RavuAlHemio/eprom5vread/board/eprom5vread.kicad_pcb

## KiCad design board/eprom5vread.kicad_pcb (2024-02-01)

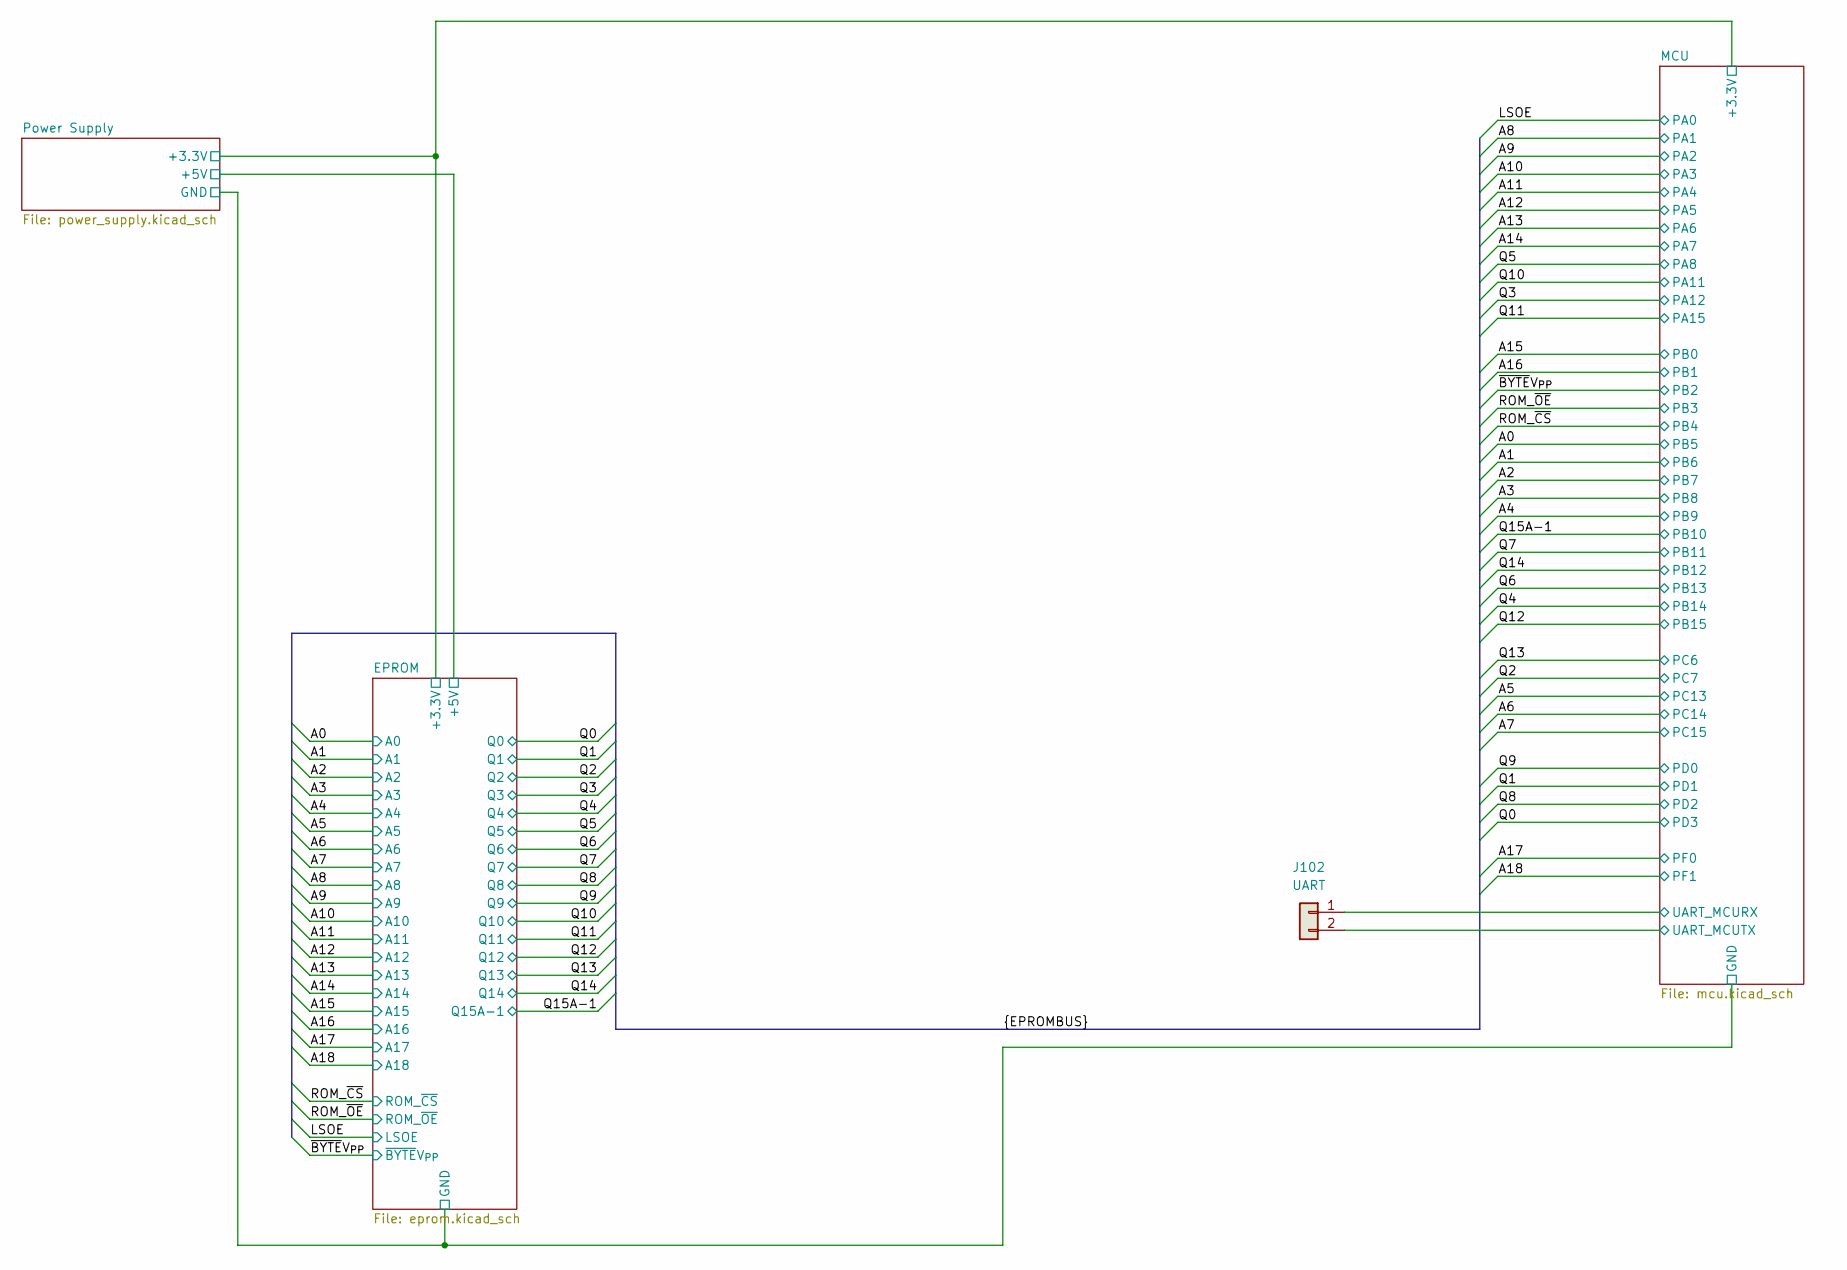
[picture p1: schematic eprom5vread.kicad_sch]

Parts:
J102: UART; PinHeader_2x01_P2.54mm_Vertical_SMD; LCSC C2884014

Connections:
/MCU/UART_MCURX: J102.1; also elsewhere on the board
/MCU/UART_MCUTX: J102.2; also elsewhere on the board

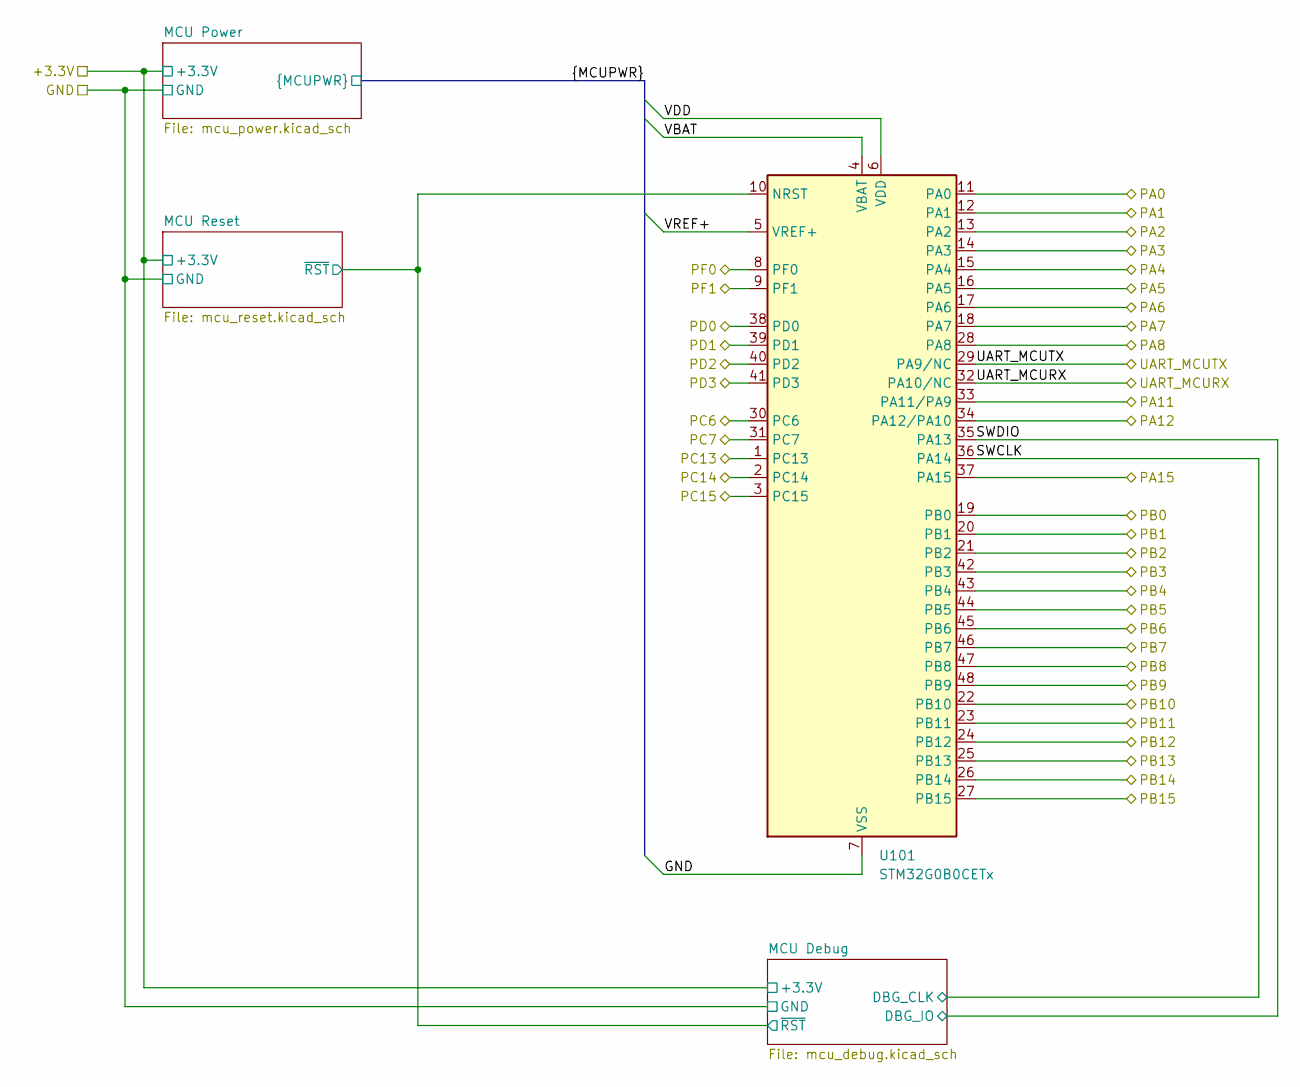
[picture p2: schematic mcu.kicad_sch]

Parts:
U101: STM32G0B0CETx; LQFP-48_7x7mm_P0.5mm; LCSC C2826978

Connections:
/A0: U101.44 (PB5); also elsewhere on the board
/A1: U101.45 (PB6); also elsewhere on the board
/A2: U101.46 (PB7); also elsewhere on the board
/A3: U101.47 (PB8); also elsewhere on the board
/A4: U101.48 (PB9); also elsewhere on the board
/A5: U101.1 (PC13); also elsewhere on the board
/A6: U101.2 (PC14); also elsewhere on the board
/A7: U101.3 (PC15); also elsewhere on the board
/A8: U101.12 (PA1); also elsewhere on the board
/A9: U101.13 (PA2); also elsewhere on the board
/A10: U101.14 (PA3); also elsewhere on the board
/A11: U101.15 (PA4); also elsewhere on the board
/A12: U101.16 (PA5); also elsewhere on the board
/A13: U101.17 (PA6); also elsewhere on the board
/A14: U101.18 (PA7); also elsewhere on the board
/A15: U101.19 (PB0); also elsewhere on the board
/A16: U101.20 (PB1); also elsewhere on the board
/A17: U101.8 (PF0); also elsewhere on the board
/A18: U101.9 (PF1); also elsewhere on the board
/EPROM/GND: U101.7 (VSS); also elsewhere on the board
/LSOE: U101.11 (PA0); also elsewhere on the board
/MCU/MCU Debug/~RST: U101.10 (NRST); also elsewhere on the board
/MCU/SWCLK: U101.36 (PA14); also elsewhere on the board
/MCU/SWDIO: U101.35 (PA13); also elsewhere on the board
/MCU/UART_MCURX: U101.32 (PA10/NC); also elsewhere on the board
/MCU/UART_MCUTX: U101.29 (PA9/NC); also elsewhere on the board
/MCU/VBAT: U101.4 (VBAT); also elsewhere on the board
/MCU/VDD: U101.6 (VDD); also elsewhere on the board
/MCU/VREF+: U101.5 (VREF+); also elsewhere on the board
/Q0: U101.41 (PD3); also elsewhere on the board
/Q1: U101.39 (PD1); also elsewhere on the board
/Q2: U101.31 (PC7); also elsewhere on the board
/Q3: U101.34 (PA12/PA10); also elsewhere on the board
/Q4: U101.26 (PB14); also elsewhere on the board
/Q5: U101.28 (PA8); also elsewhere on the board
/Q6: U101.25 (PB13); also elsewhere on the board
/Q7: U101.23 (PB11); also elsewhere on the board
/Q8: U101.40 (PD2); also elsewhere on the board
/Q9: U101.38 (PD0); also elsewhere on the board
/Q10: U101.33 (PA11/PA9); also elsewhere on the board
/Q11: U101.37 (PA15); also elsewhere on the board
/Q12: U101.27 (PB15); also elsewhere on the board
/Q13: U101.30 (PC6); also elsewhere on the board
/Q14: U101.24 (PB12); also elsewhere on the board
/Q15A-1: U101.22 (PB10); also elsewhere on the board
/ROM_~CS: U101.43 (PB4); also elsewhere on the board
/ROM_~OE: U101.42 (PB3); also elsewhere on the board
/~BYTEV_{PP}: U101.21 (PB2); also elsewhere on the board

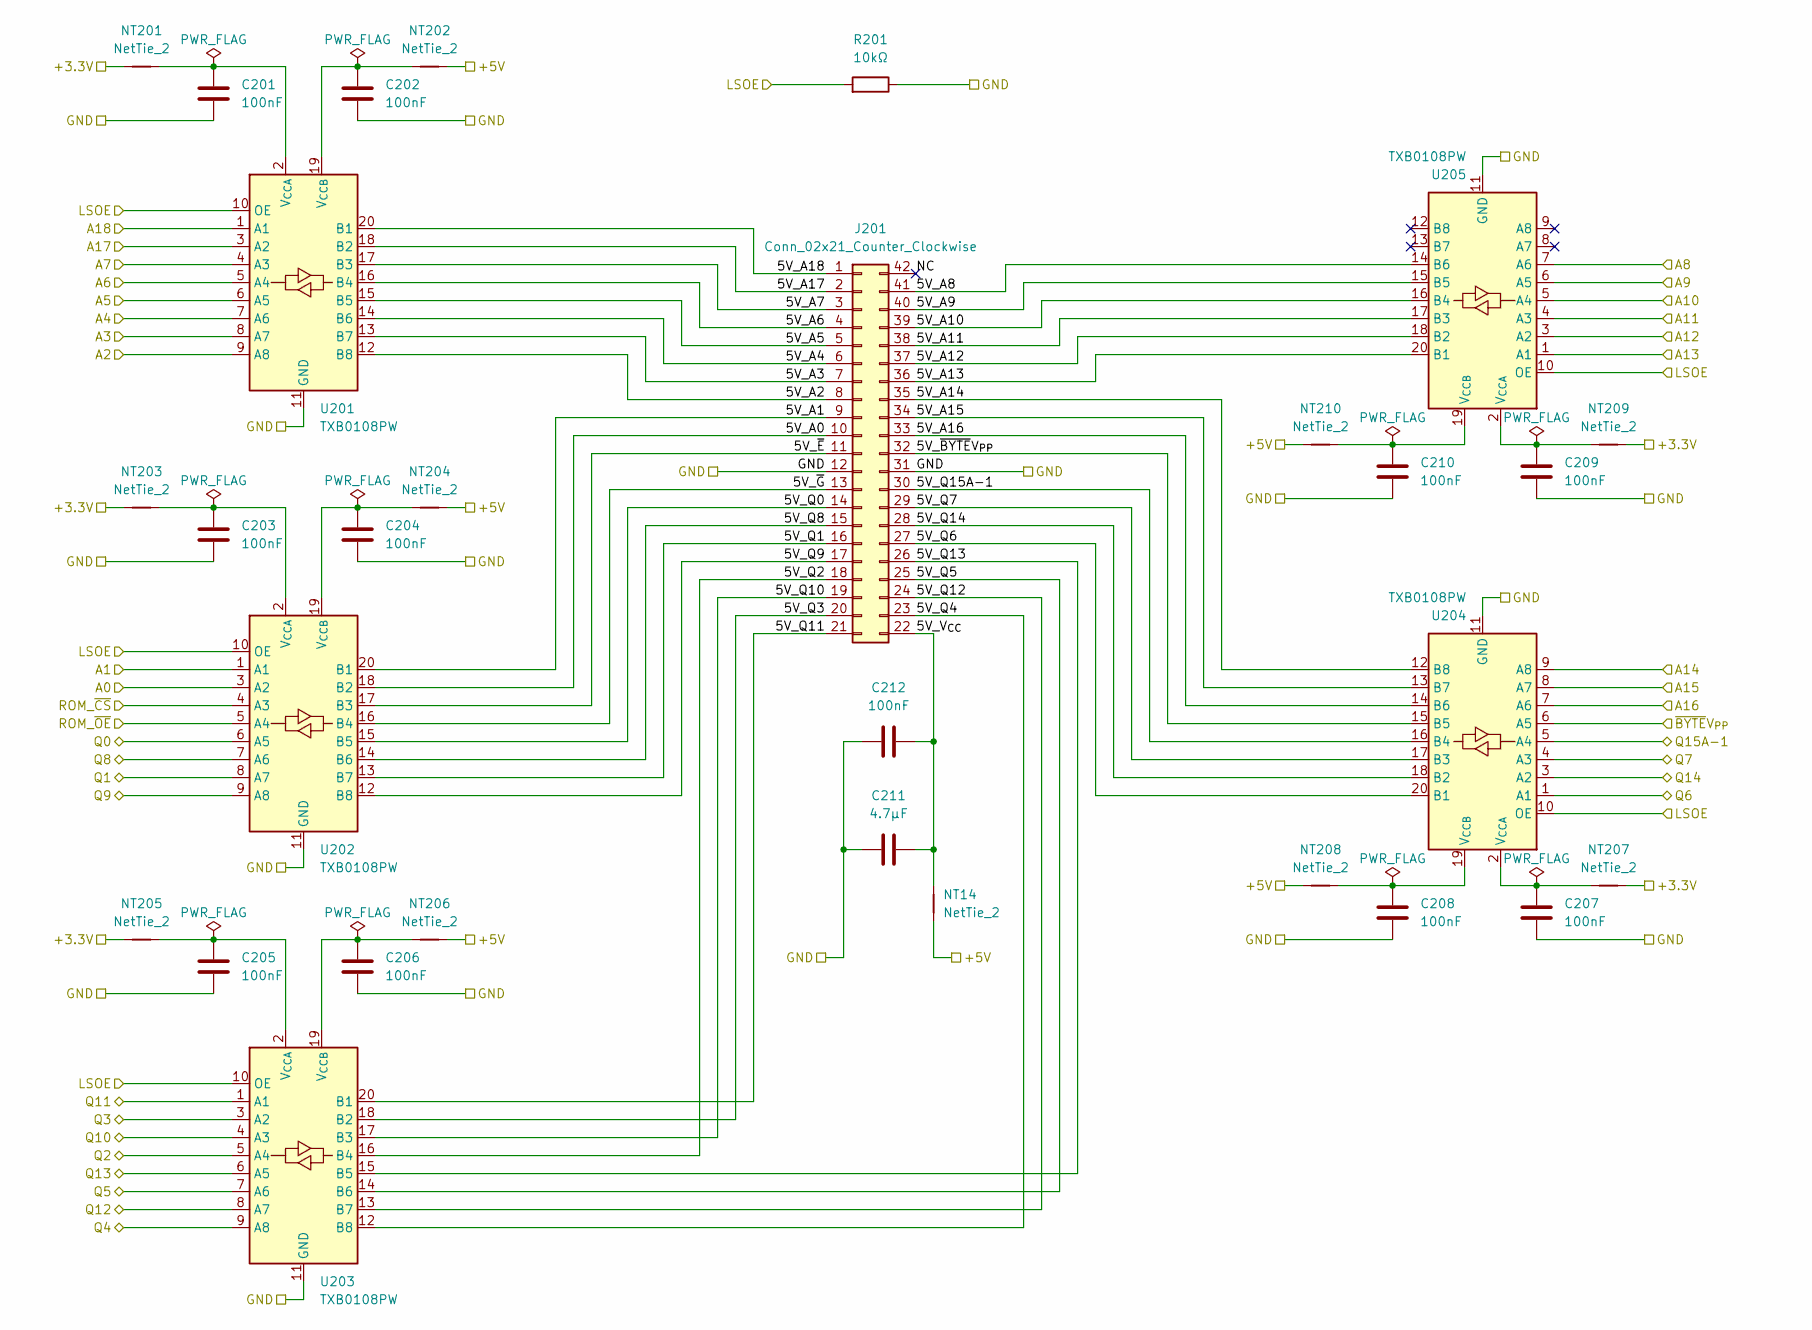
[picture p3: schematic eprom.kicad_sch]

Parts:
C201, C202, C203, C204, C205, C206, C207, C208, C209, C210, C212: 100nF; C_0402_1005Metric; LCSC C307331
C211: 4.7µF; C_0402_1005Metric; LCSC C23733
J201: Conn_02x21_Counter_Clockwise; DIP-42_W15.24mm_Socket
NT14, NT201, NT202, NT203, NT204, NT205, NT206, NT207, NT208, NT209, NT210: NetTie_2; NetTie-2_SMD_Pad0.5mm
R201: 10kΩ; R_0402_1005Metric; LCSC C100572
U201, U202, U203, U204, U205: TXB0108PW; TSSOP-20_4.4x6.5mm_P0.65mm; LCSC C53406

Connections:
/A0: U202.3 (A2); also elsewhere on the board
/A1: U202.1 (A1); also elsewhere on the board
/A2: U201.9 (A8); also elsewhere on the board
/A3: U201.8 (A7); also elsewhere on the board
/A4: U201.7 (A6); also elsewhere on the board
/A5: U201.6 (A5); also elsewhere on the board
/A6: U201.5 (A4); also elsewhere on the board
/A7: U201.4 (A3); also elsewhere on the board
/A8: U205.7 (A6); also elsewhere on the board
/A9: U205.6 (A5); also elsewhere on the board
/A10: U205.5 (A4); also elsewhere on the board
/A11: U205.4 (A3); also elsewhere on the board
/A12: U205.3 (A2); also elsewhere on the board
/A13: U205.1 (A1); also elsewhere on the board
/A14: U204.9 (A8); also elsewhere on the board
/A15: U204.8 (A7); also elsewhere on the board
/A16: U204.7 (A6); also elsewhere on the board
/A17: U201.3 (A2); also elsewhere on the board
/A18: U201.1 (A1); also elsewhere on the board
/EPROM/5V_A0: J201.10, U202.18 (B2)
/EPROM/5V_A1: J201.9, U202.20 (B1)
/EPROM/5V_A2: J201.8, U201.12 (B8)
/EPROM/5V_A3: J201.7, U201.13 (B7)
/EPROM/5V_A4: J201.6, U201.14 (B6)
/EPROM/5V_A5: J201.5, U201.15 (B5)
/EPROM/5V_A6: J201.4, U201.16 (B4)
/EPROM/5V_A7: J201.3, U201.17 (B3)
/EPROM/5V_A8: J201.41, U205.14 (B6)
/EPROM/5V_A9: J201.40, U205.15 (B5)
/EPROM/5V_A10: J201.39, U205.16 (B4)
/EPROM/5V_A11: J201.38, U205.17 (B3)
/EPROM/5V_A12: J201.37, U205.18 (B2)
/EPROM/5V_A13: J201.36, U205.20 (B1)
/EPROM/5V_A14: J201.35, U204.12 (B8)
/EPROM/5V_A15: J201.34, U204.13 (B7)
/EPROM/5V_A16: J201.33, U204.14 (B6)
/EPROM/5V_A17: J201.2, U201.18 (B2)
/EPROM/5V_A18: J201.1, U201.20 (B1)
/EPROM/5V_Q0: J201.14, U202.15 (B5)
/EPROM/5V_Q1: J201.16, U202.13 (B7)
/EPROM/5V_Q2: J201.18, U203.16 (B4)
/EPROM/5V_Q3: J201.20, U203.18 (B2)
/EPROM/5V_Q4: J201.23, U203.12 (B8)
/EPROM/5V_Q5: J201.25, U203.14 (B6)
/EPROM/5V_Q6: J201.27, U204.20 (B1)
/EPROM/5V_Q7: J201.29, U204.17 (B3)
/EPROM/5V_Q8: J201.15, U202.14 (B6)
/EPROM/5V_Q9: J201.17, U202.12 (B8)
/EPROM/5V_Q10: J201.19, U203.17 (B3)
/EPROM/5V_Q11: J201.21, U203.20 (B1)
/EPROM/5V_Q12: J201.24, U203.13 (B7)
/EPROM/5V_Q13: J201.26, U203.15 (B5)
/EPROM/5V_Q14: J201.28, U204.18 (B2)
/EPROM/5V_Q15A-1: J201.30, U204.16 (B4)
/EPROM/5V_V_{CC}: C211.2, C212.2, J201.22, NT14.2
/EPROM/5V_~BYTEV_{PP}: J201.32, U204.15 (B5)
/EPROM/5V_~E: J201.11, U202.17 (B3)
/EPROM/5V_~G: J201.13, U202.16 (B4)
/EPROM/+3.3V: NT201.1, NT203.1, NT205.1, NT207.2, NT209.2; also elsewhere on the board
/EPROM/+5V: NT14.1, NT202.2, NT204.2, NT206.2, NT208.1, NT210.1; also elsewhere on the board
/EPROM/GND: C201.2, C202.2, C203.2, C204.2, C205.2, C206.2, C207.2, C208.2, C209.2, C210.2, C211.1, C212.1, J201.12, J201.31, R201.1, U201.11 (GND), U202.11 (GND), U203.11 (GND), U204.11 (GND), U205.11 (GND); also elsewhere on the board
/EPROM/NC: J201.42
/LSOE: R201.2, U201.10 (OE), U202.10 (OE), U203.10 (OE), U204.10 (OE), U205.10 (OE); also elsewhere on the board
/Q0: U202.6 (A5); also elsewhere on the board
/Q1: U202.8 (A7); also elsewhere on the board
/Q2: U203.5 (A4); also elsewhere on the board
/Q3: U203.3 (A2); also elsewhere on the board
/Q4: U203.9 (A8); also elsewhere on the board
/Q5: U203.7 (A6); also elsewhere on the board
/Q6: U204.1 (A1); also elsewhere on the board
/Q7: U204.4 (A3); also elsewhere on the board
/Q8: U202.7 (A6); also elsewhere on the board
/Q9: U202.9 (A8); also elsewhere on the board
/Q10: U203.4 (A3); also elsewhere on the board
/Q11: U203.1 (A1); also elsewhere on the board
/Q12: U203.8 (A7); also elsewhere on the board
/Q13: U203.6 (A5); also elsewhere on the board
/Q14: U204.3 (A2); also elsewhere on the board
/Q15A-1: U204.5 (A4); also elsewhere on the board
/ROM_~CS: U202.4 (A3); also elsewhere on the board
/ROM_~OE: U202.5 (A4); also elsewhere on the board
/~BYTEV_{PP}: U204.6 (A5); also elsewhere on the board
unnamed: C201.1, NT201.2, U201.2 (V_{CCA})
unnamed: C202.1, NT202.1, U201.19 (V_{CCB})
unnamed: C203.1, NT203.2, U202.2 (V_{CCA})
unnamed: C204.1, NT204.1, U202.19 (V_{CCB})
unnamed: C205.1, NT205.2, U203.2 (V_{CCA})
unnamed: C206.1, NT206.1, U203.19 (V_{CCB})
unnamed: C207.1, NT207.1, U204.2 (V_{CCA})
unnamed: C208.1, NT208.2, U204.19 (V_{CCB})
unnamed: C209.1, NT209.1, U205.2 (V_{CCA})
unnamed: C210.1, NT210.2, U205.19 (V_{CCB})

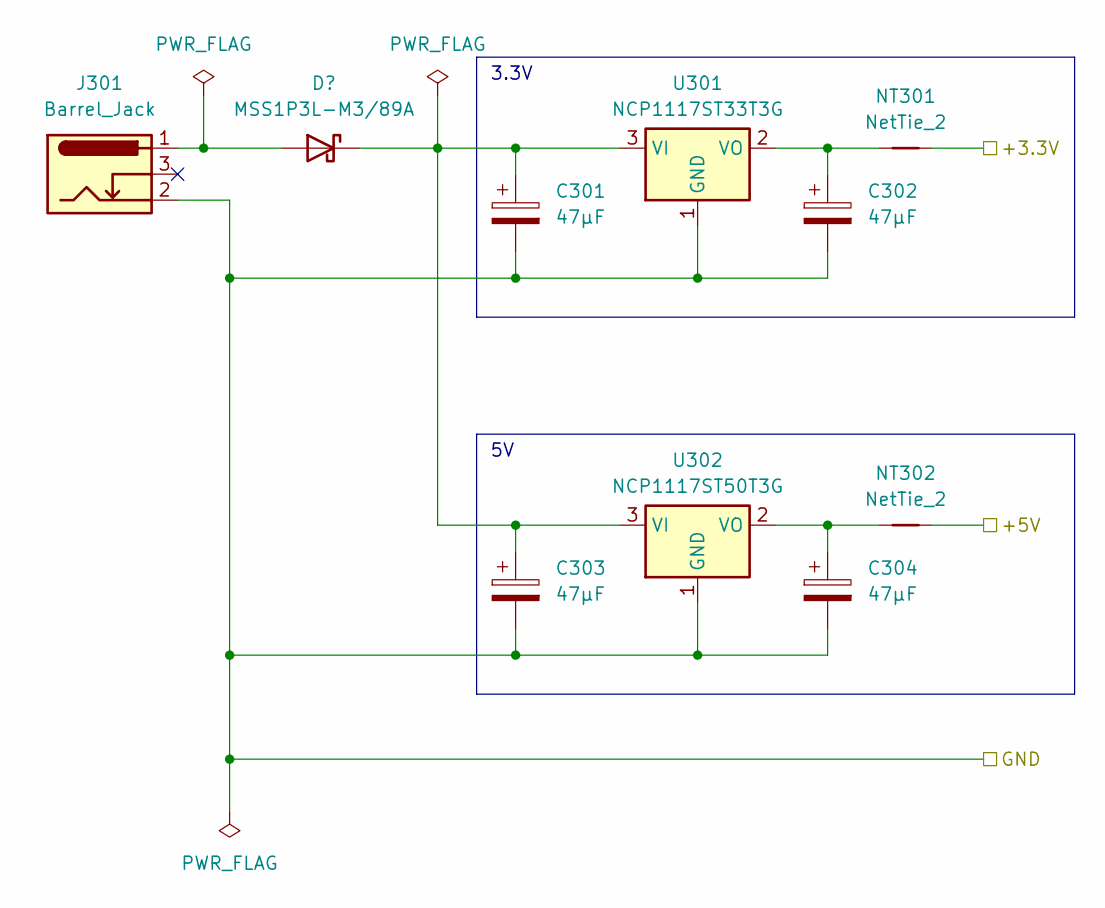
[picture p4: schematic power_supply.kicad_sch]

Parts:
C301, C302, C303, C304: 47µF; CP_EIA-7343-31_Kemet-D; LCSC C122333
D301: MSS1P3L-M3/89A; D_MicroSMP_AK; LCSC C144285
J301: Barrel_Jack; BarrelJack_CUI_PJ-036AH-SMT_Horizontal; LCSC C9900024875
NT301, NT302: NetTie_2; NetTie-2_SMD_Pad0.5mm
U301: NCP1117ST33T3G; SOT-223-3_TabPin2; LCSC C26537
U302: NCP1117ST50T3G; SOT-223-3_TabPin2; LCSC C17314

Connections:
/EPROM/+3.3V: NT301.2; also elsewhere on the board
/EPROM/+5V: NT302.2; also elsewhere on the board
/EPROM/GND: C301.2, C302.2, C303.2, C304.2, J301.2, U301.1 (GND), U302.1 (GND); also elsewhere on the board
unnamed: D301.2 (A), J301.1
unnamed: C301.1, C303.1, D301.1 (K), U301.3 (VI), U302.3 (VI)
unnamed: C302.1, NT301.1, U301.2 (VO)
unnamed: C304.1, NT302.1, U302.2 (VO)

Notes on the sheet:
3.3V

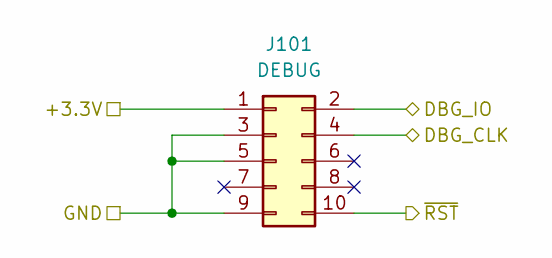
[picture p5: schematic mcu_debug.kicad_sch]

Parts:
J101: DEBUG; PinHeader_2x05_P1.27mm_Vertical_SMD

Connections:
/EPROM/+3.3V: J101.1; also elsewhere on the board
/EPROM/GND: J101.3, J101.5, J101.9; also elsewhere on the board
/MCU/MCU Debug/~RST: J101.10; also elsewhere on the board
/MCU/SWCLK: J101.4; also elsewhere on the board
/MCU/SWDIO: J101.2; also elsewhere on the board

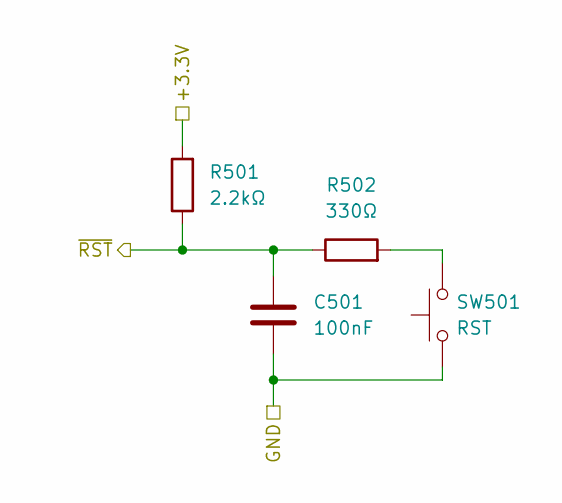
[picture p6: schematic mcu_reset.kicad_sch]

Parts:
C501: 100nF; C_0402_1005Metric; LCSC C307331
R501: 2.2kΩ; R_0402_1005Metric; LCSC C25879
R502: 330Ω; R_0402_1005Metric; LCSC C25104
SW501: RST; SW_Push_1P1T_XKB_TS-1187A; LCSC C318884

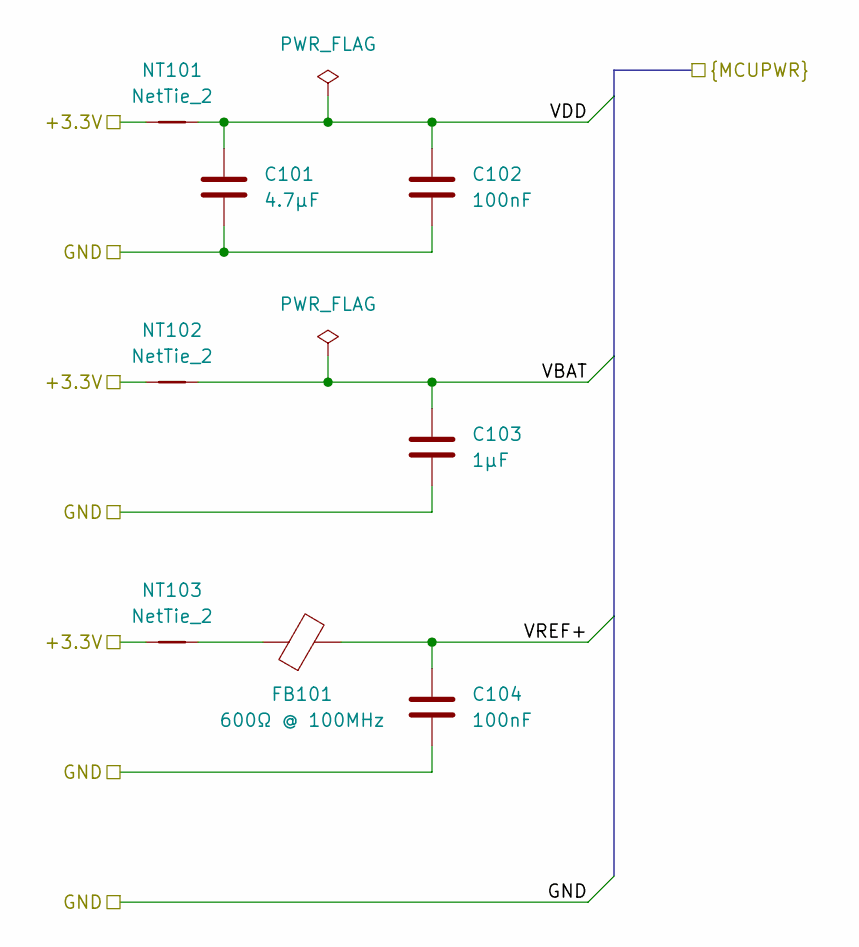
[picture p7: schematic mcu_power.kicad_sch]

Parts:
C101: 4.7µF; C_0402_1005Metric; LCSC C23733
C102, C104: 100nF; C_0402_1005Metric; LCSC C307331
C103: 1µF; C_0402_1005Metric; LCSC C52923
FB101: 600Ω @ 100MHz; L_0402_1005Metric; LCSC C98261
NT101, NT102, NT103: NetTie_2; NetTie-2_SMD_Pad0.5mm

Connections:
/EPROM/+3.3V: NT101.1, NT102.1, NT103.1; also elsewhere on the board
/EPROM/GND: C101.2, C102.2, C103.2, C104.2; also elsewhere on the board
/MCU/VBAT: C103.1, NT102.2; also elsewhere on the board
/MCU/VDD: C101.1, C102.1, NT101.2; also elsewhere on the board
/MCU/VREF+: C104.1, FB101.2; also elsewhere on the board
unnamed: FB101.1, NT103.2

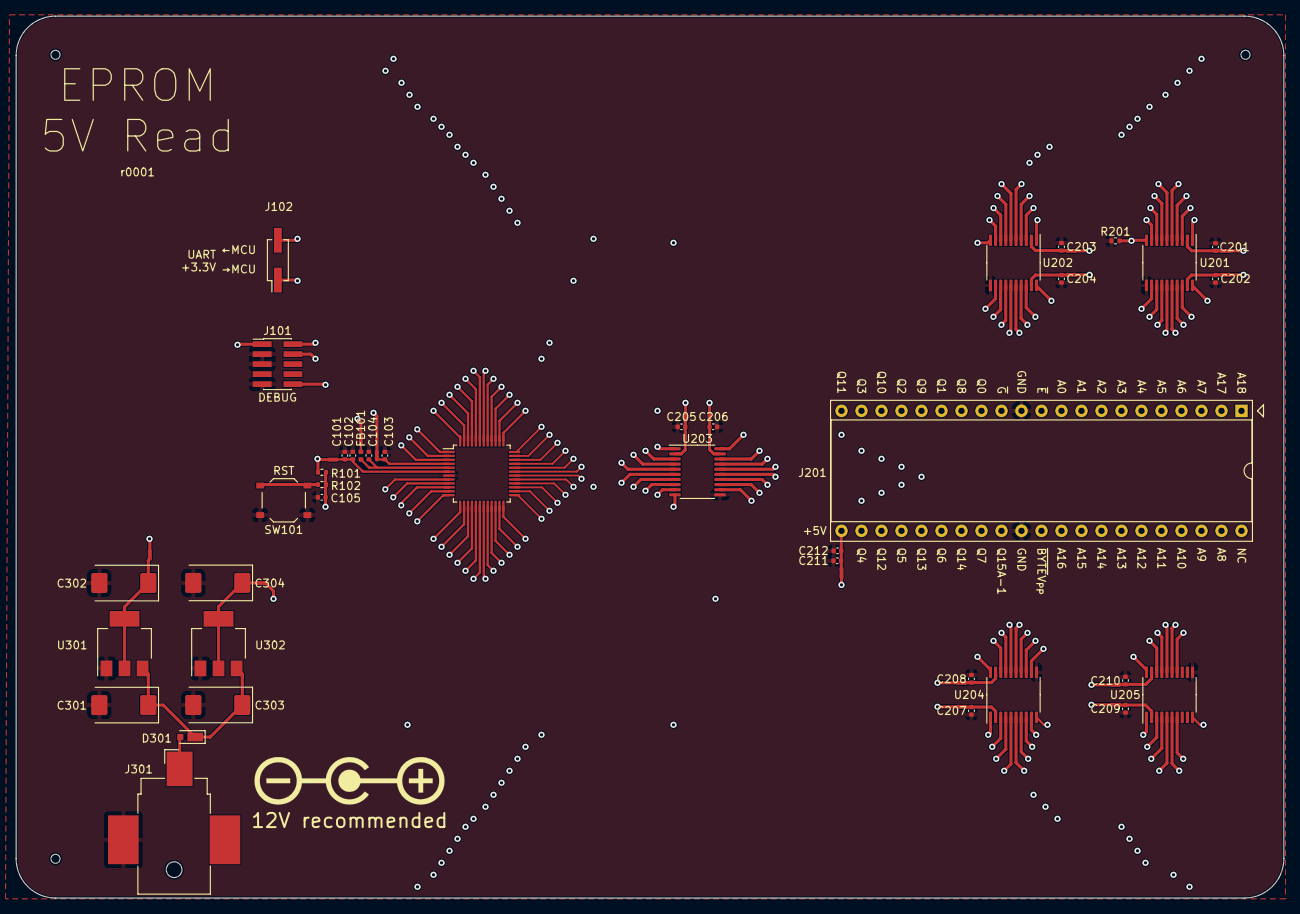
[picture p8: board eprom5vread.kicad_pcb from above]

Board: 4 copper layers, 161.0 x 112.0 mm, 59 parts (0 on the bottom side), 105 nets.

Other parts of the board:
C105: 100nF; C_0402_1005Metric
R101: 2.2kΩ; R_0402_1005Metric
R102: 330Ω; R_0402_1005Metric
REF1, REF2, REF3: JLCPCB_Mounting_Hole
REF4: Polarity_Center_Positive_6mm_SilkScreen
SW101: RST; SW_Push_1P1T_XKB_TS-1187A

Their connections:
/EPROM/+3.3V: R101.2; also elsewhere on the board
/EPROM/GND: C105.1, SW101.1; also elsewhere on the board
/MCU/MCU Debug/~RST: C105.2, R101.1, R102.1; also elsewhere on the board
unnamed: R102.2, SW101.2
