RavuAlHemio/eprom5vread/code/on_board/stm32g0b0/src/adc/adc_awd2cr.rs

#[doc = "Register `ADC_AWD2CR` reader"]
pub type R = crate::R<ADC_AWD2CR_SPEC>;
#[doc = "Register `ADC_AWD2CR` writer"]
pub type W = crate::W<ADC_AWD2CR_SPEC>;
#[doc = "Field `AWD2CH0` reader - Analog watchdog channel selection These bits are set and cleared by software. They enable and select the input channels to be guarded by analog watchdog 2 (AWD2). Note: The channels selected through ADC_AWD2CR must be also configured into the ADC_CHSELR registers. Refer to SQ8\\[3:0\\]
for a definition of channel selection. The software is allowed to write this bit only when ADSTART=0 (which ensures that no conversion is ongoing)."]
pub type AWD2CH0_R = crate::BitReader<AWD2CH0_A>;
#[doc = "Analog watchdog channel selection These bits are set and cleared by software. They enable and select the input channels to be guarded by analog watchdog 2 (AWD2). Note: The channels selected through ADC_AWD2CR must be also configured into the ADC_CHSELR registers. Refer to SQ8\\[3:0\\]
for a definition of channel selection. The software is allowed to write this bit only when ADSTART=0 (which ensures that no conversion is ongoing).\n\nValue on reset: 0"]
#[derive(Clone, Copy, Debug, PartialEq, Eq)]
pub enum AWD2CH0_A {
    #[doc = "0: ADC analog channel-x is not monitored by AWD2"]
    B_0X0 = 0,
    #[doc = "1: ADC analog channel-x is monitored by AWD2"]
    B_0X1 = 1,
}
impl From<AWD2CH0_A> for bool {
    #[inline(always)]
    fn from(variant: AWD2CH0_A) -> Self {
        variant as u8 != 0
    }
}
impl AWD2CH0_R {
    #[doc = "Get enumerated values variant"]
    #[inline(always)]
    pub const fn variant(&self) -> AWD2CH0_A {
        match self.bits {
            false => AWD2CH0_A::B_0X0,
            true => AWD2CH0_A::B_0X1,
        }
    }
    #[doc = "ADC analog channel-x is not monitored by AWD2"]
    #[inline(always)]
    pub fn is_b_0x0(&self) -> bool {
        *self == AWD2CH0_A::B_0X0
    }
    #[doc = "ADC analog channel-x is monitored by AWD2"]
    #[inline(always)]
    pub fn is_b_0x1(&self) -> bool {
        *self == AWD2CH0_A::B_0X1
    }
}
#[doc = "Field `AWD2CH0` writer - Analog watchdog channel selection These bits are set and cleared by software. They enable and select the input channels to be guarded by analog watchdog 2 (AWD2). Note: The channels selected through ADC_AWD2CR must be also configured into the ADC_CHSELR registers. Refer to SQ8\\[3:0\\]
for a definition of channel selection. The software is allowed to write this bit only when ADSTART=0 (which ensures that no conversion is ongoing)."]
pub type AWD2CH0_W<'a, REG> = crate::BitWriter<'a, REG, AWD2CH0_A>;
impl<'a, REG> AWD2CH0_W<'a, REG>
where
    REG: crate::Writable + crate::RegisterSpec,
{
    #[doc = "ADC analog channel-x is not monitored by AWD2"]
    #[inline(always)]
    pub fn b_0x0(self) -> &'a mut crate::W<REG> {
        self.variant(AWD2CH0_A::B_0X0)
    }
    #[doc = "ADC analog channel-x is monitored by AWD2"]
    #[inline(always)]
    pub fn b_0x1(self) -> &'a mut crate::W<REG> {
        self.variant(AWD2CH0_A::B_0X1)
    }
}
#[doc = "Field `AWD2CH1` reader - Analog watchdog channel selection These bits are set and cleared by software. They enable and select the input channels to be guarded by analog watchdog 2 (AWD2). Note: The channels selected through ADC_AWD2CR must be also configured into the ADC_CHSELR registers. Refer to SQ8\\[3:0\\]
for a definition of channel selection. The software is allowed to write this bit only when ADSTART=0 (which ensures that no conversion is ongoing)."]
pub type AWD2CH1_R = crate::BitReader<AWD2CH1_A>;
#[doc = "Analog watchdog channel selection These bits are set and cleared by software. They enable and select the input channels to be guarded by analog watchdog 2 (AWD2). Note: The channels selected through ADC_AWD2CR must be also configured into the ADC_CHSELR registers. Refer to SQ8\\[3:0\\]
for a definition of channel selection. The software is allowed to write this bit only when ADSTART=0 (which ensures that no conversion is ongoing).\n\nValue on reset: 0"]
#[derive(Clone, Copy, Debug, PartialEq, Eq)]
pub enum AWD2CH1_A {
    #[doc = "0: ADC analog channel-x is not monitored by AWD2"]
    B_0X0 = 0,
    #[doc = "1: ADC analog channel-x is monitored by AWD2"]
    B_0X1 = 1,
}
impl From<AWD2CH1_A> for bool {
    #[inline(always)]
    fn from(variant: AWD2CH1_A) -> Self {
        variant as u8 != 0
    }
}
impl AWD2CH1_R {
    #[doc = "Get enumerated values variant"]
    #[inline(always)]
    pub const fn variant(&self) -> AWD2CH1_A {
        match self.bits {
            false => AWD2CH1_A::B_0X0,
            true => AWD2CH1_A::B_0X1,
        }
    }
    #[doc = "ADC analog channel-x is not monitored by AWD2"]
    #[inline(always)]
    pub fn is_b_0x0(&self) -> bool {
        *self == AWD2CH1_A::B_0X0
    }
    #[doc = "ADC analog channel-x is monitored by AWD2"]
    #[inline(always)]
    pub fn is_b_0x1(&self) -> bool {
        *self == AWD2CH1_A::B_0X1
    }
}
#[doc = "Field `AWD2CH1` writer - Analog watchdog channel selection These bits are set and cleared by software. They enable and select the input channels to be guarded by analog watchdog 2 (AWD2). Note: The channels selected through ADC_AWD2CR must be also configured into the ADC_CHSELR registers. Refer to SQ8\\[3:0\\]
for a definition of channel selection. The software is allowed to write this bit only when ADSTART=0 (which ensures that no conversion is ongoing)."]
pub type AWD2CH1_W<'a, REG> = crate::BitWriter<'a, REG, AWD2CH1_A>;
impl<'a, REG> AWD2CH1_W<'a, REG>
where
    REG: crate::Writable + crate::RegisterSpec,
{
    #[doc = "ADC analog channel-x is not monitored by AWD2"]
    #[inline(always)]
    pub fn b_0x0(self) -> &'a mut crate::W<REG> {
        self.variant(AWD2CH1_A::B_0X0)
    }
    #[doc = "ADC analog channel-x is monitored by AWD2"]
    #[inline(always)]
    pub fn b_0x1(self) -> &'a mut crate::W<REG> {
        self.variant(AWD2CH1_A::B_0X1)
    }
}
#[doc = "Field `AWD2CH2` reader - Analog watchdog channel selection These bits are set and cleared by software. They enable and select the input channels to be guarded by analog watchdog 2 (AWD2). Note: The channels selected through ADC_AWD2CR must be also configured into the ADC_CHSELR registers. Refer to SQ8\\[3:0\\]
for a definition of channel selection. The software is allowed to write this bit only when ADSTART=0 (which ensures that no conversion is ongoing)."]
pub type AWD2CH2_R = crate::BitReader<AWD2CH2_A>;
#[doc = "Analog watchdog channel selection These bits are set and cleared by software. They enable and select the input channels to be guarded by analog watchdog 2 (AWD2). Note: The channels selected through ADC_AWD2CR must be also configured into the ADC_CHSELR registers. Refer to SQ8\\[3:0\\]
for a definition of channel selection. The software is allowed to write this bit only when ADSTART=0 (which ensures that no conversion is ongoing).\n\nValue on reset: 0"]
#[derive(Clone, Copy, Debug, PartialEq, Eq)]
pub enum AWD2CH2_A {
    #[doc = "0: ADC analog channel-x is not monitored by AWD2"]
    B_0X0 = 0,
    #[doc = "1: ADC analog channel-x is monitored by AWD2"]
    B_0X1 = 1,
}
impl From<AWD2CH2_A> for bool {
    #[inline(always)]
    fn from(variant: AWD2CH2_A) -> Self {
        variant as u8 != 0
    }
}
impl AWD2CH2_R {
    #[doc = "Get enumerated values variant"]
    #[inline(always)]
    pub const fn variant(&self) -> AWD2CH2_A {
        match self.bits {
            false => AWD2CH2_A::B_0X0,
            true => AWD2CH2_A::B_0X1,
        }
    }
    #[doc = "ADC analog channel-x is not monitored by AWD2"]
    #[inline(always)]
    pub fn is_b_0x0(&self) -> bool {
        *self == AWD2CH2_A::B_0X0
    }
    #[doc = "ADC analog channel-x is monitored by AWD2"]
    #[inline(always)]
    pub fn is_b_0x1(&self) -> bool {
        *self == AWD2CH2_A::B_0X1
    }
}
#[doc = "Field `AWD2CH2` writer - Analog watchdog channel selection These bits are set and cleared by software. They enable and select the input channels to be guarded by analog watchdog 2 (AWD2). Note: The channels selected through ADC_AWD2CR must be also configured into the ADC_CHSELR registers. Refer to SQ8\\[3:0\\]
for a definition of channel selection. The software is allowed to write this bit only when ADSTART=0 (which ensures that no conversion is ongoing)."]
pub type AWD2CH2_W<'a, REG> = crate::BitWriter<'a, REG, AWD2CH2_A>;
impl<'a, REG> AWD2CH2_W<'a, REG>
where
    REG: crate::Writable + crate::RegisterSpec,
{
    #[doc = "ADC analog channel-x is not monitored by AWD2"]
    #[inline(always)]
    pub fn b_0x0(self) -> &'a mut crate::W<REG> {
        self.variant(AWD2CH2_A::B_0X0)
    }
    #[doc = "ADC analog channel-x is monitored by AWD2"]
    #[inline(always)]
    pub fn b_0x1(self) -> &'a mut crate::W<REG> {
        self.variant(AWD2CH2_A::B_0X1)
    }
}
#[doc = "Field `AWD2CH3` reader - Analog watchdog channel selection These bits are set and cleared by software. They enable and select the input channels to be guarded by analog watchdog 2 (AWD2). Note: The channels selected through ADC_AWD2CR must be also configured into the ADC_CHSELR registers. Refer to SQ8\\[3:0\\]
for a definition of channel selection. The software is allowed to write this bit only when ADSTART=0 (which ensures that no conversion is ongoing)."]
pub type AWD2CH3_R = crate::BitReader<AWD2CH3_A>;
#[doc = "Analog watchdog channel selection These bits are set and cleared by software. They enable and select the input channels to be guarded by analog watchdog 2 (AWD2). Note: The channels selected through ADC_AWD2CR must be also configured into the ADC_CHSELR registers. Refer to SQ8\\[3:0\\]
for a definition of channel selection. The software is allowed to write this bit only when ADSTART=0 (which ensures that no conversion is ongoing).\n\nValue on reset: 0"]
#[derive(Clone, Copy, Debug, PartialEq, Eq)]
pub enum AWD2CH3_A {
    #[doc = "0: ADC analog channel-x is not monitored by AWD2"]
    B_0X0 = 0,
    #[doc = "1: ADC analog channel-x is monitored by AWD2"]
    B_0X1 = 1,
}
impl From<AWD2CH3_A> for bool {
    #[inline(always)]
    fn from(variant: AWD2CH3_A) -> Self {
        variant as u8 != 0
    }
}
impl AWD2CH3_R {
    #[doc = "Get enumerated values variant"]
    #[inline(always)]
    pub const fn variant(&self) -> AWD2CH3_A {
        match self.bits {
            false => AWD2CH3_A::B_0X0,
            true => AWD2CH3_A::B_0X1,
        }
    }
    #[doc = "ADC analog channel-x is not monitored by AWD2"]
    #[inline(always)]
    pub fn is_b_0x0(&self) -> bool {
        *self == AWD2CH3_A::B_0X0
    }
    #[doc = "ADC analog channel-x is monitored by AWD2"]
    #[inline(always)]
    pub fn is_b_0x1(&self) -> bool {
        *self == AWD2CH3_A::B_0X1
    }
}
#[doc = "Field `AWD2CH3` writer - Analog watchdog channel selection These bits are set and cleared by software. They enable and select the input channels to be guarded by analog watchdog 2 (AWD2). Note: The channels selected through ADC_AWD2CR must be also configured into the ADC_CHSELR registers. Refer to SQ8\\[3:0\\]
for a definition of channel selection. The software is allowed to write this bit only when ADSTART=0 (which ensures that no conversion is ongoing)."]
pub type AWD2CH3_W<'a, REG> = crate::BitWriter<'a, REG, AWD2CH3_A>;
impl<'a, REG> AWD2CH3_W<'a, REG>
where
    REG: crate::Writable + crate::RegisterSpec,
{
    #[doc = "ADC analog channel-x is not monitored by AWD2"]
    #[inline(always)]
    pub fn b_0x0(self) -> &'a mut crate::W<REG> {
        self.variant(AWD2CH3_A::B_0X0)
    }
    #[doc = "ADC analog channel-x is monitored by AWD2"]
    #[inline(always)]
    pub fn b_0x1(self) -> &'a mut crate::W<REG> {
        self.variant(AWD2CH3_A::B_0X1)
    }
}
#[doc = "Field `AWD2CH4` reader - Analog watchdog channel selection These bits are set and cleared by software. They enable and select the input channels to be guarded by analog watchdog 2 (AWD2). Note: The channels selected through ADC_AWD2CR must be also configured into the ADC_CHSELR registers. Refer to SQ8\\[3:0\\]
for a definition of channel selection. The software is allowed to write this bit only when ADSTART=0 (which ensures that no conversion is ongoing)."]
pub type AWD2CH4_R = crate::BitReader<AWD2CH4_A>;
#[doc = "Analog watchdog channel selection These bits are set and cleared by software. They enable and select the input channels to be guarded by analog watchdog 2 (AWD2). Note: The channels selected through ADC_AWD2CR must be also configured into the ADC_CHSELR registers. Refer to SQ8\\[3:0\\]
for a definition of channel selection. The software is allowed to write this bit only when ADSTART=0 (which ensures that no conversion is ongoing).\n\nValue on reset: 0"]
#[derive(Clone, Copy, Debug, PartialEq, Eq)]
pub enum AWD2CH4_A {
    #[doc = "0: ADC analog channel-x is not monitored by AWD2"]
    B_0X0 = 0,
    #[doc = "1: ADC analog channel-x is monitored by AWD2"]
    B_0X1 = 1,
}
impl From<AWD2CH4_A> for bool {
    #[inline(always)]
    fn from(variant: AWD2CH4_A) -> Self {
        variant as u8 != 0
    }
}
impl AWD2CH4_R {
    #[doc = "Get enumerated values variant"]
    #[inline(always)]
    pub const fn variant(&self) -> AWD2CH4_A {
        match self.bits {
            false => AWD2CH4_A::B_0X0,
            true => AWD2CH4_A::B_0X1,
        }
    }
    #[doc = "ADC analog channel-x is not monitored by AWD2"]
    #[inline(always)]
    pub fn is_b_0x0(&self) -> bool {
        *self == AWD2CH4_A::B_0X0
    }
    #[doc = "ADC analog channel-x is monitored by AWD2"]
    #[inline(always)]
    pub fn is_b_0x1(&self) -> bool {
        *self == AWD2CH4_A::B_0X1
    }
}
#[doc = "Field `AWD2CH4` writer - Analog watchdog channel selection These bits are set and cleared by software. They enable and select the input channels to be guarded by analog watchdog 2 (AWD2). Note: The channels selected through ADC_AWD2CR must be also configured into the ADC_CHSELR registers. Refer to SQ8\\[3:0\\]
for a definition of channel selection. The software is allowed to write this bit only when ADSTART=0 (which ensures that no conversion is ongoing)."]
pub type AWD2CH4_W<'a, REG> = crate::BitWriter<'a, REG, AWD2CH4_A>;
impl<'a, REG> AWD2CH4_W<'a, REG>
where
    REG: crate::Writable + crate::RegisterSpec,
{
    #[doc = "ADC analog channel-x is not monitored by AWD2"]
    #[inline(always)]
    pub fn b_0x0(self) -> &'a mut crate::W<REG> {
        self.variant(AWD2CH4_A::B_0X0)
    }
    #[doc = "ADC analog channel-x is monitored by AWD2"]
    #[inline(always)]
    pub fn b_0x1(self) -> &'a mut crate::W<REG> {
        self.variant(AWD2CH4_A::B_0X1)
    }
}
#[doc = "Field `AWD2CH5` reader - Analog watchdog channel selection These bits are set and cleared by software. They enable and select the input channels to be guarded by analog watchdog 2 (AWD2). Note: The channels selected through ADC_AWD2CR must be also configured into the ADC_CHSELR registers. Refer to SQ8\\[3:0\\]
for a definition of channel selection. The software is allowed to write this bit only when ADSTART=0 (which ensures that no conversion is ongoing)."]
pub type AWD2CH5_R = crate::BitReader<AWD2CH5_A>;
#[doc = "Analog watchdog channel selection These bits are set and cleared by software. They enable and select the input channels to be guarded by analog watchdog 2 (AWD2). Note: The channels selected through ADC_AWD2CR must be also configured into the ADC_CHSELR registers. Refer to SQ8\\[3:0\\]
for a definition of channel selection. The software is allowed to write this bit only when ADSTART=0 (which ensures that no conversion is ongoing).\n\nValue on reset: 0"]
#[derive(Clone, Copy, Debug, PartialEq, Eq)]
pub enum AWD2CH5_A {
    #[doc = "0: ADC analog channel-x is not monitored by AWD2"]
    B_0X0 = 0,
    #[doc = "1: ADC analog channel-x is monitored by AWD2"]
    B_0X1 = 1,
}
impl From<AWD2CH5_A> for bool {
    #[inline(always)]
    fn from(variant: AWD2CH5_A) -> Self {
        variant as u8 != 0
    }
}
impl AWD2CH5_R {
    #[doc = "Get enumerated values variant"]
    #[inline(always)]
    pub const fn variant(&self) -> AWD2CH5_A {
        match self.bits {
            false => AWD2CH5_A::B_0X0,
            true => AWD2CH5_A::B_0X1,
        }
    }
    #[doc = "ADC analog channel-x is not monitored by AWD2"]
    #[inline(always)]
    pub fn is_b_0x0(&self) -> bool {
        *self == AWD2CH5_A::B_0X0
    }
    #[doc = "ADC analog channel-x is monitored by AWD2"]
    #[inline(always)]
    pub fn is_b_0x1(&self) -> bool {
        *self == AWD2CH5_A::B_0X1
    }
}
#[doc = "Field `AWD2CH5` writer - Analog watchdog channel selection These bits are set and cleared by software. They enable and select the input channels to be guarded by analog watchdog 2 (AWD2). Note: The channels selected through ADC_AWD2CR must be also configured into the ADC_CHSELR registers. Refer to SQ8\\[3:0\\]
for a definition of channel selection. The software is allowed to write this bit only when ADSTART=0 (which ensures that no conversion is ongoing)."]
pub type AWD2CH5_W<'a, REG> = crate::BitWriter<'a, REG, AWD2CH5_A>;
impl<'a, REG> AWD2CH5_W<'a, REG>
where
    REG: crate::Writable + crate::RegisterSpec,
{
    #[doc = "ADC analog channel-x is not monitored by AWD2"]
    #[inline(always)]
    pub fn b_0x0(self) -> &'a mut crate::W<REG> {
        self.variant(AWD2CH5_A::B_0X0)
    }
    #[doc = "ADC analog channel-x is monitored by AWD2"]
    #[inline(always)]
    pub fn b_0x1(self) -> &'a mut crate::W<REG> {
        self.variant(AWD2CH5_A::B_0X1)
    }
}
#[doc = "Field `AWD2CH6` reader - Analog watchdog channel selection These bits are set and cleared by software. They enable and select the input channels to be guarded by analog watchdog 2 (AWD2). Note: The channels selected through ADC_AWD2CR must be also configured into the ADC_CHSELR registers. Refer to SQ8\\[3:0\\]
for a definition of channel selection. The software is allowed to write this bit only when ADSTART=0 (which ensures that no conversion is ongoing)."]
pub type AWD2CH6_R = crate::BitReader<AWD2CH6_A>;
#[doc = "Analog watchdog channel selection These bits are set and cleared by software. They enable and select the input channels to be guarded by analog watchdog 2 (AWD2). Note: The channels selected through ADC_AWD2CR must be also configured into the ADC_CHSELR registers. Refer to SQ8\\[3:0\\]
for a definition of channel selection. The software is allowed to write this bit only when ADSTART=0 (which ensures that no conversion is ongoing).\n\nValue on reset: 0"]
#[derive(Clone, Copy, Debug, PartialEq, Eq)]
pub enum AWD2CH6_A {
    #[doc = "0: ADC analog channel-x is not monitored by AWD2"]
    B_0X0 = 0,
    #[doc = "1: ADC analog channel-x is monitored by AWD2"]
    B_0X1 = 1,
}
impl From<AWD2CH6_A> for bool {
    #[inline(always)]
    fn from(variant: AWD2CH6_A) -> Self {
        variant as u8 != 0
    }
}
impl AWD2CH6_R {
    #[doc = "Get enumerated values variant"]
    #[inline(always)]
    pub const fn variant(&self) -> AWD2CH6_A {
        match self.bits {
            false => AWD2CH6_A::B_0X0,
            true => AWD2CH6_A::B_0X1,
        }
    }
    #[doc = "ADC analog channel-x is not monitored by AWD2"]
    #[inline(always)]
    pub fn is_b_0x0(&self) -> bool {
        *self == AWD2CH6_A::B_0X0
    }
    #[doc = "ADC analog channel-x is monitored by AWD2"]
    #[inline(always)]
    pub fn is_b_0x1(&self) -> bool {
        *self == AWD2CH6_A::B_0X1
    }
}
#[doc = "Field `AWD2CH6` writer - Analog watchdog channel selection These bits are set and cleared by software. They enable and select the input channels to be guarded by analog watchdog 2 (AWD2). Note: The channels selected through ADC_AWD2CR must be also configured into the ADC_CHSELR registers. Refer to SQ8\\[3:0\\]
for a definition of channel selection. The software is allowed to write this bit only when ADSTART=0 (which ensures that no conversion is ongoing)."]
pub type AWD2CH6_W<'a, REG> = crate::BitWriter<'a, REG, AWD2CH6_A>;
impl<'a, REG> AWD2CH6_W<'a, REG>
where
    REG: crate::Writable + crate::RegisterSpec,
{
    #[doc = "ADC analog channel-x is not monitored by AWD2"]
    #[inline(always)]
    pub fn b_0x0(self) -> &'a mut crate::W<REG> {
        self.variant(AWD2CH6_A::B_0X0)
    }
    #[doc = "ADC analog channel-x is monitored by AWD2"]
    #[inline(always)]
    pub fn b_0x1(self) -> &'a mut crate::W<REG> {
        self.variant(AWD2CH6_A::B_0X1)
    }
}
#[doc = "Field `AWD2CH7` reader - Analog watchdog channel selection These bits are set and cleared by software. They enable and select the input channels to be guarded by analog watchdog 2 (AWD2). Note: The channels selected through ADC_AWD2CR must be also configured into the ADC_CHSELR registers. Refer to SQ8\\[3:0\\]
for a definition of channel selection. The software is allowed to write this bit only when ADSTART=0 (which ensures that no conversion is ongoing)."]
pub type AWD2CH7_R = crate::BitReader<AWD2CH7_A>;
#[doc = "Analog watchdog channel selection These bits are set and cleared by software. They enable and select the input channels to be guarded by analog watchdog 2 (AWD2). Note: The channels selected through ADC_AWD2CR must be also configured into the ADC_CHSELR registers. Refer to SQ8\\[3:0\\]
for a definition of channel selection. The software is allowed to write this bit only when ADSTART=0 (which ensures that no conversion is ongoing).\n\nValue on reset: 0"]
#[derive(Clone, Copy, Debug, PartialEq, Eq)]
pub enum AWD2CH7_A {
    #[doc = "0: ADC analog channel-x is not monitored by AWD2"]
    B_0X0 = 0,
    #[doc = "1: ADC analog channel-x is monitored by AWD2"]
    B_0X1 = 1,
}
impl From<AWD2CH7_A> for bool {
    #[inline(always)]
    fn from(variant: AWD2CH7_A) -> Self {
        variant as u8 != 0
    }
}
impl AWD2CH7_R {
    #[doc = "Get enumerated values variant"]
    #[inline(always)]
    pub const fn variant(&self) -> AWD2CH7_A {
        match self.bits {
            false => AWD2CH7_A::B_0X0,
            true => AWD2CH7_A::B_0X1,
        }
    }
    #[doc = "ADC analog channel-x is not monitored by AWD2"]
    #[inline(always)]
    pub fn is_b_0x0(&self) -> bool {
        *self == AWD2CH7_A::B_0X0
    }
    #[doc = "ADC analog channel-x is monitored by AWD2"]
    #[inline(always)]
    pub fn is_b_0x1(&self) -> bool {
        *self == AWD2CH7_A::B_0X1
    }
}
#[doc = "Field `AWD2CH7` writer - Analog watchdog channel selection These bits are set and cleared by software. They enable and select the input channels to be guarded by analog watchdog 2 (AWD2). Note: The channels selected through ADC_AWD2CR must be also configured into the ADC_CHSELR registers. Refer to SQ8\\[3:0\\]
for a definition of channel selection. The software is allowed to write this bit only when ADSTART=0 (which ensures that no conversion is ongoing)."]
pub type AWD2CH7_W<'a, REG> = crate::BitWriter<'a, REG, AWD2CH7_A>;
impl<'a, REG> AWD2CH7_W<'a, REG>
where
    REG: crate::Writable + crate::RegisterSpec,
{
    #[doc = "ADC analog channel-x is not monitored by AWD2"]
    #[inline(always)]
    pub fn b_0x0(self) -> &'a mut crate::W<REG> {
        self.variant(AWD2CH7_A::B_0X0)
    }
    #[doc = "ADC analog channel-x is monitored by AWD2"]
    #[inline(always)]
    pub fn b_0x1(self) -> &'a mut crate::W<REG> {
        self.variant(AWD2CH7_A::B_0X1)
    }
}
#[doc = "Field `AWD2CH8` reader - Analog watchdog channel selection These bits are set and cleared by software. They enable and select the input channels to be guarded by analog watchdog 2 (AWD2). Note: The channels selected through ADC_AWD2CR must be also configured into the ADC_CHSELR registers. Refer to SQ8\\[3:0\\]
for a definition of channel selection. The software is allowed to write this bit only when ADSTART=0 (which ensures that no conversion is ongoing)."]
pub type AWD2CH8_R = crate::BitReader<AWD2CH8_A>;
#[doc = "Analog watchdog channel selection These bits are set and cleared by software. They enable and select the input channels to be guarded by analog watchdog 2 (AWD2). Note: The channels selected through ADC_AWD2CR must be also configured into the ADC_CHSELR registers. Refer to SQ8\\[3:0\\]
for a definition of channel selection. The software is allowed to write this bit only when ADSTART=0 (which ensures that no conversion is ongoing).\n\nValue on reset: 0"]
#[derive(Clone, Copy, Debug, PartialEq, Eq)]
pub enum AWD2CH8_A {
    #[doc = "0: ADC analog channel-x is not monitored by AWD2"]
    B_0X0 = 0,
    #[doc = "1: ADC analog channel-x is monitored by AWD2"]
    B_0X1 = 1,
}
impl From<AWD2CH8_A> for bool {
    #[inline(always)]
    fn from(variant: AWD2CH8_A) -> Self {
        variant as u8 != 0
    }
}
impl AWD2CH8_R {
    #[doc = "Get enumerated values variant"]
    #[inline(always)]
    pub const fn variant(&self) -> AWD2CH8_A {
        match self.bits {
            false => AWD2CH8_A::B_0X0,
            true => AWD2CH8_A::B_0X1,
        }
    }
    #[doc = "ADC analog channel-x is not monitored by AWD2"]
    #[inline(always)]
    pub fn is_b_0x0(&self) -> bool {
        *self == AWD2CH8_A::B_0X0
    }
    #[doc = "ADC analog channel-x is monitored by AWD2"]
    #[inline(always)]
    pub fn is_b_0x1(&self) -> bool {
        *self == AWD2CH8_A::B_0X1
    }
}
#[doc = "Field `AWD2CH8` writer - Analog watchdog channel selection These bits are set and cleared by software. They enable and select the input channels to be guarded by analog watchdog 2 (AWD2). Note: The channels selected through ADC_AWD2CR must be also configured into the ADC_CHSELR registers. Refer to SQ8\\[3:0\\]
for a definition of channel selection. The software is allowed to write this bit only when ADSTART=0 (which ensures that no conversion is ongoing)."]
pub type AWD2CH8_W<'a, REG> = crate::BitWriter<'a, REG, AWD2CH8_A>;
impl<'a, REG> AWD2CH8_W<'a, REG>
where
    REG: crate::Writable + crate::RegisterSpec,
{
    #[doc = "ADC analog channel-x is not monitored by AWD2"]
    #[inline(always)]
    pub fn b_0x0(self) -> &'a mut crate::W<REG> {
        self.variant(AWD2CH8_A::B_0X0)
    }
    #[doc = "ADC analog channel-x is monitored by AWD2"]
    #[inline(always)]
    pub fn b_0x1(self) -> &'a mut crate::W<REG> {
        self.variant(AWD2CH8_A::B_0X1)
    }
}
#[doc = "Field `AWD2CH9` reader - Analog watchdog channel selection These bits are set and cleared by software. They enable and select the input channels to be guarded by analog watchdog 2 (AWD2). Note: The channels selected through ADC_AWD2CR must be also configured into the ADC_CHSELR registers. Refer to SQ8\\[3:0\\]
for a definition of channel selection. The software is allowed to write this bit only when ADSTART=0 (which ensures that no conversion is ongoing)."]
pub type AWD2CH9_R = crate::BitReader<AWD2CH9_A>;
#[doc = "Analog watchdog channel selection These bits are set and cleared by software. They enable and select the input channels to be guarded by analog watchdog 2 (AWD2). Note: The channels selected through ADC_AWD2CR must be also configured into the ADC_CHSELR registers. Refer to SQ8\\[3:0\\]
for a definition of channel selection. The software is allowed to write this bit only when ADSTART=0 (which ensures that no conversion is ongoing).\n\nValue on reset: 0"]
#[derive(Clone, Copy, Debug, PartialEq, Eq)]
pub enum AWD2CH9_A {
    #[doc = "0: ADC analog channel-x is not monitored by AWD2"]
    B_0X0 = 0,
    #[doc = "1: ADC analog channel-x is monitored by AWD2"]
    B_0X1 = 1,
}
impl From<AWD2CH9_A> for bool {
    #[inline(always)]
    fn from(variant: AWD2CH9_A) -> Self {
        variant as u8 != 0
    }
}
impl AWD2CH9_R {
    #[doc = "Get enumerated values variant"]
    #[inline(always)]
    pub const fn variant(&self) -> AWD2CH9_A {
        match self.bits {
            false => AWD2CH9_A::B_0X0,
            true => AWD2CH9_A::B_0X1,
        }
    }
    #[doc = "ADC analog channel-x is not monitored by AWD2"]
    #[inline(always)]
    pub fn is_b_0x0(&self) -> bool {
        *self == AWD2CH9_A::B_0X0
    }
    #[doc = "ADC analog channel-x is monitored by AWD2"]
    #[inline(always)]
    pub fn is_b_0x1(&self) -> bool {
        *self == AWD2CH9_A::B_0X1
    }
}
#[doc = "Field `AWD2CH9` writer - Analog watchdog channel selection These bits are set and cleared by software. They enable and select the input channels to be guarded by analog watchdog 2 (AWD2). Note: The channels selected through ADC_AWD2CR must be also configured into the ADC_CHSELR registers. Refer to SQ8\\[3:0\\]
for a definition of channel selection. The software is allowed to write this bit only when ADSTART=0 (which ensures that no conversion is ongoing)."]
pub type AWD2CH9_W<'a, REG> = crate::BitWriter<'a, REG, AWD2CH9_A>;
impl<'a, REG> AWD2CH9_W<'a, REG>
where
    REG: crate::Writable + crate::RegisterSpec,
{
    #[doc = "ADC analog channel-x is not monitored by AWD2"]
    #[inline(always)]
    pub fn b_0x0(self) -> &'a mut crate::W<REG> {
        self.variant(AWD2CH9_A::B_0X0)
    }
    #[doc = "ADC analog channel-x is monitored by AWD2"]
    #[inline(always)]
    pub fn b_0x1(self) -> &'a mut crate::W<REG> {
        self.variant(AWD2CH9_A::B_0X1)
    }
}
#[doc = "Field `AWD2CH10` reader - Analog watchdog channel selection These bits are set and cleared by software. They enable and select the input channels to be guarded by analog watchdog 2 (AWD2). Note: The channels selected through ADC_AWD2CR must be also configured into the ADC_CHSELR registers. Refer to SQ8\\[3:0\\]
for a definition of channel selection. The software is allowed to write this bit only when ADSTART=0 (which ensures that no conversion is ongoing)."]
pub type AWD2CH10_R = crate::BitReader<AWD2CH10_A>;
#[doc = "Analog watchdog channel selection These bits are set and cleared by software. They enable and select the input channels to be guarded by analog watchdog 2 (AWD2). Note: The channels selected through ADC_AWD2CR must be also configured into the ADC_CHSELR registers. Refer to SQ8\\[3:0\\]
for a definition of channel selection. The software is allowed to write this bit only when ADSTART=0 (which ensures that no conversion is ongoing).\n\nValue on reset: 0"]
#[derive(Clone, Copy, Debug, PartialEq, Eq)]
pub enum AWD2CH10_A {
    #[doc = "0: ADC analog channel-x is not monitored by AWD2"]
    B_0X0 = 0,
    #[doc = "1: ADC analog channel-x is monitored by AWD2"]
    B_0X1 = 1,
}
impl From<AWD2CH10_A> for bool {
    #[inline(always)]
    fn from(variant: AWD2CH10_A) -> Self {
        variant as u8 != 0
    }
}
impl AWD2CH10_R {
    #[doc = "Get enumerated values variant"]
    #[inline(always)]
    pub const fn variant(&self) -> AWD2CH10_A {
        match self.bits {
            false => AWD2CH10_A::B_0X0,
            true => AWD2CH10_A::B_0X1,
        }
    }
    #[doc = "ADC analog channel-x is not monitored by AWD2"]
    #[inline(always)]
    pub fn is_b_0x0(&self) -> bool {
        *self == AWD2CH10_A::B_0X0
    }
    #[doc = "ADC analog channel-x is monitored by AWD2"]
    #[inline(always)]
    pub fn is_b_0x1(&self) -> bool {
        *self == AWD2CH10_A::B_0X1
    }
}
#[doc = "Field `AWD2CH10` writer - Analog watchdog channel selection These bits are set and cleared by software. They enable and select the input channels to be guarded by analog watchdog 2 (AWD2). Note: The channels selected through ADC_AWD2CR must be also configured into the ADC_CHSELR registers. Refer to SQ8\\[3:0\\]
for a definition of channel selection. The software is allowed to write this bit only when ADSTART=0 (which ensures that no conversion is ongoing)."]
pub type AWD2CH10_W<'a, REG> = crate::BitWriter<'a, REG, AWD2CH10_A>;
impl<'a, REG> AWD2CH10_W<'a, REG>
where
    REG: crate::Writable + crate::RegisterSpec,
{
    #[doc = "ADC analog channel-x is not monitored by AWD2"]
    #[inline(always)]
    pub fn b_0x0(self) -> &'a mut crate::W<REG> {
        self.variant(AWD2CH10_A::B_0X0)
    }
    #[doc = "ADC analog channel-x is monitored by AWD2"]
    #[inline(always)]
    pub fn b_0x1(self) -> &'a mut crate::W<REG> {
        self.variant(AWD2CH10_A::B_0X1)
    }
}
#[doc = "Field `AWD2CH11` reader - Analog watchdog channel selection These bits are set and cleared by software. They enable and select the input channels to be guarded by analog watchdog 2 (AWD2). Note: The channels selected through ADC_AWD2CR must be also configured into the ADC_CHSELR registers. Refer to SQ8\\[3:0\\]
for a definition of channel selection. The software is allowed to write this bit only when ADSTART=0 (which ensures that no conversion is ongoing)."]
pub type AWD2CH11_R = crate::BitReader<AWD2CH11_A>;
#[doc = "Analog watchdog channel selection These bits are set and cleared by software. They enable and select the input channels to be guarded by analog watchdog 2 (AWD2). Note: The channels selected through ADC_AWD2CR must be also configured into the ADC_CHSELR registers. Refer to SQ8\\[3:0\\]
for a definition of channel selection. The software is allowed to write this bit only when ADSTART=0 (which ensures that no conversion is ongoing).\n\nValue on reset: 0"]
#[derive(Clone, Copy, Debug, PartialEq, Eq)]
pub enum AWD2CH11_A {
    #[doc = "0: ADC analog channel-x is not monitored by AWD2"]
    B_0X0 = 0,
    #[doc = "1: ADC analog channel-x is monitored by AWD2"]
    B_0X1 = 1,
}
impl From<AWD2CH11_A> for bool {
    #[inline(always)]
    fn from(variant: AWD2CH11_A) -> Self {
        variant as u8 != 0
    }
}
impl AWD2CH11_R {
    #[doc = "Get enumerated values variant"]
    #[inline(always)]
    pub const fn variant(&self) -> AWD2CH11_A {
        match self.bits {
            false => AWD2CH11_A::B_0X0,
            true => AWD2CH11_A::B_0X1,
        }
    }
    #[doc = "ADC analog channel-x is not monitored by AWD2"]
    #[inline(always)]
    pub fn is_b_0x0(&self) -> bool {
        *self == AWD2CH11_A::B_0X0
    }
    #[doc = "ADC analog channel-x is monitored by AWD2"]
    #[inline(always)]
    pub fn is_b_0x1(&self) -> bool {
        *self == AWD2CH11_A::B_0X1
    }
}
#[doc = "Field `AWD2CH11` writer - Analog watchdog channel selection These bits are set and cleared by software. They enable and select the input channels to be guarded by analog watchdog 2 (AWD2). Note: The channels selected through ADC_AWD2CR must be also configured into the ADC_CHSELR registers. Refer to SQ8\\[3:0\\]
for a definition of channel selection. The software is allowed to write this bit only when ADSTART=0 (which ensures that no conversion is ongoing)."]
pub type AWD2CH11_W<'a, REG> = crate::BitWriter<'a, REG, AWD2CH11_A>;
impl<'a, REG> AWD2CH11_W<'a, REG>
where
    REG: crate::Writable + crate::RegisterSpec,
{
    #[doc = "ADC analog channel-x is not monitored by AWD2"]
    #[inline(always)]
    pub fn b_0x0(self) -> &'a mut crate::W<REG> {
        self.variant(AWD2CH11_A::B_0X0)
    }
    #[doc = "ADC analog channel-x is monitored by AWD2"]
    #[inline(always)]
    pub fn b_0x1(self) -> &'a mut crate::W<REG> {
        self.variant(AWD2CH11_A::B_0X1)
    }
}
#[doc = "Field `AWD2CH12` reader - Analog watchdog channel selection These bits are set and cleared by software. They enable and select the input channels to be guarded by analog watchdog 2 (AWD2). Note: The channels selected through ADC_AWD2CR must be also configured into the ADC_CHSELR registers. Refer to SQ8\\[3:0\\]
for a definition of channel selection. The software is allowed to write this bit only when ADSTART=0 (which ensures that no conversion is ongoing)."]
pub type AWD2CH12_R = crate::BitReader<AWD2CH12_A>;
#[doc = "Analog watchdog channel selection These bits are set and cleared by software. They enable and select the input channels to be guarded by analog watchdog 2 (AWD2). Note: The channels selected through ADC_AWD2CR must be also configured into the ADC_CHSELR registers. Refer to SQ8\\[3:0\\]
for a definition of channel selection. The software is allowed to write this bit only when ADSTART=0 (which ensures that no conversion is ongoing).\n\nValue on reset: 0"]
#[derive(Clone, Copy, Debug, PartialEq, Eq)]
pub enum AWD2CH12_A {
    #[doc = "0: ADC analog channel-x is not monitored by AWD2"]
    B_0X0 = 0,
    #[doc = "1: ADC analog channel-x is monitored by AWD2"]
    B_0X1 = 1,
}
impl From<AWD2CH12_A> for bool {
    #[inline(always)]
    fn from(variant: AWD2CH12_A) -> Self {
        variant as u8 != 0
    }
}
impl AWD2CH12_R {
    #[doc = "Get enumerated values variant"]
    #[inline(always)]
    pub const fn variant(&self) -> AWD2CH12_A {
        match self.bits {
            false => AWD2CH12_A::B_0X0,
            true => AWD2CH12_A::B_0X1,
        }
    }
    #[doc = "ADC analog channel-x is not monitored by AWD2"]
    #[inline(always)]
    pub fn is_b_0x0(&self) -> bool {
        *self == AWD2CH12_A::B_0X0
    }
    #[doc = "ADC analog channel-x is monitored by AWD2"]
    #[inline(always)]
    pub fn is_b_0x1(&self) -> bool {
        *self == AWD2CH12_A::B_0X1
    }
}
#[doc = "Field `AWD2CH12` writer - Analog watchdog channel selection These bits are set and cleared by software. They enable and select the input channels to be guarded by analog watchdog 2 (AWD2). Note: The channels selected through ADC_AWD2CR must be also configured into the ADC_CHSELR registers. Refer to SQ8\\[3:0\\]
for a definition of channel selection. The software is allowed to write this bit only when ADSTART=0 (which ensures that no conversion is ongoing)."]
pub type AWD2CH12_W<'a, REG> = crate::BitWriter<'a, REG, AWD2CH12_A>;
impl<'a, REG> AWD2CH12_W<'a, REG>
where
    REG: crate::Writable + crate::RegisterSpec,
{
    #[doc = "ADC analog channel-x is not monitored by AWD2"]
    #[inline(always)]
    pub fn b_0x0(self) -> &'a mut crate::W<REG> {
        self.variant(AWD2CH12_A::B_0X0)
    }
    #[doc = "ADC analog channel-x is monitored by AWD2"]
    #[inline(always)]
    pub fn b_0x1(self) -> &'a mut crate::W<REG> {
        self.variant(AWD2CH12_A::B_0X1)
    }
}
#[doc = "Field `AWD2CH13` reader - Analog watchdog channel selection These bits are set and cleared by software. They enable and select the input channels to be guarded by analog watchdog 2 (AWD2). Note: The channels selected through ADC_AWD2CR must be also configured into the ADC_CHSELR registers. Refer to SQ8\\[3:0\\]
for a definition of channel selection. The software is allowed to write this bit only when ADSTART=0 (which ensures that no conversion is ongoing)."]
pub type AWD2CH13_R = crate::BitReader<AWD2CH13_A>;
#[doc = "Analog watchdog channel selection These bits are set and cleared by software. They enable and select the input channels to be guarded by analog watchdog 2 (AWD2). Note: The channels selected through ADC_AWD2CR must be also configured into the ADC_CHSELR registers. Refer to SQ8\\[3:0\\]
for a definition of channel selection. The software is allowed to write this bit only when ADSTART=0 (which ensures that no conversion is ongoing).\n\nValue on reset: 0"]
#[derive(Clone, Copy, Debug, PartialEq, Eq)]
pub enum AWD2CH13_A {
    #[doc = "0: ADC analog channel-x is not monitored by AWD2"]
    B_0X0 = 0,
    #[doc = "1: ADC analog channel-x is monitored by AWD2"]
    B_0X1 = 1,
}
impl From<AWD2CH13_A> for bool {
    #[inline(always)]
    fn from(variant: AWD2CH13_A) -> Self {
        variant as u8 != 0
    }
}
impl AWD2CH13_R {
    #[doc = "Get enumerated values variant"]
    #[inline(always)]
    pub const fn variant(&self) -> AWD2CH13_A {
        match self.bits {
            false => AWD2CH13_A::B_0X0,
            true => AWD2CH13_A::B_0X1,
        }
    }
    #[doc = "ADC analog channel-x is not monitored by AWD2"]
    #[inline(always)]
    pub fn is_b_0x0(&self) -> bool {
        *self == AWD2CH13_A::B_0X0
    }
    #[doc = "ADC analog channel-x is monitored by AWD2"]
    #[inline(always)]
    pub fn is_b_0x1(&self) -> bool {
        *self == AWD2CH13_A::B_0X1
    }
}
#[doc = "Field `AWD2CH13` writer - Analog watchdog channel selection These bits are set and cleared by software. They enable and select the input channels to be guarded by analog watchdog 2 (AWD2). Note: The channels selected through ADC_AWD2CR must be also configured into the ADC_CHSELR registers. Refer to SQ8\\[3:0\\]
for a definition of channel selection. The software is allowed to write this bit only when ADSTART=0 (which ensures that no conversion is ongoing)."]
pub type AWD2CH13_W<'a, REG> = crate::BitWriter<'a, REG, AWD2CH13_A>;
impl<'a, REG> AWD2CH13_W<'a, REG>
where
    REG: crate::Writable + crate::RegisterSpec,
{
    #[doc = "ADC analog channel-x is not monitored by AWD2"]
    #[inline(always)]
    pub fn b_0x0(self) -> &'a mut crate::W<REG> {
        self.variant(AWD2CH13_A::B_0X0)
    }
    #[doc = "ADC analog channel-x is monitored by AWD2"]
    #[inline(always)]
    pub fn b_0x1(self) -> &'a mut crate::W<REG> {
        self.variant(AWD2CH13_A::B_0X1)
    }
}
#[doc = "Field `AWD2CH14` reader - Analog watchdog channel selection These bits are set and cleared by software. They enable and select the input channels to be guarded by analog watchdog 2 (AWD2). Note: The channels selected through ADC_AWD2CR must be also configured into the ADC_CHSELR registers. Refer to SQ8\\[3:0\\]
for a definition of channel selection. The software is allowed to write this bit only when ADSTART=0 (which ensures that no conversion is ongoing)."]
pub type AWD2CH14_R = crate::BitReader<AWD2CH14_A>;
#[doc = "Analog watchdog channel selection These bits are set and cleared by software. They enable and select the input channels to be guarded by analog watchdog 2 (AWD2). Note: The channels selected through ADC_AWD2CR must be also configured into the ADC_CHSELR registers. Refer to SQ8\\[3:0\\]
for a definition of channel selection. The software is allowed to write this bit only when ADSTART=0 (which ensures that no conversion is ongoing).\n\nValue on reset: 0"]
#[derive(Clone, Copy, Debug, PartialEq, Eq)]
pub enum AWD2CH14_A {
    #[doc = "0: ADC analog channel-x is not monitored by AWD2"]
    B_0X0 = 0,
    #[doc = "1: ADC analog channel-x is monitored by AWD2"]
    B_0X1 = 1,
}
impl From<AWD2CH14_A> for bool {
    #[inline(always)]
    fn from(variant: AWD2CH14_A) -> Self {
        variant as u8 != 0
    }
}
impl AWD2CH14_R {
    #[doc = "Get enumerated values variant"]
    #[inline(always)]
    pub const fn variant(&self) -> AWD2CH14_A {
        match self.bits {
            false => AWD2CH14_A::B_0X0,
            true => AWD2CH14_A::B_0X1,
        }
    }
    #[doc = "ADC analog channel-x is not monitored by AWD2"]
    #[inline(always)]
    pub fn is_b_0x0(&self) -> bool {
        *self == AWD2CH14_A::B_0X0
    }
    #[doc = "ADC analog channel-x is monitored by AWD2"]
    #[inline(always)]
    pub fn is_b_0x1(&self) -> bool {
        *self == AWD2CH14_A::B_0X1
    }
}
#[doc = "Field `AWD2CH14` writer - Analog watchdog channel selection These bits are set and cleared by software. They enable and select the input channels to be guarded by analog watchdog 2 (AWD2). Note: The channels selected through ADC_AWD2CR must be also configured into the ADC_CHSELR registers. Refer to SQ8\\[3:0\\]
for a definition of channel selection. The software is allowed to write this bit only when ADSTART=0 (which ensures that no conversion is ongoing)."]
pub type AWD2CH14_W<'a, REG> = crate::BitWriter<'a, REG, AWD2CH14_A>;
impl<'a, REG> AWD2CH14_W<'a, REG>
where
    REG: crate::Writable + crate::RegisterSpec,
{
    #[doc = "ADC analog channel-x is not monitored by AWD2"]
    #[inline(always)]
    pub fn b_0x0(self) -> &'a mut crate::W<REG> {
        self.variant(AWD2CH14_A::B_0X0)
    }
    #[doc = "ADC analog channel-x is monitored by AWD2"]
    #[inline(always)]
    pub fn b_0x1(self) -> &'a mut crate::W<REG> {
        self.variant(AWD2CH14_A::B_0X1)
    }
}
#[doc = "Field `AWD2CH15` reader - Analog watchdog channel selection These bits are set and cleared by software. They enable and select the input channels to be guarded by analog watchdog 2 (AWD2). Note: The channels selected through ADC_AWD2CR must be also configured into the ADC_CHSELR registers. Refer to SQ8\\[3:0\\]
for a definition of channel selection. The software is allowed to write this bit only when ADSTART=0 (which ensures that no conversion is ongoing)."]
pub type AWD2CH15_R = crate::BitReader<AWD2CH15_A>;
#[doc = "Analog watchdog channel selection These bits are set and cleared by software. They enable and select the input channels to be guarded by analog watchdog 2 (AWD2). Note: The channels selected through ADC_AWD2CR must be also configured into the ADC_CHSELR registers. Refer to SQ8\\[3:0\\]
for a definition of channel selection. The software is allowed to write this bit only when ADSTART=0 (which ensures that no conversion is ongoing).\n\nValue on reset: 0"]
#[derive(Clone, Copy, Debug, PartialEq, Eq)]
pub enum AWD2CH15_A {
    #[doc = "0: ADC analog channel-x is not monitored by AWD2"]
    B_0X0 = 0,
    #[doc = "1: ADC analog channel-x is monitored by AWD2"]
    B_0X1 = 1,
}
impl From<AWD2CH15_A> for bool {
    #[inline(always)]
    fn from(variant: AWD2CH15_A) -> Self {
        variant as u8 != 0
    }
}
impl AWD2CH15_R {
    #[doc = "Get enumerated values variant"]
    #[inline(always)]
    pub const fn variant(&self) -> AWD2CH15_A {
        match self.bits {
            false => AWD2CH15_A::B_0X0,
            true => AWD2CH15_A::B_0X1,
        }
    }
    #[doc = "ADC analog channel-x is not monitored by AWD2"]
    #[inline(always)]
    pub fn is_b_0x0(&self) -> bool {
        *self == AWD2CH15_A::B_0X0
    }
    #[doc = "ADC analog channel-x is monitored by AWD2"]
    #[inline(always)]
    pub fn is_b_0x1(&self) -> bool {
        *self == AWD2CH15_A::B_0X1
    }
}
#[doc = "Field `AWD2CH15` writer - Analog watchdog channel selection These bits are set and cleared by software. They enable and select the input channels to be guarded by analog watchdog 2 (AWD2). Note: The channels selected through ADC_AWD2CR must be also configured into the ADC_CHSELR registers. Refer to SQ8\\[3:0\\]
for a definition of channel selection. The software is allowed to write this bit only when ADSTART=0 (which ensures that no conversion is ongoing)."]
pub type AWD2CH15_W<'a, REG> = crate::BitWriter<'a, REG, AWD2CH15_A>;
impl<'a, REG> AWD2CH15_W<'a, REG>
where
    REG: crate::Writable + crate::RegisterSpec,
{
    #[doc = "ADC analog channel-x is not monitored by AWD2"]
    #[inline(always)]
    pub fn b_0x0(self) -> &'a mut crate::W<REG> {
        self.variant(AWD2CH15_A::B_0X0)
    }
    #[doc = "ADC analog channel-x is monitored by AWD2"]
    #[inline(always)]
    pub fn b_0x1(self) -> &'a mut crate::W<REG> {
        self.variant(AWD2CH15_A::B_0X1)
    }
}
#[doc = "Field `AWD2CH16` reader - Analog watchdog channel selection These bits are set and cleared by software. They enable and select the input channels to be guarded by analog watchdog 2 (AWD2). Note: The channels selected through ADC_AWD2CR must be also configured into the ADC_CHSELR registers. Refer to SQ8\\[3:0\\]
for a definition of channel selection. The software is allowed to write this bit only when ADSTART=0 (which ensures that no conversion is ongoing)."]
pub type AWD2CH16_R = crate::BitReader<AWD2CH16_A>;
#[doc = "Analog watchdog channel selection These bits are set and cleared by software. They enable and select the input channels to be guarded by analog watchdog 2 (AWD2). Note: The channels selected through ADC_AWD2CR must be also configured into the ADC_CHSELR registers. Refer to SQ8\\[3:0\\]
for a definition of channel selection. The software is allowed to write this bit only when ADSTART=0 (which ensures that no conversion is ongoing).\n\nValue on reset: 0"]
#[derive(Clone, Copy, Debug, PartialEq, Eq)]
pub enum AWD2CH16_A {
    #[doc = "0: ADC analog channel-x is not monitored by AWD2"]
    B_0X0 = 0,
    #[doc = "1: ADC analog channel-x is monitored by AWD2"]
    B_0X1 = 1,
}
impl From<AWD2CH16_A> for bool {
    #[inline(always)]
    fn from(variant: AWD2CH16_A) -> Self {
        variant as u8 != 0
    }
}
impl AWD2CH16_R {
    #[doc = "Get enumerated values variant"]
    #[inline(always)]
    pub const fn variant(&self) -> AWD2CH16_A {
        match self.bits {
            false => AWD2CH16_A::B_0X0,
            true => AWD2CH16_A::B_0X1,
        }
    }
    #[doc = "ADC analog channel-x is not monitored by AWD2"]
    #[inline(always)]
    pub fn is_b_0x0(&self) -> bool {
        *self == AWD2CH16_A::B_0X0
    }
    #[doc = "ADC analog channel-x is monitored by AWD2"]
    #[inline(always)]
    pub fn is_b_0x1(&self) -> bool {
        *self == AWD2CH16_A::B_0X1
    }
}
#[doc = "Field `AWD2CH16` writer - Analog watchdog channel selection These bits are set and cleared by software. They enable and select the input channels to be guarded by analog watchdog 2 (AWD2). Note: The channels selected through ADC_AWD2CR must be also configured into the ADC_CHSELR registers. Refer to SQ8\\[3:0\\]
for a definition of channel selection. The software is allowed to write this bit only when ADSTART=0 (which ensures that no conversion is ongoing)."]
pub type AWD2CH16_W<'a, REG> = crate::BitWriter<'a, REG, AWD2CH16_A>;
impl<'a, REG> AWD2CH16_W<'a, REG>
where
    REG: crate::Writable + crate::RegisterSpec,
{
    #[doc = "ADC analog channel-x is not monitored by AWD2"]
    #[inline(always)]
    pub fn b_0x0(self) -> &'a mut crate::W<REG> {
        self.variant(AWD2CH16_A::B_0X0)
    }
    #[doc = "ADC analog channel-x is monitored by AWD2"]
    #[inline(always)]
    pub fn b_0x1(self) -> &'a mut crate::W<REG> {
        self.variant(AWD2CH16_A::B_0X1)
    }
}
#[doc = "Field `AWD2CH17` reader - Analog watchdog channel selection These bits are set and cleared by software. They enable and select the input channels to be guarded by analog watchdog 2 (AWD2). Note: The channels selected through ADC_AWD2CR must be also configured into the ADC_CHSELR registers. Refer to SQ8\\[3:0\\]
for a definition of channel selection. The software is allowed to write this bit only when ADSTART=0 (which ensures that no conversion is ongoing)."]
pub type AWD2CH17_R = crate::BitReader<AWD2CH17_A>;
#[doc = "Analog watchdog channel selection These bits are set and cleared by software. They enable and select the input channels to be guarded by analog watchdog 2 (AWD2). Note: The channels selected through ADC_AWD2CR must be also configured into the ADC_CHSELR registers. Refer to SQ8\\[3:0\\]
for a definition of channel selection. The software is allowed to write this bit only when ADSTART=0 (which ensures that no conversion is ongoing).\n\nValue on reset: 0"]
#[derive(Clone, Copy, Debug, PartialEq, Eq)]
pub enum AWD2CH17_A {
    #[doc = "0: ADC analog channel-x is not monitored by AWD2"]
    B_0X0 = 0,
    #[doc = "1: ADC analog channel-x is monitored by AWD2"]
    B_0X1 = 1,
}
impl From<AWD2CH17_A> for bool {
    #[inline(always)]
    fn from(variant: AWD2CH17_A) -> Self {
        variant as u8 != 0
    }
}
impl AWD2CH17_R {
    #[doc = "Get enumerated values variant"]
    #[inline(always)]
    pub const fn variant(&self) -> AWD2CH17_A {
        match self.bits {
            false => AWD2CH17_A::B_0X0,
            true => AWD2CH17_A::B_0X1,
        }
    }
    #[doc = "ADC analog channel-x is not monitored by AWD2"]
    #[inline(always)]
    pub fn is_b_0x0(&self) -> bool {
        *self == AWD2CH17_A::B_0X0
    }
    #[doc = "ADC analog channel-x is monitored by AWD2"]
    #[inline(always)]
    pub fn is_b_0x1(&self) -> bool {
        *self == AWD2CH17_A::B_0X1
    }
}
#[doc = "Field `AWD2CH17` writer - Analog watchdog channel selection These bits are set and cleared by software. They enable and select the input channels to be guarded by analog watchdog 2 (AWD2). Note: The channels selected through ADC_AWD2CR must be also configured into the ADC_CHSELR registers. Refer to SQ8\\[3:0\\]
for a definition of channel selection. The software is allowed to write this bit only when ADSTART=0 (which ensures that no conversion is ongoing)."]
pub type AWD2CH17_W<'a, REG> = crate::BitWriter<'a, REG, AWD2CH17_A>;
impl<'a, REG> AWD2CH17_W<'a, REG>
where
    REG: crate::Writable + crate::RegisterSpec,
{
    #[doc = "ADC analog channel-x is not monitored by AWD2"]
    #[inline(always)]
    pub fn b_0x0(self) -> &'a mut crate::W<REG> {
        self.variant(AWD2CH17_A::B_0X0)
    }
    #[doc = "ADC analog channel-x is monitored by AWD2"]
    #[inline(always)]
    pub fn b_0x1(self) -> &'a mut crate::W<REG> {
        self.variant(AWD2CH17_A::B_0X1)
    }
}
#[doc = "Field `AWD2CH18` reader - Analog watchdog channel selection These bits are set and cleared by software. They enable and select the input channels to be guarded by analog watchdog 2 (AWD2). Note: The channels selected through ADC_AWD2CR must be also configured into the ADC_CHSELR registers. Refer to SQ8\\[3:0\\]
for a definition of channel selection. The software is allowed to write this bit only when ADSTART=0 (which ensures that no conversion is ongoing)."]
pub type AWD2CH18_R = crate::BitReader<AWD2CH18_A>;
#[doc = "Analog watchdog channel selection These bits are set and cleared by software. They enable and select the input channels to be guarded by analog watchdog 2 (AWD2). Note: The channels selected through ADC_AWD2CR must be also configured into the ADC_CHSELR registers. Refer to SQ8\\[3:0\\]
for a definition of channel selection. The software is allowed to write this bit only when ADSTART=0 (which ensures that no conversion is ongoing).\n\nValue on reset: 0"]
#[derive(Clone, Copy, Debug, PartialEq, Eq)]
pub enum AWD2CH18_A {
    #[doc = "0: ADC analog channel-x is not monitored by AWD2"]
    B_0X0 = 0,
    #[doc = "1: ADC analog channel-x is monitored by AWD2"]
    B_0X1 = 1,
}
impl From<AWD2CH18_A> for bool {
    #[inline(always)]
    fn from(variant: AWD2CH18_A) -> Self {
        variant as u8 != 0
    }
}
impl AWD2CH18_R {
    #[doc = "Get enumerated values variant"]
    #[inline(always)]
    pub const fn variant(&self) -> AWD2CH18_A {
        match self.bits {
            false => AWD2CH18_A::B_0X0,
            true => AWD2CH18_A::B_0X1,
        }
    }
    #[doc = "ADC analog channel-x is not monitored by AWD2"]
    #[inline(always)]
    pub fn is_b_0x0(&self) -> bool {
        *self == AWD2CH18_A::B_0X0
    }
    #[doc = "ADC analog channel-x is monitored by AWD2"]
    #[inline(always)]
    pub fn is_b_0x1(&self) -> bool {
        *self == AWD2CH18_A::B_0X1
    }
}
#[doc = "Field `AWD2CH18` writer - Analog watchdog channel selection These bits are set and cleared by software. They enable and select the input channels to be guarded by analog watchdog 2 (AWD2). Note: The channels selected through ADC_AWD2CR must be also configured into the ADC_CHSELR registers. Refer to SQ8\\[3:0\\]
for a definition of channel selection. The software is allowed to write this bit only when ADSTART=0 (which ensures that no conversion is ongoing)."]
pub type AWD2CH18_W<'a, REG> = crate::BitWriter<'a, REG, AWD2CH18_A>;
impl<'a, REG> AWD2CH18_W<'a, REG>
where
    REG: crate::Writable + crate::RegisterSpec,
{
    #[doc = "ADC analog channel-x is not monitored by AWD2"]
    #[inline(always)]
    pub fn b_0x0(self) -> &'a mut crate::W<REG> {
        self.variant(AWD2CH18_A::B_0X0)
    }
    #[doc = "ADC analog channel-x is monitored by AWD2"]
    #[inline(always)]
    pub fn b_0x1(self) -> &'a mut crate::W<REG> {
        self.variant(AWD2CH18_A::B_0X1)
    }
}
impl R {
    #[doc = "Bit 0 - Analog watchdog channel selection These bits are set and cleared by software. They enable and select the input channels to be guarded by analog watchdog 2 (AWD2). Note: The channels selected through ADC_AWD2CR must be also configured into the ADC_CHSELR registers. Refer to SQ8\\[3:0\\]
for a definition of channel selection. The software is allowed to write this bit only when ADSTART=0 (which ensures that no conversion is ongoing)."]
    #[inline(always)]
    pub fn awd2ch0(&self) -> AWD2CH0_R {
        AWD2CH0_R::new((self.bits & 1) != 0)
    }
    #[doc = "Bit 1 - Analog watchdog channel selection These bits are set and cleared by software. They enable and select the input channels to be guarded by analog watchdog 2 (AWD2). Note: The channels selected through ADC_AWD2CR must be also configured into the ADC_CHSELR registers. Refer to SQ8\\[3:0\\]
for a definition of channel selection. The software is allowed to write this bit only when ADSTART=0 (which ensures that no conversion is ongoing)."]
    #[inline(always)]
    pub fn awd2ch1(&self) -> AWD2CH1_R {
        AWD2CH1_R::new(((self.bits >> 1) & 1) != 0)
    }
    #[doc = "Bit 2 - Analog watchdog channel selection These bits are set and cleared by software. They enable and select the input channels to be guarded by analog watchdog 2 (AWD2). Note: The channels selected through ADC_AWD2CR must be also configured into the ADC_CHSELR registers. Refer to SQ8\\[3:0\\]
for a definition of channel selection. The software is allowed to write this bit only when ADSTART=0 (which ensures that no conversion is ongoing)."]
    #[inline(always)]
    pub fn awd2ch2(&self) -> AWD2CH2_R {
        AWD2CH2_R::new(((self.bits >> 2) & 1) != 0)
    }
    #[doc = "Bit 3 - Analog watchdog channel selection These bits are set and cleared by software. They enable and select the input channels to be guarded by analog watchdog 2 (AWD2). Note: The channels selected through ADC_AWD2CR must be also configured into the ADC_CHSELR registers. Refer to SQ8\\[3:0\\]
for a definition of channel selection. The software is allowed to write this bit only when ADSTART=0 (which ensures that no conversion is ongoing)."]
    #[inline(always)]
    pub fn awd2ch3(&self) -> AWD2CH3_R {
        AWD2CH3_R::new(((self.bits >> 3) & 1) != 0)
    }
    #[doc = "Bit 4 - Analog watchdog channel selection These bits are set and cleared by software. They enable and select the input channels to be guarded by analog watchdog 2 (AWD2). Note: The channels selected through ADC_AWD2CR must be also configured into the ADC_CHSELR registers. Refer to SQ8\\[3:0\\]
for a definition of channel selection. The software is allowed to write this bit only when ADSTART=0 (which ensures that no conversion is ongoing)."]
    #[inline(always)]
    pub fn awd2ch4(&self) -> AWD2CH4_R {
        AWD2CH4_R::new(((self.bits >> 4) & 1) != 0)
    }
    #[doc = "Bit 5 - Analog watchdog channel selection These bits are set and cleared by software. They enable and select the input channels to be guarded by analog watchdog 2 (AWD2). Note: The channels selected through ADC_AWD2CR must be also configured into the ADC_CHSELR registers. Refer to SQ8\\[3:0\\]
for a definition of channel selection. The software is allowed to write this bit only when ADSTART=0 (which ensures that no conversion is ongoing)."]
    #[inline(always)]
    pub fn awd2ch5(&self) -> AWD2CH5_R {
        AWD2CH5_R::new(((self.bits >> 5) & 1) != 0)
    }
    #[doc = "Bit 6 - Analog watchdog channel selection These bits are set and cleared by software. They enable and select the input channels to be guarded by analog watchdog 2 (AWD2). Note: The channels selected through ADC_AWD2CR must be also configured into the ADC_CHSELR registers. Refer to SQ8\\[3:0\\]
for a definition of channel selection. The software is allowed to write this bit only when ADSTART=0 (which ensures that no conversion is ongoing)."]
    #[inline(always)]
    pub fn awd2ch6(&self) -> AWD2CH6_R {
        AWD2CH6_R::new(((self.bits >> 6) & 1) != 0)
    }
    #[doc = "Bit 7 - Analog watchdog channel selection These bits are set and cleared by software. They enable and select the input channels to be guarded by analog watchdog 2 (AWD2). Note: The channels selected through ADC_AWD2CR must be also configured into the ADC_CHSELR registers. Refer to SQ8\\[3:0\\]
for a definition of channel selection. The software is allowed to write this bit only when ADSTART=0 (which ensures that no conversion is ongoing)."]
    #[inline(always)]
    pub fn awd2ch7(&self) -> AWD2CH7_R {
        AWD2CH7_R::new(((self.bits >> 7) & 1) != 0)
    }
    #[doc = "Bit 8 - Analog watchdog channel selection These bits are set and cleared by software. They enable and select the input channels to be guarded by analog watchdog 2 (AWD2). Note: The channels selected through ADC_AWD2CR must be also configured into the ADC_CHSELR registers. Refer to SQ8\\[3:0\\]
for a definition of channel selection. The software is allowed to write this bit only when ADSTART=0 (which ensures that no conversion is ongoing)."]
    #[inline(always)]
    pub fn awd2ch8(&self) -> AWD2CH8_R {
        AWD2CH8_R::new(((self.bits >> 8) & 1) != 0)
    }
    #[doc = "Bit 9 - Analog watchdog channel selection These bits are set and cleared by software. They enable and select the input channels to be guarded by analog watchdog 2 (AWD2). Note: The channels selected through ADC_AWD2CR must be also configured into the ADC_CHSELR registers. Refer to SQ8\\[3:0\\]
for a definition of channel selection. The software is allowed to write this bit only when ADSTART=0 (which ensures that no conversion is ongoing)."]
    #[inline(always)]
    pub fn awd2ch9(&self) -> AWD2CH9_R {
        AWD2CH9_R::new(((self.bits >> 9) & 1) != 0)
    }
    #[doc = "Bit 10 - Analog watchdog channel selection These bits are set and cleared by software. They enable and select the input channels to be guarded by analog watchdog 2 (AWD2). Note: The channels selected through ADC_AWD2CR must be also configured into the ADC_CHSELR registers. Refer to SQ8\\[3:0\\]
for a definition of channel selection. The software is allowed to write this bit only when ADSTART=0 (which ensures that no conversion is ongoing)."]
    #[inline(always)]
    pub fn awd2ch10(&self) -> AWD2CH10_R {
        AWD2CH10_R::new(((self.bits >> 10) & 1) != 0)
    }
    #[doc = "Bit 11 - Analog watchdog channel selection These bits are set and cleared by software. They enable and select the input channels to be guarded by analog watchdog 2 (AWD2). Note: The channels selected through ADC_AWD2CR must be also configured into the ADC_CHSELR registers. Refer to SQ8\\[3:0\\]
for a definition of channel selection. The software is allowed to write this bit only when ADSTART=0 (which ensures that no conversion is ongoing)."]
    #[inline(always)]
    pub fn awd2ch11(&self) -> AWD2CH11_R {
        AWD2CH11_R::new(((self.bits >> 11) & 1) != 0)
    }
    #[doc = "Bit 12 - Analog watchdog channel selection These bits are set and cleared by software. They enable and select the input channels to be guarded by analog watchdog 2 (AWD2). Note: The channels selected through ADC_AWD2CR must be also configured into the ADC_CHSELR registers. Refer to SQ8\\[3:0\\]
for a definition of channel selection. The software is allowed to write this bit only when ADSTART=0 (which ensures that no conversion is ongoing)."]
    #[inline(always)]
    pub fn awd2ch12(&self) -> AWD2CH12_R {
        AWD2CH12_R::new(((self.bits >> 12) & 1) != 0)
    }
    #[doc = "Bit 13 - Analog watchdog channel selection These bits are set and cleared by software. They enable and select the input channels to be guarded by analog watchdog 2 (AWD2). Note: The channels selected through ADC_AWD2CR must be also configured into the ADC_CHSELR registers. Refer to SQ8\\[3:0\\]
for a definition of channel selection. The software is allowed to write this bit only when ADSTART=0 (which ensures that no conversion is ongoing)."]
    #[inline(always)]
    pub fn awd2ch13(&self) -> AWD2CH13_R {
        AWD2CH13_R::new(((self.bits >> 13) & 1) != 0)
    }
    #[doc = "Bit 14 - Analog watchdog channel selection These bits are set and cleared by software. They enable and select the input channels to be guarded by analog watchdog 2 (AWD2). Note: The channels selected through ADC_AWD2CR must be also configured into the ADC_CHSELR registers. Refer to SQ8\\[3:0\\]
for a definition of channel selection. The software is allowed to write this bit only when ADSTART=0 (which ensures that no conversion is ongoing)."]
    #[inline(always)]
    pub fn awd2ch14(&self) -> AWD2CH14_R {
        AWD2CH14_R::new(((self.bits >> 14) & 1) != 0)
    }
    #[doc = "Bit 15 - Analog watchdog channel selection These bits are set and cleared by software. They enable and select the input channels to be guarded by analog watchdog 2 (AWD2). Note: The channels selected through ADC_AWD2CR must be also configured into the ADC_CHSELR registers. Refer to SQ8\\[3:0\\]
for a definition of channel selection. The software is allowed to write this bit only when ADSTART=0 (which ensures that no conversion is ongoing)."]
    #[inline(always)]
    pub fn awd2ch15(&self) -> AWD2CH15_R {
        AWD2CH15_R::new(((self.bits >> 15) & 1) != 0)
    }
    #[doc = "Bit 16 - Analog watchdog channel selection These bits are set and cleared by software. They enable and select the input channels to be guarded by analog watchdog 2 (AWD2). Note: The channels selected through ADC_AWD2CR must be also configured into the ADC_CHSELR registers. Refer to SQ8\\[3:0\\]
for a definition of channel selection. The software is allowed to write this bit only when ADSTART=0 (which ensures that no conversion is ongoing)."]
    #[inline(always)]
    pub fn awd2ch16(&self) -> AWD2CH16_R {
        AWD2CH16_R::new(((self.bits >> 16) & 1) != 0)
    }
    #[doc = "Bit 17 - Analog watchdog channel selection These bits are set and cleared by software. They enable and select the input channels to be guarded by analog watchdog 2 (AWD2). Note: The channels selected through ADC_AWD2CR must be also configured into the ADC_CHSELR registers. Refer to SQ8\\[3:0\\]
for a definition of channel selection. The software is allowed to write this bit only when ADSTART=0 (which ensures that no conversion is ongoing)."]
    #[inline(always)]
    pub fn awd2ch17(&self) -> AWD2CH17_R {
        AWD2CH17_R::new(((self.bits >> 17) & 1) != 0)
    }
    #[doc = "Bit 18 - Analog watchdog channel selection These bits are set and cleared by software. They enable and select the input channels to be guarded by analog watchdog 2 (AWD2). Note: The channels selected through ADC_AWD2CR must be also configured into the ADC_CHSELR registers. Refer to SQ8\\[3:0\\]
for a definition of channel selection. The software is allowed to write this bit only when ADSTART=0 (which ensures that no conversion is ongoing)."]
    #[inline(always)]
    pub fn awd2ch18(&self) -> AWD2CH18_R {
        AWD2CH18_R::new(((self.bits >> 18) & 1) != 0)
    }
}
impl W {
    #[doc = "Bit 0 - Analog watchdog channel selection These bits are set and cleared by software. They enable and select the input channels to be guarded by analog watchdog 2 (AWD2). Note: The channels selected through ADC_AWD2CR must be also configured into the ADC_CHSELR registers. Refer to SQ8\\[3:0\\]
for a definition of channel selection. The software is allowed to write this bit only when ADSTART=0 (which ensures that no conversion is ongoing)."]
    #[inline(always)]
    #[must_use]
    pub fn awd2ch0(&mut self) -> AWD2CH0_W<ADC_AWD2CR_SPEC> {
        AWD2CH0_W::new(self, 0)
    }
    #[doc = "Bit 1 - Analog watchdog channel selection These bits are set and cleared by software. They enable and select the input channels to be guarded by analog watchdog 2 (AWD2). Note: The channels selected through ADC_AWD2CR must be also configured into the ADC_CHSELR registers. Refer to SQ8\\[3:0\\]
for a definition of channel selection. The software is allowed to write this bit only when ADSTART=0 (which ensures that no conversion is ongoing)."]
    #[inline(always)]
    #[must_use]
    pub fn awd2ch1(&mut self) -> AWD2CH1_W<ADC_AWD2CR_SPEC> {
        AWD2CH1_W::new(self, 1)
    }
    #[doc = "Bit 2 - Analog watchdog channel selection These bits are set and cleared by software. They enable and select the input channels to be guarded by analog watchdog 2 (AWD2). Note: The channels selected through ADC_AWD2CR must be also configured into the ADC_CHSELR registers. Refer to SQ8\\[3:0\\]
for a definition of channel selection. The software is allowed to write this bit only when ADSTART=0 (which ensures that no conversion is ongoing)."]
    #[inline(always)]
    #[must_use]
    pub fn awd2ch2(&mut self) -> AWD2CH2_W<ADC_AWD2CR_SPEC> {
        AWD2CH2_W::new(self, 2)
    }
    #[doc = "Bit 3 - Analog watchdog channel selection These bits are set and cleared by software. They enable and select the input channels to be guarded by analog watchdog 2 (AWD2). Note: The channels selected through ADC_AWD2CR must be also configured into the ADC_CHSELR registers. Refer to SQ8\\[3:0\\]
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
for a definition of channel selection. The software is allowed to write this bit only when ADSTART=0 (which ensures that no conversion is ongoing)."]
    #[inline(always)]
    #[must_use]
    pub fn awd2ch15(&mut self) -> AWD2CH15_W<ADC_AWD2CR_SPEC> {
        AWD2CH15_W::new(self, 15)
    }
    #[doc = "Bit 16 - Analog watchdog channel selection These bits are set and cleared by software. They enable and select the input channels to be guarded by analog watchdog 2 (AWD2). Note: The channels selected through ADC_AWD2CR must be also configured into the ADC_CHSELR registers. Refer to SQ8\\[3:0\\]
for a definition of channel selection. The software is allowed to write this bit only when ADSTART=0 (which ensures that no conversion is ongoing)."]
    #[inline(always)]
    #[must_use]
    pub fn awd2ch16(&mut self) -> AWD2CH16_W<ADC_AWD2CR_SPEC> {
        AWD2CH16_W::new(self, 16)
    }
    #[doc = "Bit 17 - Analog watchdog channel selection These bits are set and cleared by software. They enable and select the input channels to be guarded by analog watchdog 2 (AWD2). Note: The channels selected through ADC_AWD2CR must be also configured into the ADC_CHSELR registers. Refer to SQ8\\[3:0\\]
for a definition of channel selection. The software is allowed to write this bit only when ADSTART=0 (which ensures that no conversion is ongoing)."]
    #[inline(always)]
    #[must_use]
    pub fn awd2ch17(&mut self) -> AWD2CH17_W<ADC_AWD2CR_SPEC> {
        AWD2CH17_W::new(self, 17)
    }
    #[doc = "Bit 18 - Analog watchdog channel selection These bits are set and cleared by software. They enable and select the input channels to be guarded by analog watchdog 2 (AWD2). Note: The channels selected through ADC_AWD2CR must be also configured into the ADC_CHSELR registers. Refer to SQ8\\[3:0\\]
for a definition of channel selection. The software is allowed to write this bit only when ADSTART=0 (which ensures that no conversion is ongoing)."]
    #[inline(always)]
    #[must_use]
    pub fn awd2ch18(&mut self) -> AWD2CH18_W<ADC_AWD2CR_SPEC> {
        AWD2CH18_W::new(self, 18)
    }
    #[doc = r" Writes raw bits to the register."]
    #[doc = r""]
    #[doc = r" # Safety"]
    #[doc = r""]
    #[doc = r" Passing incorrect value can cause undefined behaviour. See reference manual"]
    #[inline(always)]
    pub unsafe fn bits(&mut self, bits: u32) -> &mut Self {
        self.bits = bits;
        self
    }
}
#[doc = "ADC Analog Watchdog 2 Configuration register\n\nYou can [`read`](crate::generic::Reg::read) this register and get [`adc_awd2cr::R`](R).  You can [`reset`](crate::generic::Reg::reset), [`write`](crate::generic::Reg::write), [`write_with_zero`](crate::generic::Reg::write_with_zero) this register using [`adc_awd2cr::W`](W). You can also [`modify`](crate::generic::Reg::modify) this register. See [API](https://docs.rs/svd2rust/#read--modify--write-api)."]
pub struct ADC_AWD2CR_SPEC;
impl crate::RegisterSpec for ADC_AWD2CR_SPEC {
    type Ux = u32;
}
#[doc = "`read()` method returns [`adc_awd2cr::R`](R) reader structure"]
impl crate::Readable for ADC_AWD2CR_SPEC {}
#[doc = "`write(|w| ..)` method takes [`adc_awd2cr::W`](W) writer structure"]
impl crate::Writable for ADC_AWD2CR_SPEC {
    const ZERO_TO_MODIFY_FIELDS_BITMAP: u32 = 0;
    const ONE_TO_MODIFY_FIELDS_BITMAP: u32 = 0;
}
#[doc = "`reset()` method sets ADC_AWD2CR to value 0"]
impl crate::Resettable for ADC_AWD2CR_SPEC {
    const RESET_VALUE: u32 = 0;
}
