RavuAlHemio/eprom5vread/code/on_board/stm32g0b0/src/adc/adc_awd3cr.rs

#[doc = "Register `ADC_AWD3CR` reader"]
pub type R = crate::R<ADC_AWD3CR_SPEC>;
#[doc = "Register `ADC_AWD3CR` writer"]
pub type W = crate::W<ADC_AWD3CR_SPEC>;
#[doc = "Field `AWD3CH0` reader - Analog watchdog channel selection These bits are set and cleared by software. They enable and select the input channels to be guarded by analog watchdog 3 (AWD3). Note: The channels selected through ADC_AWD3CR must be also configured into the ADC_CHSELR registers. Refer to SQ8\\[3:0\\]
for a definition of channel selection. The software is allowed to write this bit only when ADSTART=0 (which ensures that no conversion is ongoing)."]
pub type AWD3CH0_R = crate::BitReader<AWD3CH0_A>;
#[doc = "Analog watchdog channel selection These bits are set and cleared by software. They enable and select the input channels to be guarded by analog watchdog 3 (AWD3). Note: The channels selected through ADC_AWD3CR must be also configured into the ADC_CHSELR registers. Refer to SQ8\\[3:0\\]
for a definition of channel selection. The software is allowed to write this bit only when ADSTART=0 (which ensures that no conversion is ongoing).\n\nValue on reset: 0"]
#[derive(Clone, Copy, Debug, PartialEq, Eq)]
pub enum AWD3CH0_A {
    #[doc = "0: ADC analog channel-x is not monitored by AWD3"]
    B_0X0 = 0,
    #[doc = "1: ADC analog channel-x is monitored by AWD3"]
    B_0X1 = 1,
}
impl From<AWD3CH0_A> for bool {
    #[inline(always)]
    fn from(variant: AWD3CH0_A) -> Self {
        variant as u8 != 0
    }
}
impl AWD3CH0_R {
    #[doc = "Get enumerated values variant"]
    #[inline(always)]
    pub const fn variant(&self) -> AWD3CH0_A {
        match self.bits {
            false => AWD3CH0_A::B_0X0,
            true => AWD3CH0_A::B_0X1,
        }
    }
    #[doc = "ADC analog channel-x is not monitored by AWD3"]
    #[inline(always)]
    pub fn is_b_0x0(&self) -> bool {
        *self == AWD3CH0_A::B_0X0
    }
    #[doc = "ADC analog channel-x is monitored by AWD3"]
    #[inline(always)]
    pub fn is_b_0x1(&self) -> bool {
        *self == AWD3CH0_A::B_0X1
    }
}
#[doc = "Field `AWD3CH0` writer - Analog watchdog channel selection These bits are set and cleared by software. They enable and select the input channels to be guarded by analog watchdog 3 (AWD3). Note: The channels selected through ADC_AWD3CR must be also configured into the ADC_CHSELR registers. Refer to SQ8\\[3:0\\]
for a definition of channel selection. The software is allowed to write this bit only when ADSTART=0 (which ensures that no conversion is ongoing)."]
pub type AWD3CH0_W<'a, REG> = crate::BitWriter<'a, REG, AWD3CH0_A>;
impl<'a, REG> AWD3CH0_W<'a, REG>
where
    REG: crate::Writable + crate::RegisterSpec,
{
    #[doc = "ADC analog channel-x is not monitored by AWD3"]
    #[inline(always)]
    pub fn b_0x0(self) -> &'a mut crate::W<REG> {
        self.variant(AWD3CH0_A::B_0X0)
    }
    #[doc = "ADC analog channel-x is monitored by AWD3"]
    #[inline(always)]
    pub fn b_0x1(self) -> &'a mut crate::W<REG> {
        self.variant(AWD3CH0_A::B_0X1)
    }
}
#[doc = "Field `AWD3CH1` reader - Analog watchdog channel selection These bits are set and cleared by software. They enable and select the input channels to be guarded by analog watchdog 3 (AWD3). Note: The channels selected through ADC_AWD3CR must be also configured into the ADC_CHSELR registers. Refer to SQ8\\[3:0\\]
for a definition of channel selection. The software is allowed to write this bit only when ADSTART=0 (which ensures that no conversion is ongoing)."]
pub type AWD3CH1_R = crate::BitReader<AWD3CH1_A>;
#[doc = "Analog watchdog channel selection These bits are set and cleared by software. They enable and select the input channels to be guarded by analog watchdog 3 (AWD3). Note: The channels selected through ADC_AWD3CR must be also configured into the ADC_CHSELR registers. Refer to SQ8\\[3:0\\]
for a definition of channel selection. The software is allowed to write this bit only when ADSTART=0 (which ensures that no conversion is ongoing).\n\nValue on reset: 0"]
#[derive(Clone, Copy, Debug, PartialEq, Eq)]
pub enum AWD3CH1_A {
    #[doc = "0: ADC analog channel-x is not monitored by AWD3"]
    B_0X0 = 0,
    #[doc = "1: ADC analog channel-x is monitored by AWD3"]
    B_0X1 = 1,
}
impl From<AWD3CH1_A> for bool {
    #[inline(always)]
    fn from(variant: AWD3CH1_A) -> Self {
        variant as u8 != 0
    }
}
impl AWD3CH1_R {
    #[doc = "Get enumerated values variant"]
    #[inline(always)]
    pub const fn variant(&self) -> AWD3CH1_A {
        match self.bits {
            false => AWD3CH1_A::B_0X0,
            true => AWD3CH1_A::B_0X1,
        }
    }
    #[doc = "ADC analog channel-x is not monitored by AWD3"]
    #[inline(always)]
    pub fn is_b_0x0(&self) -> bool {
        *self == AWD3CH1_A::B_0X0
    }
    #[doc = "ADC analog channel-x is monitored by AWD3"]
    #[inline(always)]
    pub fn is_b_0x1(&self) -> bool {
        *self == AWD3CH1_A::B_0X1
    }
}
#[doc = "Field `AWD3CH1` writer - Analog watchdog channel selection These bits are set and cleared by software. They enable and select the input channels to be guarded by analog watchdog 3 (AWD3). Note: The channels selected through ADC_AWD3CR must be also configured into the ADC_CHSELR registers. Refer to SQ8\\[3:0\\]
for a definition of channel selection. The software is allowed to write this bit only when ADSTART=0 (which ensures that no conversion is ongoing)."]
pub type AWD3CH1_W<'a, REG> = crate::BitWriter<'a, REG, AWD3CH1_A>;
impl<'a, REG> AWD3CH1_W<'a, REG>
where
    REG: crate::Writable + crate::RegisterSpec,
{
    #[doc = "ADC analog channel-x is not monitored by AWD3"]
    #[inline(always)]
    pub fn b_0x0(self) -> &'a mut crate::W<REG> {
        self.variant(AWD3CH1_A::B_0X0)
    }
    #[doc = "ADC analog channel-x is monitored by AWD3"]
    #[inline(always)]
    pub fn b_0x1(self) -> &'a mut crate::W<REG> {
        self.variant(AWD3CH1_A::B_0X1)
    }
}
#[doc = "Field `AWD3CH2` reader - Analog watchdog channel selection These bits are set and cleared by software. They enable and select the input channels to be guarded by analog watchdog 3 (AWD3). Note: The channels selected through ADC_AWD3CR must be also configured into the ADC_CHSELR registers. Refer to SQ8\\[3:0\\]
for a definition of channel selection. The software is allowed to write this bit only when ADSTART=0 (which ensures that no conversion is ongoing)."]
pub type AWD3CH2_R = crate::BitReader<AWD3CH2_A>;
#[doc = "Analog watchdog channel selection These bits are set and cleared by software. They enable and select the input channels to be guarded by analog watchdog 3 (AWD3). Note: The channels selected through ADC_AWD3CR must be also configured into the ADC_CHSELR registers. Refer to SQ8\\[3:0\\]
for a definition of channel selection. The software is allowed to write this bit only when ADSTART=0 (which ensures that no conversion is ongoing).\n\nValue on reset: 0"]
#[derive(Clone, Copy, Debug, PartialEq, Eq)]
pub enum AWD3CH2_A {
    #[doc = "0: ADC analog channel-x is not monitored by AWD3"]
    B_0X0 = 0,
    #[doc = "1: ADC analog channel-x is monitored by AWD3"]
    B_0X1 = 1,
}
impl From<AWD3CH2_A> for bool {
    #[inline(always)]
    fn from(variant: AWD3CH2_A) -> Self {
        variant as u8 != 0
    }
}
impl AWD3CH2_R {
    #[doc = "Get enumerated values variant"]
    #[inline(always)]
    pub const fn variant(&self) -> AWD3CH2_A {
        match self.bits {
            false => AWD3CH2_A::B_0X0,
            true => AWD3CH2_A::B_0X1,
        }
    }
    #[doc = "ADC analog channel-x is not monitored by AWD3"]
    #[inline(always)]
    pub fn is_b_0x0(&self) -> bool {
        *self == AWD3CH2_A::B_0X0
    }
    #[doc = "ADC analog channel-x is monitored by AWD3"]
    #[inline(always)]
    pub fn is_b_0x1(&self) -> bool {
        *self == AWD3CH2_A::B_0X1
    }
}
#[doc = "Field `AWD3CH2` writer - Analog watchdog channel selection These bits are set and cleared by software. They enable and select the input channels to be guarded by analog watchdog 3 (AWD3). Note: The channels selected through ADC_AWD3CR must be also configured into the ADC_CHSELR registers. Refer to SQ8\\[3:0\\]
for a definition of channel selection. The software is allowed to write this bit only when ADSTART=0 (which ensures that no conversion is ongoing)."]
pub type AWD3CH2_W<'a, REG> = crate::BitWriter<'a, REG, AWD3CH2_A>;
impl<'a, REG> AWD3CH2_W<'a, REG>
where
    REG: crate::Writable + crate::RegisterSpec,
{
    #[doc = "ADC analog channel-x is not monitored by AWD3"]
    #[inline(always)]
    pub fn b_0x0(self) -> &'a mut crate::W<REG> {
        self.variant(AWD3CH2_A::B_0X0)
    }
    #[doc = "ADC analog channel-x is monitored by AWD3"]
    #[inline(always)]
    pub fn b_0x1(self) -> &'a mut crate::W<REG> {
        self.variant(AWD3CH2_A::B_0X1)
    }
}
#[doc = "Field `AWD3CH3` reader - Analog watchdog channel selection These bits are set and cleared by software. They enable and select the input channels to be guarded by analog watchdog 3 (AWD3). Note: The channels selected through ADC_AWD3CR must be also configured into the ADC_CHSELR registers. Refer to SQ8\\[3:0\\]
for a definition of channel selection. The software is allowed to write this bit only when ADSTART=0 (which ensures that no conversion is ongoing)."]
pub type AWD3CH3_R = crate::BitReader<AWD3CH3_A>;
#[doc = "Analog watchdog channel selection These bits are set and cleared by software. They enable and select the input channels to be guarded by analog watchdog 3 (AWD3). Note: The channels selected through ADC_AWD3CR must be also configured into the ADC_CHSELR registers. Refer to SQ8\\[3:0\\]
for a definition of channel selection. The software is allowed to write this bit only when ADSTART=0 (which ensures that no conversion is ongoing).\n\nValue on reset: 0"]
#[derive(Clone, Copy, Debug, PartialEq, Eq)]
pub enum AWD3CH3_A {
    #[doc = "0: ADC analog channel-x is not monitored by AWD3"]
    B_0X0 = 0,
    #[doc = "1: ADC analog channel-x is monitored by AWD3"]
    B_0X1 = 1,
}
impl From<AWD3CH3_A> for bool {
    #[inline(always)]
    fn from(variant: AWD3CH3_A) -> Self {
        variant as u8 != 0
    }
}
impl AWD3CH3_R {
    #[doc = "Get enumerated values variant"]
    #[inline(always)]
    pub const fn variant(&self) -> AWD3CH3_A {
        match self.bits {
            false => AWD3CH3_A::B_0X0,
            true => AWD3CH3_A::B_0X1,
        }
    }
    #[doc = "ADC analog channel-x is not monitored by AWD3"]
    #[inline(always)]
    pub fn is_b_0x0(&self) -> bool {
        *self == AWD3CH3_A::B_0X0
    }
    #[doc = "ADC analog channel-x is monitored by AWD3"]
    #[inline(always)]
    pub fn is_b_0x1(&self) -> bool {
        *self == AWD3CH3_A::B_0X1
    }
}
#[doc = "Field `AWD3CH3` writer - Analog watchdog channel selection These bits are set and cleared by software. They enable and select the input channels to be guarded by analog watchdog 3 (AWD3). Note: The channels selected through ADC_AWD3CR must be also configured into the ADC_CHSELR registers. Refer to SQ8\\[3:0\\]
for a definition of channel selection. The software is allowed to write this bit only when ADSTART=0 (which ensures that no conversion is ongoing)."]
pub type AWD3CH3_W<'a, REG> = crate::BitWriter<'a, REG, AWD3CH3_A>;
impl<'a, REG> AWD3CH3_W<'a, REG>
where
    REG: crate::Writable + crate::RegisterSpec,
{
    #[doc = "ADC analog channel-x is not monitored by AWD3"]
    #[inline(always)]
    pub fn b_0x0(self) -> &'a mut crate::W<REG> {
        self.variant(AWD3CH3_A::B_0X0)
    }
    #[doc = "ADC analog channel-x is monitored by AWD3"]
    #[inline(always)]
    pub fn b_0x1(self) -> &'a mut crate::W<REG> {
        self.variant(AWD3CH3_A::B_0X1)
    }
}
#[doc = "Field `AWD3CH4` reader - Analog watchdog channel selection These bits are set and cleared by software. They enable and select the input channels to be guarded by analog watchdog 3 (AWD3). Note: The channels selected through ADC_AWD3CR must be also configured into the ADC_CHSELR registers. Refer to SQ8\\[3:0\\]
for a definition of channel selection. The software is allowed to write this bit only when ADSTART=0 (which ensures that no conversion is ongoing)."]
pub type AWD3CH4_R = crate::BitReader<AWD3CH4_A>;
#[doc = "Analog watchdog channel selection These bits are set and cleared by software. They enable and select the input channels to be guarded by analog watchdog 3 (AWD3). Note: The channels selected through ADC_AWD3CR must be also configured into the ADC_CHSELR registers. Refer to SQ8\\[3:0\\]
for a definition of channel selection. The software is allowed to write this bit only when ADSTART=0 (which ensures that no conversion is ongoing).\n\nValue on reset: 0"]
#[derive(Clone, Copy, Debug, PartialEq, Eq)]
pub enum AWD3CH4_A {
    #[doc = "0: ADC analog channel-x is not monitored by AWD3"]
    B_0X0 = 0,
    #[doc = "1: ADC analog channel-x is monitored by AWD3"]
    B_0X1 = 1,
}
impl From<AWD3CH4_A> for bool {
    #[inline(always)]
    fn from(variant: AWD3CH4_A) -> Self {
        variant as u8 != 0
    }
}
impl AWD3CH4_R {
    #[doc = "Get enumerated values variant"]
    #[inline(always)]
    pub const fn variant(&self) -> AWD3CH4_A {
        match self.bits {
            false => AWD3CH4_A::B_0X0,
            true => AWD3CH4_A::B_0X1,
        }
    }
    #[doc = "ADC analog channel-x is not monitored by AWD3"]
    #[inline(always)]
    pub fn is_b_0x0(&self) -> bool {
        *self == AWD3CH4_A::B_0X0
    }
    #[doc = "ADC analog channel-x is monitored by AWD3"]
    #[inline(always)]
    pub fn is_b_0x1(&self) -> bool {
        *self == AWD3CH4_A::B_0X1
    }
}
#[doc = "Field `AWD3CH4` writer - Analog watchdog channel selection These bits are set and cleared by software. They enable and select the input channels to be guarded by analog watchdog 3 (AWD3). Note: The channels selected through ADC_AWD3CR must be also configured into the ADC_CHSELR registers. Refer to SQ8\\[3:0\\]
for a definition of channel selection. The software is allowed to write this bit only when ADSTART=0 (which ensures that no conversion is ongoing)."]
pub type AWD3CH4_W<'a, REG> = crate::BitWriter<'a, REG, AWD3CH4_A>;
impl<'a, REG> AWD3CH4_W<'a, REG>
where
    REG: crate::Writable + crate::RegisterSpec,
{
    #[doc = "ADC analog channel-x is not monitored by AWD3"]
    #[inline(always)]
    pub fn b_0x0(self) -> &'a mut crate::W<REG> {
        self.variant(AWD3CH4_A::B_0X0)
    }
    #[doc = "ADC analog channel-x is monitored by AWD3"]
    #[inline(always)]
    pub fn b_0x1(self) -> &'a mut crate::W<REG> {
        self.variant(AWD3CH4_A::B_0X1)
    }
}
#[doc = "Field `AWD3CH5` reader - Analog watchdog channel selection These bits are set and cleared by software. They enable and select the input channels to be guarded by analog watchdog 3 (AWD3). Note: The channels selected through ADC_AWD3CR must be also configured into the ADC_CHSELR registers. Refer to SQ8\\[3:0\\]
for a definition of channel selection. The software is allowed to write this bit only when ADSTART=0 (which ensures that no conversion is ongoing)."]
pub type AWD3CH5_R = crate::BitReader<AWD3CH5_A>;
#[doc = "Analog watchdog channel selection These bits are set and cleared by software. They enable and select the input channels to be guarded by analog watchdog 3 (AWD3). Note: The channels selected through ADC_AWD3CR must be also configured into the ADC_CHSELR registers. Refer to SQ8\\[3:0\\]
for a definition of channel selection. The software is allowed to write this bit only when ADSTART=0 (which ensures that no conversion is ongoing).\n\nValue on reset: 0"]
#[derive(Clone, Copy, Debug, PartialEq, Eq)]
pub enum AWD3CH5_A {
    #[doc = "0: ADC analog channel-x is not monitored by AWD3"]
    B_0X0 = 0,
    #[doc = "1: ADC analog channel-x is monitored by AWD3"]
    B_0X1 = 1,
}
impl From<AWD3CH5_A> for bool {
    #[inline(always)]
    fn from(variant: AWD3CH5_A) -> Self {
        variant as u8 != 0
    }
}
impl AWD3CH5_R {
    #[doc = "Get enumerated values variant"]
    #[inline(always)]
    pub const fn variant(&self) -> AWD3CH5_A {
        match self.bits {
            false => AWD3CH5_A::B_0X0,
            true => AWD3CH5_A::B_0X1,
        }
    }
    #[doc = "ADC analog channel-x is not monitored by AWD3"]
    #[inline(always)]
    pub fn is_b_0x0(&self) -> bool {
        *self == AWD3CH5_A::B_0X0
    }
    #[doc = "ADC analog channel-x is monitored by AWD3"]
    #[inline(always)]
    pub fn is_b_0x1(&self) -> bool {
        *self == AWD3CH5_A::B_0X1
    }
}
#[doc = "Field `AWD3CH5` writer - Analog watchdog channel selection These bits are set and cleared by software. They enable and select the input channels to be guarded by analog watchdog 3 (AWD3). Note: The channels selected through ADC_AWD3CR must be also configured into the ADC_CHSELR registers. Refer to SQ8\\[3:0\\]
for a definition of channel selection. The software is allowed to write this bit only when ADSTART=0 (which ensures that no conversion is ongoing)."]
pub type AWD3CH5_W<'a, REG> = crate::BitWriter<'a, REG, AWD3CH5_A>;
impl<'a, REG> AWD3CH5_W<'a, REG>
where
    REG: crate::Writable + crate::RegisterSpec,
{
    #[doc = "ADC analog channel-x is not monitored by AWD3"]
    #[inline(always)]
    pub fn b_0x0(self) -> &'a mut crate::W<REG> {
        self.variant(AWD3CH5_A::B_0X0)
    }
    #[doc = "ADC analog channel-x is monitored by AWD3"]
    #[inline(always)]
    pub fn b_0x1(self) -> &'a mut crate::W<REG> {
        self.variant(AWD3CH5_A::B_0X1)
    }
}
#[doc = "Field `AWD3CH6` reader - Analog watchdog channel selection These bits are set and cleared by software. They enable and select the input channels to be guarded by analog watchdog 3 (AWD3). Note: The channels selected through ADC_AWD3CR must be also configured into the ADC_CHSELR registers. Refer to SQ8\\[3:0\\]
for a definition of channel selection. The software is allowed to write this bit only when ADSTART=0 (which ensures that no conversion is ongoing)."]
pub type AWD3CH6_R = crate::BitReader<AWD3CH6_A>;
#[doc = "Analog watchdog channel selection These bits are set and cleared by software. They enable and select the input channels to be guarded by analog watchdog 3 (AWD3). Note: The channels selected through ADC_AWD3CR must be also configured into the ADC_CHSELR registers. Refer to SQ8\\[3:0\\]
for a definition of channel selection. The software is allowed to write this bit only when ADSTART=0 (which ensures that no conversion is ongoing).\n\nValue on reset: 0"]
#[derive(Clone, Copy, Debug, PartialEq, Eq)]
pub enum AWD3CH6_A {
    #[doc = "0: ADC analog channel-x is not monitored by AWD3"]
    B_0X0 = 0,
    #[doc = "1: ADC analog channel-x is monitored by AWD3"]
    B_0X1 = 1,
}
impl From<AWD3CH6_A> for bool {
    #[inline(always)]
    fn from(variant: AWD3CH6_A) -> Self {
        variant as u8 != 0
    }
}
impl AWD3CH6_R {
    #[doc = "Get enumerated values variant"]
    #[inline(always)]
    pub const fn variant(&self) -> AWD3CH6_A {
        match self.bits {
            false => AWD3CH6_A::B_0X0,
            true => AWD3CH6_A::B_0X1,
        }
    }
    #[doc = "ADC analog channel-x is not monitored by AWD3"]
    #[inline(always)]
    pub fn is_b_0x0(&self) -> bool {
        *self == AWD3CH6_A::B_0X0
    }
    #[doc = "ADC analog channel-x is monitored by AWD3"]
    #[inline(always)]
    pub fn is_b_0x1(&self) -> bool {
        *self == AWD3CH6_A::B_0X1
    }
}
#[doc = "Field `AWD3CH6` writer - Analog watchdog channel selection These bits are set and cleared by software. They enable and select the input channels to be guarded by analog watchdog 3 (AWD3). Note: The channels selected through ADC_AWD3CR must be also configured into the ADC_CHSELR registers. Refer to SQ8\\[3:0\\]
for a definition of channel selection. The software is allowed to write this bit only when ADSTART=0 (which ensures that no conversion is ongoing)."]
pub type AWD3CH6_W<'a, REG> = crate::BitWriter<'a, REG, AWD3CH6_A>;
impl<'a, REG> AWD3CH6_W<'a, REG>
where
    REG: crate::Writable + crate::RegisterSpec,
{
    #[doc = "ADC analog channel-x is not monitored by AWD3"]
    #[inline(always)]
    pub fn b_0x0(self) -> &'a mut crate::W<REG> {
        self.variant(AWD3CH6_A::B_0X0)
    }
    #[doc = "ADC analog channel-x is monitored by AWD3"]
    #[inline(always)]
    pub fn b_0x1(self) -> &'a mut crate::W<REG> {
        self.variant(AWD3CH6_A::B_0X1)
    }
}
#[doc = "Field `AWD3CH7` reader - Analog watchdog channel selection These bits are set and cleared by software. They enable and select the input channels to be guarded by analog watchdog 3 (AWD3). Note: The channels selected through ADC_AWD3CR must be also configured into the ADC_CHSELR registers. Refer to SQ8\\[3:0\\]
for a definition of channel selection. The software is allowed to write this bit only when ADSTART=0 (which ensures that no conversion is ongoing)."]
pub type AWD3CH7_R = crate::BitReader<AWD3CH7_A>;
#[doc = "Analog watchdog channel selection These bits are set and cleared by software. They enable and select the input channels to be guarded by analog watchdog 3 (AWD3). Note: The channels selected through ADC_AWD3CR must be also configured into the ADC_CHSELR registers. Refer to SQ8\\[3:0\\]
for a definition of channel selection. The software is allowed to write this bit only when ADSTART=0 (which ensures that no conversion is ongoing).\n\nValue on reset: 0"]
#[derive(Clone, Copy, Debug, PartialEq, Eq)]
pub enum AWD3CH7_A {
    #[doc = "0: ADC analog channel-x is not monitored by AWD3"]
    B_0X0 = 0,
    #[doc = "1: ADC analog channel-x is monitored by AWD3"]
    B_0X1 = 1,
}
impl From<AWD3CH7_A> for bool {
    #[inline(always)]
    fn from(variant: AWD3CH7_A) -> Self {
        variant as u8 != 0
    }
}
impl AWD3CH7_R {
    #[doc = "Get enumerated values variant"]
    #[inline(always)]
    pub const fn variant(&self) -> AWD3CH7_A {
        match self.bits {
            false => AWD3CH7_A::B_0X0,
            true => AWD3CH7_A::B_0X1,
        }
    }
    #[doc = "ADC analog channel-x is not monitored by AWD3"]
    #[inline(always)]
    pub fn is_b_0x0(&self) -> bool {
        *self == AWD3CH7_A::B_0X0
    }
    #[doc = "ADC analog channel-x is monitored by AWD3"]
    #[inline(always)]
    pub fn is_b_0x1(&self) -> bool {
        *self == AWD3CH7_A::B_0X1
    }
}
#[doc = "Field `AWD3CH7` writer - Analog watchdog channel selection These bits are set and cleared by software. They enable and select the input channels to be guarded by analog watchdog 3 (AWD3). Note: The channels selected through ADC_AWD3CR must be also configured into the ADC_CHSELR registers. Refer to SQ8\\[3:0\\]
for a definition of channel selection. The software is allowed to write this bit only when ADSTART=0 (which ensures that no conversion is ongoing)."]
pub type AWD3CH7_W<'a, REG> = crate::BitWriter<'a, REG, AWD3CH7_A>;
impl<'a, REG> AWD3CH7_W<'a, REG>
where
    REG: crate::Writable + crate::RegisterSpec,
{
    #[doc = "ADC analog channel-x is not monitored by AWD3"]
    #[inline(always)]
    pub fn b_0x0(self) -> &'a mut crate::W<REG> {
        self.variant(AWD3CH7_A::B_0X0)
    }
    #[doc = "ADC analog channel-x is monitored by AWD3"]
    #[inline(always)]
    pub fn b_0x1(self) -> &'a mut crate::W<REG> {
        self.variant(AWD3CH7_A::B_0X1)
    }
}
#[doc = "Field `AWD3CH8` reader - Analog watchdog channel selection These bits are set and cleared by software. They enable and select the input channels to be guarded by analog watchdog 3 (AWD3). Note: The channels selected through ADC_AWD3CR must be also configured into the ADC_CHSELR registers. Refer to SQ8\\[3:0\\]
for a definition of channel selection. The software is allowed to write this bit only when ADSTART=0 (which ensures that no conversion is ongoing)."]
pub type AWD3CH8_R = crate::BitReader<AWD3CH8_A>;
#[doc = "Analog watchdog channel selection These bits are set and cleared by software. They enable and select the input channels to be guarded by analog watchdog 3 (AWD3). Note: The channels selected through ADC_AWD3CR must be also configured into the ADC_CHSELR registers. Refer to SQ8\\[3:0\\]
for a definition of channel selection. The software is allowed to write this bit only when ADSTART=0 (which ensures that no conversion is ongoing).\n\nValue on reset: 0"]
#[derive(Clone, Copy, Debug, PartialEq, Eq)]
pub enum AWD3CH8_A {
    #[doc = "0: ADC analog channel-x is not monitored by AWD3"]
    B_0X0 = 0,
    #[doc = "1: ADC analog channel-x is monitored by AWD3"]
    B_0X1 = 1,
}
impl From<AWD3CH8_A> for bool {
    #[inline(always)]
    fn from(variant: AWD3CH8_A) -> Self {
        variant as u8 != 0
    }
}
impl AWD3CH8_R {
    #[doc = "Get enumerated values variant"]
    #[inline(always)]
    pub const fn variant(&self) -> AWD3CH8_A {
        match self.bits {
            false => AWD3CH8_A::B_0X0,
            true => AWD3CH8_A::B_0X1,
        }
    }
    #[doc = "ADC analog channel-x is not monitored by AWD3"]
    #[inline(always)]
    pub fn is_b_0x0(&self) -> bool {
        *self == AWD3CH8_A::B_0X0
    }
    #[doc = "ADC analog channel-x is monitored by AWD3"]
    #[inline(always)]
    pub fn is_b_0x1(&self) -> bool {
        *self == AWD3CH8_A::B_0X1
    }
}
#[doc = "Field `AWD3CH8` writer - Analog watchdog channel selection These bits are set and cleared by software. They enable and select the input channels to be guarded by analog watchdog 3 (AWD3). Note: The channels selected through ADC_AWD3CR must be also configured into the ADC_CHSELR registers. Refer to SQ8\\[3:0\\]
for a definition of channel selection. The software is allowed to write this bit only when ADSTART=0 (which ensures that no conversion is ongoing)."]
pub type AWD3CH8_W<'a, REG> = crate::BitWriter<'a, REG, AWD3CH8_A>;
impl<'a, REG> AWD3CH8_W<'a, REG>
where
    REG: crate::Writable + crate::RegisterSpec,
{
    #[doc = "ADC analog channel-x is not monitored by AWD3"]
    #[inline(always)]
    pub fn b_0x0(self) -> &'a mut crate::W<REG> {
        self.variant(AWD3CH8_A::B_0X0)
    }
    #[doc = "ADC analog channel-x is monitored by AWD3"]
    #[inline(always)]
    pub fn b_0x1(self) -> &'a mut crate::W<REG> {
        self.variant(AWD3CH8_A::B_0X1)
    }
}
#[doc = "Field `AWD3CH9` reader - Analog watchdog channel selection These bits are set and cleared by software. They enable and select the input channels to be guarded by analog watchdog 3 (AWD3). Note: The channels selected through ADC_AWD3CR must be also configured into the ADC_CHSELR registers. Refer to SQ8\\[3:0\\]
for a definition of channel selection. The software is allowed to write this bit only when ADSTART=0 (which ensures that no conversion is ongoing)."]
pub type AWD3CH9_R = crate::BitReader<AWD3CH9_A>;
#[doc = "Analog watchdog channel selection These bits are set and cleared by software. They enable and select the input channels to be guarded by analog watchdog 3 (AWD3). Note: The channels selected through ADC_AWD3CR must be also configured into the ADC_CHSELR registers. Refer to SQ8\\[3:0\\]
for a definition of channel selection. The software is allowed to write this bit only when ADSTART=0 (which ensures that no conversion is ongoing).\n\nValue on reset: 0"]
#[derive(Clone, Copy, Debug, PartialEq, Eq)]
pub enum AWD3CH9_A {
    #[doc = "0: ADC analog channel-x is not monitored by AWD3"]
    B_0X0 = 0,
    #[doc = "1: ADC analog channel-x is monitored by AWD3"]
    B_0X1 = 1,
}
impl From<AWD3CH9_A> for bool {
    #[inline(always)]
    fn from(variant: AWD3CH9_A) -> Self {
        variant as u8 != 0
    }
}
impl AWD3CH9_R {
    #[doc = "Get enumerated values variant"]
    #[inline(always)]
    pub const fn variant(&self) -> AWD3CH9_A {
        match self.bits {
            false => AWD3CH9_A::B_0X0,
            true => AWD3CH9_A::B_0X1,
        }
    }
    #[doc = "ADC analog channel-x is not monitored by AWD3"]
    #[inline(always)]
    pub fn is_b_0x0(&self) -> bool {
        *self == AWD3CH9_A::B_0X0
    }
    #[doc = "ADC analog channel-x is monitored by AWD3"]
    #[inline(always)]
    pub fn is_b_0x1(&self) -> bool {
        *self == AWD3CH9_A::B_0X1
    }
}
#[doc = "Field `AWD3CH9` writer - Analog watchdog channel selection These bits are set and cleared by software. They enable and select the input channels to be guarded by analog watchdog 3 (AWD3). Note: The channels selected through ADC_AWD3CR must be also configured into the ADC_CHSELR registers. Refer to SQ8\\[3:0\\]
for a definition of channel selection. The software is allowed to write this bit only when ADSTART=0 (which ensures that no conversion is ongoing)."]
pub type AWD3CH9_W<'a, REG> = crate::BitWriter<'a, REG, AWD3CH9_A>;
impl<'a, REG> AWD3CH9_W<'a, REG>
where
    REG: crate::Writable + crate::RegisterSpec,
{
    #[doc = "ADC analog channel-x is not monitored by AWD3"]
    #[inline(always)]
    pub fn b_0x0(self) -> &'a mut crate::W<REG> {
        self.variant(AWD3CH9_A::B_0X0)
    }
    #[doc = "ADC analog channel-x is monitored by AWD3"]
    #[inline(always)]
    pub fn b_0x1(self) -> &'a mut crate::W<REG> {
        self.variant(AWD3CH9_A::B_0X1)
    }
}
#[doc = "Field `AWD3CH10` reader - Analog watchdog channel selection These bits are set and cleared by software. They enable and select the input channels to be guarded by analog watchdog 3 (AWD3). Note: The channels selected through ADC_AWD3CR must be also configured into the ADC_CHSELR registers. Refer to SQ8\\[3:0\\]
for a definition of channel selection. The software is allowed to write this bit only when ADSTART=0 (which ensures that no conversion is ongoing)."]
pub type AWD3CH10_R = crate::BitReader<AWD3CH10_A>;
#[doc = "Analog watchdog channel selection These bits are set and cleared by software. They enable and select the input channels to be guarded by analog watchdog 3 (AWD3). Note: The channels selected through ADC_AWD3CR must be also configured into the ADC_CHSELR registers. Refer to SQ8\\[3:0\\]
for a definition of channel selection. The software is allowed to write this bit only when ADSTART=0 (which ensures that no conversion is ongoing).\n\nValue on reset: 0"]
#[derive(Clone, Copy, Debug, PartialEq, Eq)]
pub enum AWD3CH10_A {
    #[doc = "0: ADC analog channel-x is not monitored by AWD3"]
    B_0X0 = 0,
    #[doc = "1: ADC analog channel-x is monitored by AWD3"]
    B_0X1 = 1,
}
impl From<AWD3CH10_A> for bool {
    #[inline(always)]
    fn from(variant: AWD3CH10_A) -> Self {
        variant as u8 != 0
    }
}
impl AWD3CH10_R {
    #[doc = "Get enumerated values variant"]
    #[inline(always)]
    pub const fn variant(&self) -> AWD3CH10_A {
        match self.bits {
            false => AWD3CH10_A::B_0X0,
            true => AWD3CH10_A::B_0X1,
        }
    }
    #[doc = "ADC analog channel-x is not monitored by AWD3"]
    #[inline(always)]
    pub fn is_b_0x0(&self) -> bool {
        *self == AWD3CH10_A::B_0X0
    }
    #[doc = "ADC analog channel-x is monitored by AWD3"]
    #[inline(always)]
    pub fn is_b_0x1(&self) -> bool {
        *self == AWD3CH10_A::B_0X1
    }
}
#[doc = "Field `AWD3CH10` writer - Analog watchdog channel selection These bits are set and cleared by software. They enable and select the input channels to be guarded by analog watchdog 3 (AWD3). Note: The channels selected through ADC_AWD3CR must be also configured into the ADC_CHSELR registers. Refer to SQ8\\[3:0\\]
for a definition of channel selection. The software is allowed to write this bit only when ADSTART=0 (which ensures that no conversion is ongoing)."]
pub type AWD3CH10_W<'a, REG> = crate::BitWriter<'a, REG, AWD3CH10_A>;
impl<'a, REG> AWD3CH10_W<'a, REG>
where
    REG: crate::Writable + crate::RegisterSpec,
{
    #[doc = "ADC analog channel-x is not monitored by AWD3"]
    #[inline(always)]
    pub fn b_0x0(self) -> &'a mut crate::W<REG> {
        self.variant(AWD3CH10_A::B_0X0)
    }
    #[doc = "ADC analog channel-x is monitored by AWD3"]
    #[inline(always)]
    pub fn b_0x1(self) -> &'a mut crate::W<REG> {
        self.variant(AWD3CH10_A::B_0X1)
    }
}
#[doc = "Field `AWD3CH11` reader - Analog watchdog channel selection These bits are set and cleared by software. They enable and select the input channels to be guarded by analog watchdog 3 (AWD3). Note: The channels selected through ADC_AWD3CR must be also configured into the ADC_CHSELR registers. Refer to SQ8\\[3:0\\]
for a definition of channel selection. The software is allowed to write this bit only when ADSTART=0 (which ensures that no conversion is ongoing)."]
pub type AWD3CH11_R = crate::BitReader<AWD3CH11_A>;
#[doc = "Analog watchdog channel selection These bits are set and cleared by software. They enable and select the input channels to be guarded by analog watchdog 3 (AWD3). Note: The channels selected through ADC_AWD3CR must be also configured into the ADC_CHSELR registers. Refer to SQ8\\[3:0\\]
for a definition of channel selection. The software is allowed to write this bit only when ADSTART=0 (which ensures that no conversion is ongoing).\n\nValue on reset: 0"]
#[derive(Clone, Copy, Debug, PartialEq, Eq)]
pub enum AWD3CH11_A {
    #[doc = "0: ADC analog channel-x is not monitored by AWD3"]
    B_0X0 = 0,
    #[doc = "1: ADC analog channel-x is monitored by AWD3"]
    B_0X1 = 1,
}
impl From<AWD3CH11_A> for bool {
    #[inline(always)]
    fn from(variant: AWD3CH11_A) -> Self {
        variant as u8 != 0
    }
}
impl AWD3CH11_R {
    #[doc = "Get enumerated values variant"]
    #[inline(always)]
    pub const fn variant(&self) -> AWD3CH11_A {
        match self.bits {
            false => AWD3CH11_A::B_0X0,
            true => AWD3CH11_A::B_0X1,
        }
    }
    #[doc = "ADC analog channel-x is not monitored by AWD3"]
    #[inline(always)]
    pub fn is_b_0x0(&self) -> bool {
        *self == AWD3CH11_A::B_0X0
    }
    #[doc = "ADC analog channel-x is monitored by AWD3"]
    #[inline(always)]
    pub fn is_b_0x1(&self) -> bool {
        *self == AWD3CH11_A::B_0X1
    }
}
#[doc = "Field `AWD3CH11` writer - Analog watchdog channel selection These bits are set and cleared by software. They enable and select the input channels to be guarded by analog watchdog 3 (AWD3). Note: The channels selected through ADC_AWD3CR must be also configured into the ADC_CHSELR registers. Refer to SQ8\\[3:0\\]
for a definition of channel selection. The software is allowed to write this bit only when ADSTART=0 (which ensures that no conversion is ongoing)."]
pub type AWD3CH11_W<'a, REG> = crate::BitWriter<'a, REG, AWD3CH11_A>;
impl<'a, REG> AWD3CH11_W<'a, REG>
where
    REG: crate::Writable + crate::RegisterSpec,
{
    #[doc = "ADC analog channel-x is not monitored by AWD3"]
    #[inline(always)]
    pub fn b_0x0(self) -> &'a mut crate::W<REG> {
        self.variant(AWD3CH11_A::B_0X0)
    }
    #[doc = "ADC analog channel-x is monitored by AWD3"]
    #[inline(always)]
    pub fn b_0x1(self) -> &'a mut crate::W<REG> {
        self.variant(AWD3CH11_A::B_0X1)
    }
}
#[doc = "Field `AWD3CH12` reader - Analog watchdog channel selection These bits are set and cleared by software. They enable and select the input channels to be guarded by analog watchdog 3 (AWD3). Note: The channels selected through ADC_AWD3CR must be also configured into the ADC_CHSELR registers. Refer to SQ8\\[3:0\\]
for a definition of channel selection. The software is allowed to write this bit only when ADSTART=0 (which ensures that no conversion is ongoing)."]
pub type AWD3CH12_R = crate::BitReader<AWD3CH12_A>;
#[doc = "Analog watchdog channel selection These bits are set and cleared by software. They enable and select the input channels to be guarded by analog watchdog 3 (AWD3). Note: The channels selected through ADC_AWD3CR must be also configured into the ADC_CHSELR registers. Refer to SQ8\\[3:0\\]
for a definition of channel selection. The software is allowed to write this bit only when ADSTART=0 (which ensures that no conversion is ongoing).\n\nValue on reset: 0"]
#[derive(Clone, Copy, Debug, PartialEq, Eq)]
pub enum AWD3CH12_A {
    #[doc = "0: ADC analog channel-x is not monitored by AWD3"]
    B_0X0 = 0,
    #[doc = "1: ADC analog channel-x is monitored by AWD3"]
    B_0X1 = 1,
}
impl From<AWD3CH12_A> for bool {
    #[inline(always)]
    fn from(variant: AWD3CH12_A) -> Self {
        variant as u8 != 0
    }
}
impl AWD3CH12_R {
    #[doc = "Get enumerated values variant"]
    #[inline(always)]
    pub const fn variant(&self) -> AWD3CH12_A {
        match self.bits {
            false => AWD3CH12_A::B_0X0,
            true => AWD3CH12_A::B_0X1,
        }
    }
    #[doc = "ADC analog channel-x is not monitored by AWD3"]
    #[inline(always)]
    pub fn is_b_0x0(&self) -> bool {
        *self == AWD3CH12_A::B_0X0
    }
    #[doc = "ADC analog channel-x is monitored by AWD3"]
    #[inline(always)]
    pub fn is_b_0x1(&self) -> bool {
        *self == AWD3CH12_A::B_0X1
    }
}
#[doc = "Field `AWD3CH12` writer - Analog watchdog channel selection These bits are set and cleared by software. They enable and select the input channels to be guarded by analog watchdog 3 (AWD3). Note: The channels selected through ADC_AWD3CR must be also configured into the ADC_CHSELR registers. Refer to SQ8\\[3:0\\]
for a definition of channel selection. The software is allowed to write this bit only when ADSTART=0 (which ensures that no conversion is ongoing)."]
pub type AWD3CH12_W<'a, REG> = crate::BitWriter<'a, REG, AWD3CH12_A>;
impl<'a, REG> AWD3CH12_W<'a, REG>
where
    REG: crate::Writable + crate::RegisterSpec,
{
    #[doc = "ADC analog channel-x is not monitored by AWD3"]
    #[inline(always)]
    pub fn b_0x0(self) -> &'a mut crate::W<REG> {
        self.variant(AWD3CH12_A::B_0X0)
    }
    #[doc = "ADC analog channel-x is monitored by AWD3"]
    #[inline(always)]
    pub fn b_0x1(self) -> &'a mut crate::W<REG> {
        self.variant(AWD3CH12_A::B_0X1)
    }
}
#[doc = "Field `AWD3CH13` reader - Analog watchdog channel selection These bits are set and cleared by software. They enable and select the input channels to be guarded by analog watchdog 3 (AWD3). Note: The channels selected through ADC_AWD3CR must be also configured into the ADC_CHSELR registers. Refer to SQ8\\[3:0\\]
for a definition of channel selection. The software is allowed to write this bit only when ADSTART=0 (which ensures that no conversion is ongoing)."]
pub type AWD3CH13_R = crate::BitReader<AWD3CH13_A>;
#[doc = "Analog watchdog channel selection These bits are set and cleared by software. They enable and select the input channels to be guarded by analog watchdog 3 (AWD3). Note: The channels selected through ADC_AWD3CR must be also configured into the ADC_CHSELR registers. Refer to SQ8\\[3:0\\]
for a definition of channel selection. The software is allowed to write this bit only when ADSTART=0 (which ensures that no conversion is ongoing).\n\nValue on reset: 0"]
#[derive(Clone, Copy, Debug, PartialEq, Eq)]
pub enum AWD3CH13_A {
    #[doc = "0: ADC analog channel-x is not monitored by AWD3"]
    B_0X0 = 0,
    #[doc = "1: ADC analog channel-x is monitored by AWD3"]
    B_0X1 = 1,
}
impl From<AWD3CH13_A> for bool {
    #[inline(always)]
    fn from(variant: AWD3CH13_A) -> Self {
        variant as u8 != 0
    }
}
impl AWD3CH13_R {
    #[doc = "Get enumerated values variant"]
    #[inline(always)]
    pub const fn variant(&self) -> AWD3CH13_A {
        match self.bits {
            false => AWD3CH13_A::B_0X0,
            true => AWD3CH13_A::B_0X1,
        }
    }
    #[doc = "ADC analog channel-x is not monitored by AWD3"]
    #[inline(always)]
    pub fn is_b_0x0(&self) -> bool {
        *self == AWD3CH13_A::B_0X0
    }
    #[doc = "ADC analog channel-x is monitored by AWD3"]
    #[inline(always)]
    pub fn is_b_0x1(&self) -> bool {
        *self == AWD3CH13_A::B_0X1
    }
}
#[doc = "Field `AWD3CH13` writer - Analog watchdog channel selection These bits are set and cleared by software. They enable and select the input channels to be guarded by analog watchdog 3 (AWD3). Note: The channels selected through ADC_AWD3CR must be also configured into the ADC_CHSELR registers. Refer to SQ8\\[3:0\\]
for a definition of channel selection. The software is allowed to write this bit only when ADSTART=0 (which ensures that no conversion is ongoing)."]
pub type AWD3CH13_W<'a, REG> = crate::BitWriter<'a, REG, AWD3CH13_A>;
impl<'a, REG> AWD3CH13_W<'a, REG>
where
    REG: crate::Writable + crate::RegisterSpec,
{
    #[doc = "ADC analog channel-x is not monitored by AWD3"]
    #[inline(always)]
    pub fn b_0x0(self) -> &'a mut crate::W<REG> {
        self.variant(AWD3CH13_A::B_0X0)
    }
    #[doc = "ADC analog channel-x is monitored by AWD3"]
    #[inline(always)]
    pub fn b_0x1(self) -> &'a mut crate::W<REG> {
        self.variant(AWD3CH13_A::B_0X1)
    }
}
#[doc = "Field `AWD3CH14` reader - Analog watchdog channel selection These bits are set and cleared by software. They enable and select the input channels to be guarded by analog watchdog 3 (AWD3). Note: The channels selected through ADC_AWD3CR must be also configured into the ADC_CHSELR registers. Refer to SQ8\\[3:0\\]
for a definition of channel selection. The software is allowed to write this bit only when ADSTART=0 (which ensures that no conversion is ongoing)."]
pub type AWD3CH14_R = crate::BitReader<AWD3CH14_A>;
#[doc = "Analog watchdog channel selection These bits are set and cleared by software. They enable and select the input channels to be guarded by analog watchdog 3 (AWD3). Note: The channels selected through ADC_AWD3CR must be also configured into the ADC_CHSELR registers. Refer to SQ8\\[3:0\\]
for a definition of channel selection. The software is allowed to write this bit only when ADSTART=0 (which ensures that no conversion is ongoing).\n\nValue on reset: 0"]
#[derive(Clone, Copy, Debug, PartialEq, Eq)]
pub enum AWD3CH14_A {
    #[doc = "0: ADC analog channel-x is not monitored by AWD3"]
    B_0X0 = 0,
    #[doc = "1: ADC analog channel-x is monitored by AWD3"]
    B_0X1 = 1,
}
impl From<AWD3CH14_A> for bool {
    #[inline(always)]
    fn from(variant: AWD3CH14_A) -> Self {
        variant as u8 != 0
    }
}
impl AWD3CH14_R {
    #[doc = "Get enumerated values variant"]
    #[inline(always)]
    pub const fn variant(&self) -> AWD3CH14_A {
        match self.bits {
            false => AWD3CH14_A::B_0X0,
            true => AWD3CH14_A::B_0X1,
        }
    }
    #[doc = "ADC analog channel-x is not monitored by AWD3"]
    #[inline(always)]
    pub fn is_b_0x0(&self) -> bool {
        *self == AWD3CH14_A::B_0X0
    }
    #[doc = "ADC analog channel-x is monitored by AWD3"]
    #[inline(always)]
    pub fn is_b_0x1(&self) -> bool {
        *self == AWD3CH14_A::B_0X1
    }
}
#[doc = "Field `AWD3CH14` writer - Analog watchdog channel selection These bits are set and cleared by software. They enable and select the input channels to be guarded by analog watchdog 3 (AWD3). Note: The channels selected through ADC_AWD3CR must be also configured into the ADC_CHSELR registers. Refer to SQ8\\[3:0\\]
for a definition of channel selection. The software is allowed to write this bit only when ADSTART=0 (which ensures that no conversion is ongoing)."]
pub type AWD3CH14_W<'a, REG> = crate::BitWriter<'a, REG, AWD3CH14_A>;
impl<'a, REG> AWD3CH14_W<'a, REG>
where
    REG: crate::Writable + crate::RegisterSpec,
{
    #[doc = "ADC analog channel-x is not monitored by AWD3"]
    #[inline(always)]
    pub fn b_0x0(self) -> &'a mut crate::W<REG> {
        self.variant(AWD3CH14_A::B_0X0)
    }
    #[doc = "ADC analog channel-x is monitored by AWD3"]
    #[inline(always)]
    pub fn b_0x1(self) -> &'a mut crate::W<REG> {
        self.variant(AWD3CH14_A::B_0X1)
    }
}
#[doc = "Field `AWD3CH15` reader - Analog watchdog channel selection These bits are set and cleared by software. They enable and select the input channels to be guarded by analog watchdog 3 (AWD3). Note: The channels selected through ADC_AWD3CR must be also configured into the ADC_CHSELR registers. Refer to SQ8\\[3:0\\]
for a definition of channel selection. The software is allowed to write this bit only when ADSTART=0 (which ensures that no conversion is ongoing)."]
pub type AWD3CH15_R = crate::BitReader<AWD3CH15_A>;
#[doc = "Analog watchdog channel selection These bits are set and cleared by software. They enable and select the input channels to be guarded by analog watchdog 3 (AWD3). Note: The channels selected through ADC_AWD3CR must be also configured into the ADC_CHSELR registers. Refer to SQ8\\[3:0\\]
for a definition of channel selection. The software is allowed to write this bit only when ADSTART=0 (which ensures that no conversion is ongoing).\n\nValue on reset: 0"]
#[derive(Clone, Copy, Debug, PartialEq, Eq)]
pub enum AWD3CH15_A {
    #[doc = "0: ADC analog channel-x is not monitored by AWD3"]
    B_0X0 = 0,
    #[doc = "1: ADC analog channel-x is monitored by AWD3"]
    B_0X1 = 1,
}
impl From<AWD3CH15_A> for bool {
    #[inline(always)]
    fn from(variant: AWD3CH15_A) -> Self {
        variant as u8 != 0
    }
}
impl AWD3CH15_R {
    #[doc = "Get enumerated values variant"]
    #[inline(always)]
    pub const fn variant(&self) -> AWD3CH15_A {
        match self.bits {
            false => AWD3CH15_A::B_0X0,
            true => AWD3CH15_A::B_0X1,
        }
    }
    #[doc = "ADC analog channel-x is not monitored by AWD3"]
    #[inline(always)]
    pub fn is_b_0x0(&self) -> bool {
        *self == AWD3CH15_A::B_0X0
    }
    #[doc = "ADC analog channel-x is monitored by AWD3"]
    #[inline(always)]
    pub fn is_b_0x1(&self) -> bool {
        *self == AWD3CH15_A::B_0X1
    }
}
#[doc = "Field `AWD3CH15` writer - Analog watchdog channel selection These bits are set and cleared by software. They enable and select the input channels to be guarded by analog watchdog 3 (AWD3). Note: The channels selected through ADC_AWD3CR must be also configured into the ADC_CHSELR registers. Refer to SQ8\\[3:0\\]
for a definition of channel selection. The software is allowed to write this bit only when ADSTART=0 (which ensures that no conversion is ongoing)."]
pub type AWD3CH15_W<'a, REG> = crate::BitWriter<'a, REG, AWD3CH15_A>;
impl<'a, REG> AWD3CH15_W<'a, REG>
where
    REG: crate::Writable + crate::RegisterSpec,
{
    #[doc = "ADC analog channel-x is not monitored by AWD3"]
    #[inline(always)]
    pub fn b_0x0(self) -> &'a mut crate::W<REG> {
        self.variant(AWD3CH15_A::B_0X0)
    }
    #[doc = "ADC analog channel-x is monitored by AWD3"]
    #[inline(always)]
    pub fn b_0x1(self) -> &'a mut crate::W<REG> {
        self.variant(AWD3CH15_A::B_0X1)
    }
}
#[doc = "Field `AWD3CH16` reader - Analog watchdog channel selection These bits are set and cleared by software. They enable and select the input channels to be guarded by analog watchdog 3 (AWD3). Note: The channels selected through ADC_AWD3CR must be also configured into the ADC_CHSELR registers. Refer to SQ8\\[3:0\\]
for a definition of channel selection. The software is allowed to write this bit only when ADSTART=0 (which ensures that no conversion is ongoing)."]
pub type AWD3CH16_R = crate::BitReader<AWD3CH16_A>;
#[doc = "Analog watchdog channel selection These bits are set and cleared by software. They enable and select the input channels to be guarded by analog watchdog 3 (AWD3). Note: The channels selected through ADC_AWD3CR must be also configured into the ADC_CHSELR registers. Refer to SQ8\\[3:0\\]
for a definition of channel selection. The software is allowed to write this bit only when ADSTART=0 (which ensures that no conversion is ongoing).\n\nValue on reset: 0"]
#[derive(Clone, Copy, Debug, PartialEq, Eq)]
pub enum AWD3CH16_A {
    #[doc = "0: ADC analog channel-x is not monitored by AWD3"]
    B_0X0 = 0,
    #[doc = "1: ADC analog channel-x is monitored by AWD3"]
    B_0X1 = 1,
}
impl From<AWD3CH16_A> for bool {
    #[inline(always)]
    fn from(variant: AWD3CH16_A) -> Self {
        variant as u8 != 0
    }
}
impl AWD3CH16_R {
    #[doc = "Get enumerated values variant"]
    #[inline(always)]
    pub const fn variant(&self) -> AWD3CH16_A {
        match self.bits {
            false => AWD3CH16_A::B_0X0,
            true => AWD3CH16_A::B_0X1,
        }
    }
    #[doc = "ADC analog channel-x is not monitored by AWD3"]
    #[inline(always)]
    pub fn is_b_0x0(&self) -> bool {
        *self == AWD3CH16_A::B_0X0
    }
    #[doc = "ADC analog channel-x is monitored by AWD3"]
    #[inline(always)]
    pub fn is_b_0x1(&self) -> bool {
        *self == AWD3CH16_A::B_0X1
    }
}
#[doc = "Field `AWD3CH16` writer - Analog watchdog channel selection These bits are set and cleared by software. They enable and select the input channels to be guarded by analog watchdog 3 (AWD3). Note: The channels selected through ADC_AWD3CR must be also configured into the ADC_CHSELR registers. Refer to SQ8\\[3:0\\]
for a definition of channel selection. The software is allowed to write this bit only when ADSTART=0 (which ensures that no conversion is ongoing)."]
pub type AWD3CH16_W<'a, REG> = crate::BitWriter<'a, REG, AWD3CH16_A>;
impl<'a, REG> AWD3CH16_W<'a, REG>
where
    REG: crate::Writable + crate::RegisterSpec,
{
    #[doc = "ADC analog channel-x is not monitored by AWD3"]
    #[inline(always)]
    pub fn b_0x0(self) -> &'a mut crate::W<REG> {
        self.variant(AWD3CH16_A::B_0X0)
    }
    #[doc = "ADC analog channel-x is monitored by AWD3"]
    #[inline(always)]
    pub fn b_0x1(self) -> &'a mut crate::W<REG> {
        self.variant(AWD3CH16_A::B_0X1)
    }
}
#[doc = "Field `AWD3CH17` reader - Analog watchdog channel selection These bits are set and cleared by software. They enable and select the input channels to be guarded by analog watchdog 3 (AWD3). Note: The channels selected through ADC_AWD3CR must be also configured into the ADC_CHSELR registers. Refer to SQ8\\[3:0\\]
for a definition of channel selection. The software is allowed to write this bit only when ADSTART=0 (which ensures that no conversion is ongoing)."]
pub type AWD3CH17_R = crate::BitReader<AWD3CH17_A>;
#[doc = "Analog watchdog channel selection These bits are set and cleared by software. They enable and select the input channels to be guarded by analog watchdog 3 (AWD3). Note: The channels selected through ADC_AWD3CR must be also configured into the ADC_CHSELR registers. Refer to SQ8\\[3:0\\]
for a definition of channel selection. The software is allowed to write this bit only when ADSTART=0 (which ensures that no conversion is ongoing).\n\nValue on reset: 0"]
#[derive(Clone, Copy, Debug, PartialEq, Eq)]
pub enum AWD3CH17_A {
    #[doc = "0: ADC analog channel-x is not monitored by AWD3"]
    B_0X0 = 0,
    #[doc = "1: ADC analog channel-x is monitored by AWD3"]
    B_0X1 = 1,
}
impl From<AWD3CH17_A> for bool {
    #[inline(always)]
    fn from(variant: AWD3CH17_A) -> Self {
        variant as u8 != 0
    }
}
impl AWD3CH17_R {
    #[doc = "Get enumerated values variant"]
    #[inline(always)]
    pub const fn variant(&self) -> AWD3CH17_A {
        match self.bits {
            false => AWD3CH17_A::B_0X0,
            true => AWD3CH17_A::B_0X1,
        }
    }
    #[doc = "ADC analog channel-x is not monitored by AWD3"]
    #[inline(always)]
    pub fn is_b_0x0(&self) -> bool {
        *self == AWD3CH17_A::B_0X0
    }
    #[doc = "ADC analog channel-x is monitored by AWD3"]
    #[inline(always)]
    pub fn is_b_0x1(&self) -> bool {
        *self == AWD3CH17_A::B_0X1
    }
}
#[doc = "Field `AWD3CH17` writer - Analog watchdog channel selection These bits are set and cleared by software. They enable and select the input channels to be guarded by analog watchdog 3 (AWD3). Note: The channels selected through ADC_AWD3CR must be also configured into the ADC_CHSELR registers. Refer to SQ8\\[3:0\\]
for a definition of channel selection. The software is allowed to write this bit only when ADSTART=0 (which ensures that no conversion is ongoing)."]
pub type AWD3CH17_W<'a, REG> = crate::BitWriter<'a, REG, AWD3CH17_A>;
impl<'a, REG> AWD3CH17_W<'a, REG>
where
    REG: crate::Writable + crate::RegisterSpec,
{
    #[doc = "ADC analog channel-x is not monitored by AWD3"]
    #[inline(always)]
    pub fn b_0x0(self) -> &'a mut crate::W<REG> {
        self.variant(AWD3CH17_A::B_0X0)
    }
    #[doc = "ADC analog channel-x is monitored by AWD3"]
    #[inline(always)]
    pub fn b_0x1(self) -> &'a mut crate::W<REG> {
        self.variant(AWD3CH17_A::B_0X1)
    }
}
#[doc = "Field `AWD3CH18` reader - Analog watchdog channel selection These bits are set and cleared by software. They enable and select the input channels to be guarded by analog watchdog 3 (AWD3). Note: The channels selected through ADC_AWD3CR must be also configured into the ADC_CHSELR registers. Refer to SQ8\\[3:0\\]
for a definition of channel selection. The software is allowed to write this bit only when ADSTART=0 (which ensures that no conversion is ongoing)."]
pub type AWD3CH18_R = crate::BitReader<AWD3CH18_A>;
#[doc = "Analog watchdog channel selection These bits are set and cleared by software. They enable and select the input channels to be guarded by analog watchdog 3 (AWD3). Note: The channels selected through ADC_AWD3CR must be also configured into the ADC_CHSELR registers. Refer to SQ8\\[3:0\\]
for a definition of channel selection. The software is allowed to write this bit only when ADSTART=0 (which ensures that no conversion is ongoing).\n\nValue on reset: 0"]
#[derive(Clone, Copy, Debug, PartialEq, Eq)]
pub enum AWD3CH18_A {
    #[doc = "0: ADC analog channel-x is not monitored by AWD3"]
    B_0X0 = 0,
    #[doc = "1: ADC analog channel-x is monitored by AWD3"]
    B_0X1 = 1,
}
impl From<AWD3CH18_A> for bool {
    #[inline(always)]
    fn from(variant: AWD3CH18_A) -> Self {
        variant as u8 != 0
    }
}
impl AWD3CH18_R {
    #[doc = "Get enumerated values variant"]
    #[inline(always)]
    pub const fn variant(&self) -> AWD3CH18_A {
        match self.bits {
            false => AWD3CH18_A::B_0X0,
            true => AWD3CH18_A::B_0X1,
        }
    }
    #[doc = "ADC analog channel-x is not monitored by AWD3"]
    #[inline(always)]
    pub fn is_b_0x0(&self) -> bool {
        *self == AWD3CH18_A::B_0X0
    }
    #[doc = "ADC analog channel-x is monitored by AWD3"]
    #[inline(always)]
    pub fn is_b_0x1(&self) -> bool {
        *self == AWD3CH18_A::B_0X1
    }
}
#[doc = "Field `AWD3CH18` writer - Analog watchdog channel selection These bits are set and cleared by software. They enable and select the input channels to be guarded by analog watchdog 3 (AWD3). Note: The channels selected through ADC_AWD3CR must be also configured into the ADC_CHSELR registers. Refer to SQ8\\[3:0\\]
for a definition of channel selection. The software is allowed to write this bit only when ADSTART=0 (which ensures that no conversion is ongoing)."]
pub type AWD3CH18_W<'a, REG> = crate::BitWriter<'a, REG, AWD3CH18_A>;
impl<'a, REG> AWD3CH18_W<'a, REG>
where
    REG: crate::Writable + crate::RegisterSpec,
{
    #[doc = "ADC analog channel-x is not monitored by AWD3"]
    #[inline(always)]
    pub fn b_0x0(self) -> &'a mut crate::W<REG> {
        self.variant(AWD3CH18_A::B_0X0)
    }
    #[doc = "ADC analog channel-x is monitored by AWD3"]
    #[inline(always)]
    pub fn b_0x1(self) -> &'a mut crate::W<REG> {
        self.variant(AWD3CH18_A::B_0X1)
    }
}
impl R {
    #[doc = "Bit 0 - Analog watchdog channel selection These bits are set and cleared by software. They enable and select the input channels to be guarded by analog watchdog 3 (AWD3). Note: The channels selected through ADC_AWD3CR must be also configured into the ADC_CHSELR registers. Refer to SQ8\\[3:0\\]
for a definition of channel selection. The software is allowed to write this bit only when ADSTART=0 (which ensures that no conversion is ongoing)."]
    #[inline(always)]
    pub fn awd3ch0(&self) -> AWD3CH0_R {
        AWD3CH0_R::new((self.bits & 1) != 0)
    }
    #[doc = "Bit 1 - Analog watchdog channel selection These bits are set and cleared by software. They enable and select the input channels to be guarded by analog watchdog 3 (AWD3). Note: The channels selected through ADC_AWD3CR must be also configured into the ADC_CHSELR registers. Refer to SQ8\\[3:0\\]
for a definition of channel selection. The software is allowed to write this bit only when ADSTART=0 (which ensures that no conversion is ongoing)."]
    #[inline(always)]
    pub fn awd3ch1(&self) -> AWD3CH1_R {
        AWD3CH1_R::new(((self.bits >> 1) & 1) != 0)
    }
    #[doc = "Bit 2 - Analog watchdog channel selection These bits are set and cleared by software. They enable and select the input channels to be guarded by analog watchdog 3 (AWD3). Note: The channels selected through ADC_AWD3CR must be also configured into the ADC_CHSELR registers. Refer to SQ8\\[3:0\\]
for a definition of channel selection. The software is allowed to write this bit only when ADSTART=0 (which ensures that no conversion is ongoing)."]
    #[inline(always)]
    pub fn awd3ch2(&self) -> AWD3CH2_R {
        AWD3CH2_R::new(((self.bits >> 2) & 1) != 0)
    }
    #[doc = "Bit 3 - Analog watchdog channel selection These bits are set and cleared by software. They enable and select the input channels to be guarded by analog watchdog 3 (AWD3). Note: The channels selected through ADC_AWD3CR must be also configured into the ADC_CHSELR registers. Refer to SQ8\\[3:0\\]
for a definition of channel selection. The software is allowed to write this bit only when ADSTART=0 (which ensures that no conversion is ongoing)."]
    #[inline(always)]
    pub fn awd3ch3(&self) -> AWD3CH3_R {
        AWD3CH3_R::new(((self.bits >> 3) & 1) != 0)
    }
    #[doc = "Bit 4 - Analog watchdog channel selection These bits are set and cleared by software. They enable and select the input channels to be guarded by analog watchdog 3 (AWD3). Note: The channels selected through ADC_AWD3CR must be also configured into the ADC_CHSELR registers. Refer to SQ8\\[3:0\\]
for a definition of channel selection. The software is allowed to write this bit only when ADSTART=0 (which ensures that no conversion is ongoing)."]
    #[inline(always)]
    pub fn awd3ch4(&self) -> AWD3CH4_R {
        AWD3CH4_R::new(((self.bits >> 4) & 1) != 0)
    }
    #[doc = "Bit 5 - Analog watchdog channel selection These bits are set and cleared by software. They enable and select the input channels to be guarded by analog watchdog 3 (AWD3). Note: The channels selected through ADC_AWD3CR must be also configured into the ADC_CHSELR registers. Refer to SQ8\\[3:0\\]
for a definition of channel selection. The software is allowed to write this bit only when ADSTART=0 (which ensures that no conversion is ongoing)."]
    #[inline(always)]
    pub fn awd3ch5(&self) -> AWD3CH5_R {
        AWD3CH5_R::new(((self.bits >> 5) & 1) != 0)
    }
    #[doc = "Bit 6 - Analog watchdog channel selection These bits are set and cleared by software. They enable and select the input channels to be guarded by analog watchdog 3 (AWD3). Note: The channels selected through ADC_AWD3CR must be also configured into the ADC_CHSELR registers. Refer to SQ8\\[3:0\\]
for a definition of channel selection. The software is allowed to write this bit only when ADSTART=0 (which ensures that no conversion is ongoing)."]
    #[inline(always)]
    pub fn awd3ch6(&self) -> AWD3CH6_R {
        AWD3CH6_R::new(((self.bits >> 6) & 1) != 0)
    }
    #[doc = "Bit 7 - Analog watchdog channel selection These bits are set and cleared by software. They enable and select the input channels to be guarded by analog watchdog 3 (AWD3). Note: The channels selected through ADC_AWD3CR must be also configured into the ADC_CHSELR registers. Refer to SQ8\\[3:0\\]
for a definition of channel selection. The software is allowed to write this bit only when ADSTART=0 (which ensures that no conversion is ongoing)."]
    #[inline(always)]
    pub fn awd3ch7(&self) -> AWD3CH7_R {
        AWD3CH7_R::new(((self.bits >> 7) & 1) != 0)
    }
    #[doc = "Bit 8 - Analog watchdog channel selection These bits are set and cleared by software. They enable and select the input channels to be guarded by analog watchdog 3 (AWD3). Note: The channels selected through ADC_AWD3CR must be also configured into the ADC_CHSELR registers. Refer to SQ8\\[3:0\\]
for a definition of channel selection. The software is allowed to write this bit only when ADSTART=0 (which ensures that no conversion is ongoing)."]
    #[inline(always)]
    pub fn awd3ch8(&self) -> AWD3CH8_R {
        AWD3CH8_R::new(((self.bits >> 8) & 1) != 0)
    }
    #[doc = "Bit 9 - Analog watchdog channel selection These bits are set and cleared by software. They enable and select the input channels to be guarded by analog watchdog 3 (AWD3). Note: The channels selected through ADC_AWD3CR must be also configured into the ADC_CHSELR registers. Refer to SQ8\\[3:0\\]
for a definition of channel selection. The software is allowed to write this bit only when ADSTART=0 (which ensures that no conversion is ongoing)."]
    #[inline(always)]
    pub fn awd3ch9(&self) -> AWD3CH9_R {
        AWD3CH9_R::new(((self.bits >> 9) & 1) != 0)
    }
    #[doc = "Bit 10 - Analog watchdog channel selection These bits are set and cleared by software. They enable and select the input channels to be guarded by analog watchdog 3 (AWD3). Note: The channels selected through ADC_AWD3CR must be also configured into the ADC_CHSELR registers. Refer to SQ8\\[3:0\\]
for a definition of channel selection. The software is allowed to write this bit only when ADSTART=0 (which ensures that no conversion is ongoing)."]
    #[inline(always)]
    pub fn awd3ch10(&self) -> AWD3CH10_R {
        AWD3CH10_R::new(((self.bits >> 10) & 1) != 0)
    }
    #[doc = "Bit 11 - Analog watchdog channel selection These bits are set and cleared by software. They enable and select the input channels to be guarded by analog watchdog 3 (AWD3). Note: The channels selected through ADC_AWD3CR must be also configured into the ADC_CHSELR registers. Refer to SQ8\\[3:0\\]
for a definition of channel selection. The software is allowed to write this bit only when ADSTART=0 (which ensures that no conversion is ongoing)."]
    #[inline(always)]
    pub fn awd3ch11(&self) -> AWD3CH11_R {
        AWD3CH11_R::new(((self.bits >> 11) & 1) != 0)
    }
    #[doc = "Bit 12 - Analog watchdog channel selection These bits are set and cleared by software. They enable and select the input channels to be guarded by analog watchdog 3 (AWD3). Note: The channels selected through ADC_AWD3CR must be also configured into the ADC_CHSELR registers. Refer to SQ8\\[3:0\\]
for a definition of channel selection. The software is allowed to write this bit only when ADSTART=0 (which ensures that no conversion is ongoing)."]
    #[inline(always)]
    pub fn awd3ch12(&self) -> AWD3CH12_R {
        AWD3CH12_R::new(((self.bits >> 12) & 1) != 0)
    }
    #[doc = "Bit 13 - Analog watchdog channel selection These bits are set and cleared by software. They enable and select the input channels to be guarded by analog watchdog 3 (AWD3). Note: The channels selected through ADC_AWD3CR must be also configured into the ADC_CHSELR registers. Refer to SQ8\\[3:0\\]
for a definition of channel selection. The software is allowed to write this bit only when ADSTART=0 (which ensures that no conversion is ongoing)."]
    #[inline(always)]
    pub fn awd3ch13(&self) -> AWD3CH13_R {
        AWD3CH13_R::new(((self.bits >> 13) & 1) != 0)
    }
    #[doc = "Bit 14 - Analog watchdog channel selection These bits are set and cleared by software. They enable and select the input channels to be guarded by analog watchdog 3 (AWD3). Note: The channels selected through ADC_AWD3CR must be also configured into the ADC_CHSELR registers. Refer to SQ8\\[3:0\\]
for a definition of channel selection. The software is allowed to write this bit only when ADSTART=0 (which ensures that no conversion is ongoing)."]
    #[inline(always)]
    pub fn awd3ch14(&self) -> AWD3CH14_R {
        AWD3CH14_R::new(((self.bits >> 14) & 1) != 0)
    }
    #[doc = "Bit 15 - Analog watchdog channel selection These bits are set and cleared by software. They enable and select the input channels to be guarded by analog watchdog 3 (AWD3). Note: The channels selected through ADC_AWD3CR must be also configured into the ADC_CHSELR registers. Refer to SQ8\\[3:0\\]
for a definition of channel selection. The software is allowed to write this bit only when ADSTART=0 (which ensures that no conversion is ongoing)."]
    #[inline(always)]
    pub fn awd3ch15(&self) -> AWD3CH15_R {
        AWD3CH15_R::new(((self.bits >> 15) & 1) != 0)
    }
    #[doc = "Bit 16 - Analog watchdog channel selection These bits are set and cleared by software. They enable and select the input channels to be guarded by analog watchdog 3 (AWD3). Note: The channels selected through ADC_AWD3CR must be also configured into the ADC_CHSELR registers. Refer to SQ8\\[3:0\\]
for a definition of channel selection. The software is allowed to write this bit only when ADSTART=0 (which ensures that no conversion is ongoing)."]
    #[inline(always)]
    pub fn awd3ch16(&self) -> AWD3CH16_R {
        AWD3CH16_R::new(((self.bits >> 16) & 1) != 0)
    }
    #[doc = "Bit 17 - Analog watchdog channel selection These bits are set and cleared by software. They enable and select the input channels to be guarded by analog watchdog 3 (AWD3). Note: The channels selected through ADC_AWD3CR must be also configured into the ADC_CHSELR registers. Refer to SQ8\\[3:0\\]
for a definition of channel selection. The software is allowed to write this bit only when ADSTART=0 (which ensures that no conversion is ongoing)."]
    #[inline(always)]
    pub fn awd3ch17(&self) -> AWD3CH17_R {
        AWD3CH17_R::new(((self.bits >> 17) & 1) != 0)
    }
    #[doc = "Bit 18 - Analog watchdog channel selection These bits are set and cleared by software. They enable and select the input channels to be guarded by analog watchdog 3 (AWD3). Note: The channels selected through ADC_AWD3CR must be also configured into the ADC_CHSELR registers. Refer to SQ8\\[3:0\\]
for a definition of channel selection. The software is allowed to write this bit only when ADSTART=0 (which ensures that no conversion is ongoing)."]
    #[inline(always)]
    pub fn awd3ch18(&self) -> AWD3CH18_R {
        AWD3CH18_R::new(((self.bits >> 18) & 1) != 0)
    }
}
impl W {
    #[doc = "Bit 0 - Analog watchdog channel selection These bits are set and cleared by software. They enable and select the input channels to be guarded by analog watchdog 3 (AWD3). Note: The channels selected through ADC_AWD3CR must be also configured into the ADC_CHSELR registers. Refer to SQ8\\[3:0\\]
for a definition of channel selection. The software is allowed to write this bit only when ADSTART=0 (which ensures that no conversion is ongoing)."]
    #[inline(always)]
    #[must_use]
    pub fn awd3ch0(&mut self) -> AWD3CH0_W<ADC_AWD3CR_SPEC> {
        AWD3CH0_W::new(self, 0)
    }
    #[doc = "Bit 1 - Analog watchdog channel selection These bits are set and cleared by software. They enable and select the input channels to be guarded by analog watchdog 3 (AWD3). Note: The channels selected through ADC_AWD3CR must be also configured into the ADC_CHSELR registers. Refer to SQ8\\[3:0\\]
for a definition of channel selection. The software is allowed to write this bit only when ADSTART=0 (which ensures that no conversion is ongoing)."]
    #[inline(always)]
    #[must_use]
    pub fn awd3ch1(&mut self) -> AWD3CH1_W<ADC_AWD3CR_SPEC> {
        AWD3CH1_W::new(self, 1)
    }
    #[doc = "Bit 2 - Analog watchdog channel selection These bits are set and cleared by software. They enable and select the input channels to be guarded by analog watchdog 3 (AWD3). Note: The channels selected through ADC_AWD3CR must be also configured into the ADC_CHSELR registers. Refer to SQ8\\[3:0\\]
for a definition of channel selection. The software is allowed to write this bit only when ADSTART=0 (which ensures that no conversion is ongoing)."]
    #[inline(always)]
    #[must_use]
    pub fn awd3ch2(&mut self) -> AWD3CH2_W<ADC_AWD3CR_SPEC> {
        AWD3CH2_W::new(self, 2)
    }
    #[doc = "Bit 3 - Analog watchdog channel selection These bits are set and cleared by software. They enable and select the input channels to be guarded by analog watchdog 3 (AWD3). Note: The channels selected through ADC_AWD3CR must be also configured into the ADC_CHSELR registers. Refer to SQ8\\[3:0\\]
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
for a definition of channel selection. The software is allowed to write this bit only when ADSTART=0 (which ensures that no conversion is ongoing)."]
    #[inline(always)]
    #[must_use]
    pub fn awd3ch15(&mut self) -> AWD3CH15_W<ADC_AWD3CR_SPEC> {
        AWD3CH15_W::new(self, 15)
    }
    #[doc = "Bit 16 - Analog watchdog channel selection These bits are set and cleared by software. They enable and select the input channels to be guarded by analog watchdog 3 (AWD3). Note: The channels selected through ADC_AWD3CR must be also configured into the ADC_CHSELR registers. Refer to SQ8\\[3:0\\]
for a definition of channel selection. The software is allowed to write this bit only when ADSTART=0 (which ensures that no conversion is ongoing)."]
    #[inline(always)]
    #[must_use]
    pub fn awd3ch16(&mut self) -> AWD3CH16_W<ADC_AWD3CR_SPEC> {
        AWD3CH16_W::new(self, 16)
    }
    #[doc = "Bit 17 - Analog watchdog channel selection These bits are set and cleared by software. They enable and select the input channels to be guarded by analog watchdog 3 (AWD3). Note: The channels selected through ADC_AWD3CR must be also configured into the ADC_CHSELR registers. Refer to SQ8\\[3:0\\]
for a definition of channel selection. The software is allowed to write this bit only when ADSTART=0 (which ensures that no conversion is ongoing)."]
    #[inline(always)]
    #[must_use]
    pub fn awd3ch17(&mut self) -> AWD3CH17_W<ADC_AWD3CR_SPEC> {
        AWD3CH17_W::new(self, 17)
    }
    #[doc = "Bit 18 - Analog watchdog channel selection These bits are set and cleared by software. They enable and select the input channels to be guarded by analog watchdog 3 (AWD3). Note: The channels selected through ADC_AWD3CR must be also configured into the ADC_CHSELR registers. Refer to SQ8\\[3:0\\]
for a definition of channel selection. The software is allowed to write this bit only when ADSTART=0 (which ensures that no conversion is ongoing)."]
    #[inline(always)]
    #[must_use]
    pub fn awd3ch18(&mut self) -> AWD3CH18_W<ADC_AWD3CR_SPEC> {
        AWD3CH18_W::new(self, 18)
    }
    #[doc = r" Writes raw bits to the register."]
    #[doc = r""]
    #[doc = r" # Safety"]
    #[doc = r""]
    #[doc = r" Passing incorrect value can cause undefined behaviour. See reference manual"]
    #[inline(always)]
    pub unsafe fn bits(&mut self, bits: u32) -> &mut Self {
        self.bits = bits;
        self
    }
}
#[doc = "ADC Analog Watchdog 3 Configuration register\n\nYou can [`read`](crate::generic::Reg::read) this register and get [`adc_awd3cr::R`](R).  You can [`reset`](crate::generic::Reg::reset), [`write`](crate::generic::Reg::write), [`write_with_zero`](crate::generic::Reg::write_with_zero) this register using [`adc_awd3cr::W`](W). You can also [`modify`](crate::generic::Reg::modify) this register. See [API](https://docs.rs/svd2rust/#read--modify--write-api)."]
pub struct ADC_AWD3CR_SPEC;
impl crate::RegisterSpec for ADC_AWD3CR_SPEC {
    type Ux = u32;
}
#[doc = "`read()` method returns [`adc_awd3cr::R`](R) reader structure"]
impl crate::Readable for ADC_AWD3CR_SPEC {}
#[doc = "`write(|w| ..)` method takes [`adc_awd3cr::W`](W) writer structure"]
impl crate::Writable for ADC_AWD3CR_SPEC {
    const ZERO_TO_MODIFY_FIELDS_BITMAP: u32 = 0;
    const ONE_TO_MODIFY_FIELDS_BITMAP: u32 = 0;
}
#[doc = "`reset()` method sets ADC_AWD3CR to value 0"]
impl crate::Resettable for ADC_AWD3CR_SPEC {
    const RESET_VALUE: u32 = 0;
}
