RavuAlHemio/eprom5vread/code/on_board/stm32g0b0/src/adc/adc_chselr_1.rs

#[doc = "Register `ADC_CHSELR_1` reader"]
pub type R = crate::R<ADC_CHSELR_1_SPEC>;
#[doc = "Register `ADC_CHSELR_1` writer"]
pub type W = crate::W<ADC_CHSELR_1_SPEC>;
#[doc = "Field `SQ1` reader - 1st conversion of the sequence These bits are programmed by software with the channel number (0...14) assigned to the 8th conversion of the sequence. 0b1111 indicates end of the sequence. When 0b1111 (end of sequence) is programmed to the lower sequence channels, these bits are ignored. Refer to SQ8\\[3:0\\]
for a definition of channel selection. Note: The software is allowed to write this bit only when ADSTART=0 (which ensures that no conversion is ongoing)."]
pub type SQ1_R = crate::FieldReader;
#[doc = "Field `SQ1` writer - 1st conversion of the sequence These bits are programmed by software with the channel number (0...14) assigned to the 8th conversion of the sequence. 0b1111 indicates end of the sequence. When 0b1111 (end of sequence) is programmed to the lower sequence channels, these bits are ignored. Refer to SQ8\\[3:0\\]
for a definition of channel selection. Note: The software is allowed to write this bit only when ADSTART=0 (which ensures that no conversion is ongoing)."]
pub type SQ1_W<'a, REG> = crate::FieldWriter<'a, REG, 4>;
#[doc = "Field `SQ2` reader - 2nd conversion of the sequence These bits are programmed by software with the channel number (0...14) assigned to the 8th conversion of the sequence. 0b1111 indicates end of the sequence. When 0b1111 (end of sequence) is programmed to the lower sequence channels, these bits are ignored. Refer to SQ8\\[3:0\\]
for a definition of channel selection. Note: The software is allowed to write this bit only when ADSTART=0 (which ensures that no conversion is ongoing)."]
pub type SQ2_R = crate::FieldReader;
#[doc = "Field `SQ2` writer - 2nd conversion of the sequence These bits are programmed by software with the channel number (0...14) assigned to the 8th conversion of the sequence. 0b1111 indicates end of the sequence. When 0b1111 (end of sequence) is programmed to the lower sequence channels, these bits are ignored. Refer to SQ8\\[3:0\\]
for a definition of channel selection. Note: The software is allowed to write this bit only when ADSTART=0 (which ensures that no conversion is ongoing)."]
pub type SQ2_W<'a, REG> = crate::FieldWriter<'a, REG, 4>;
#[doc = "Field `SQ3` reader - 3rd conversion of the sequence These bits are programmed by software with the channel number (0...14) assigned to the 8th conversion of the sequence. 0b1111 indicates end of the sequence. When 0b1111 (end of sequence) is programmed to the lower sequence channels, these bits are ignored. Refer to SQ8\\[3:0\\]
for a definition of channel selection. Note: The software is allowed to write this bit only when ADSTART=0 (which ensures that no conversion is ongoing)."]
pub type SQ3_R = crate::FieldReader;
#[doc = "Field `SQ3` writer - 3rd conversion of the sequence These bits are programmed by software with the channel number (0...14) assigned to the 8th conversion of the sequence. 0b1111 indicates end of the sequence. When 0b1111 (end of sequence) is programmed to the lower sequence channels, these bits are ignored. Refer to SQ8\\[3:0\\]
for a definition of channel selection. Note: The software is allowed to write this bit only when ADSTART=0 (which ensures that no conversion is ongoing)."]
pub type SQ3_W<'a, REG> = crate::FieldWriter<'a, REG, 4>;
#[doc = "Field `SQ4` reader - 4th conversion of the sequence These bits are programmed by software with the channel number (0...14) assigned to the 8th conversion of the sequence. 0b1111 indicates end of the sequence. When 0b1111 (end of sequence) is programmed to the lower sequence channels, these bits are ignored. Refer to SQ8\\[3:0\\]
for a definition of channel selection. Note: The software is allowed to write this bit only when ADSTART=0 (which ensures that no conversion is ongoing)."]
pub type SQ4_R = crate::FieldReader;
#[doc = "Field `SQ4` writer - 4th conversion of the sequence These bits are programmed by software with the channel number (0...14) assigned to the 8th conversion of the sequence. 0b1111 indicates end of the sequence. When 0b1111 (end of sequence) is programmed to the lower sequence channels, these bits are ignored. Refer to SQ8\\[3:0\\]
for a definition of channel selection. Note: The software is allowed to write this bit only when ADSTART=0 (which ensures that no conversion is ongoing)."]
pub type SQ4_W<'a, REG> = crate::FieldWriter<'a, REG, 4>;
#[doc = "Field `SQ5` reader - 5th conversion of the sequence These bits are programmed by software with the channel number (0...14) assigned to the 8th conversion of the sequence. 0b1111 indicates end of the sequence. When 0b1111 (end of sequence) is programmed to the lower sequence channels, these bits are ignored. Refer to SQ8\\[3:0\\]
for a definition of channel selection. Note: The software is allowed to write this bit only when ADSTART=0 (which ensures that no conversion is ongoing)."]
pub type SQ5_R = crate::FieldReader;
#[doc = "Field `SQ5` writer - 5th conversion of the sequence These bits are programmed by software with the channel number (0...14) assigned to the 8th conversion of the sequence. 0b1111 indicates end of the sequence. When 0b1111 (end of sequence) is programmed to the lower sequence channels, these bits are ignored. Refer to SQ8\\[3:0\\]
for a definition of channel selection. Note: The software is allowed to write this bit only when ADSTART=0 (which ensures that no conversion is ongoing)."]
pub type SQ5_W<'a, REG> = crate::FieldWriter<'a, REG, 4>;
#[doc = "Field `SQ6` reader - 6th conversion of the sequence These bits are programmed by software with the channel number (0...14) assigned to the 8th conversion of the sequence. 0b1111 indicates end of the sequence. When 0b1111 (end of sequence) is programmed to the lower sequence channels, these bits are ignored. Refer to SQ8\\[3:0\\]
for a definition of channel selection. Note: The software is allowed to write this bit only when ADSTART=0 (which ensures that no conversion is ongoing)."]
pub type SQ6_R = crate::FieldReader;
#[doc = "Field `SQ6` writer - 6th conversion of the sequence These bits are programmed by software with the channel number (0...14) assigned to the 8th conversion of the sequence. 0b1111 indicates end of the sequence. When 0b1111 (end of sequence) is programmed to the lower sequence channels, these bits are ignored. Refer to SQ8\\[3:0\\]
for a definition of channel selection. Note: The software is allowed to write this bit only when ADSTART=0 (which ensures that no conversion is ongoing)."]
pub type SQ6_W<'a, REG> = crate::FieldWriter<'a, REG, 4>;
#[doc = "Field `SQ7` reader - 7th conversion of the sequence These bits are programmed by software with the channel number (0...14) assigned to the 8th conversion of the sequence. 0b1111 indicates end of the sequence. When 0b1111 (end of sequence) is programmed to the lower sequence channels, these bits are ignored. Refer to SQ8\\[3:0\\]
for a definition of channel selection. Note: The software is allowed to write this bit only when ADSTART=0 (which ensures that no conversion is ongoing)."]
pub type SQ7_R = crate::FieldReader;
#[doc = "Field `SQ7` writer - 7th conversion of the sequence These bits are programmed by software with the channel number (0...14) assigned to the 8th conversion of the sequence. 0b1111 indicates end of the sequence. When 0b1111 (end of sequence) is programmed to the lower sequence channels, these bits are ignored. Refer to SQ8\\[3:0\\]
for a definition of channel selection. Note: The software is allowed to write this bit only when ADSTART=0 (which ensures that no conversion is ongoing)."]
pub type SQ7_W<'a, REG> = crate::FieldWriter<'a, REG, 4>;
#[doc = "Field `SQ8` reader - 8th conversion of the sequence These bits are programmed by software with the channel number (0...14) assigned to the 8th conversion of the sequence. 0b1111 indicates the end of the sequence. When 0b1111 (end of sequence) is programmed to the lower sequence channels, these bits are ignored. ... Note: The software is allowed to write this bit only when ADSTART=0 (which ensures that no conversion is ongoing)."]
pub type SQ8_R = crate::FieldReader<SQ8_A>;
#[doc = "8th conversion of the sequence These bits are programmed by software with the channel number (0...14) assigned to the 8th conversion of the sequence. 0b1111 indicates the end of the sequence. When 0b1111 (end of sequence) is programmed to the lower sequence channels, these bits are ignored. ... Note: The software is allowed to write this bit only when ADSTART=0 (which ensures that no conversion is ongoing).\n\nValue on reset: 0"]
#[derive(Clone, Copy, Debug, PartialEq, Eq)]
#[repr(u8)]
pub enum SQ8_A {
    #[doc = "0: CH0"]
    B_0X0 = 0,
    #[doc = "1: CH1"]
    B_0X1 = 1,
    #[doc = "12: CH12"]
    B_0X_C = 12,
    #[doc = "13: CH13"]
    B_0X_D = 13,
    #[doc = "14: CH14"]
    B_0X_E = 14,
    #[doc = "15: No channel selected (End of sequence)"]
    B_0X_F = 15,
}
impl From<SQ8_A> for u8 {
    #[inline(always)]
    fn from(variant: SQ8_A) -> Self {
        variant as _
    }
}
impl crate::FieldSpec for SQ8_A {
    type Ux = u8;
}
impl SQ8_R {
    #[doc = "Get enumerated values variant"]
    #[inline(always)]
    pub const fn variant(&self) -> Option<SQ8_A> {
        match self.bits {
            0 => Some(SQ8_A::B_0X0),
            1 => Some(SQ8_A::B_0X1),
            12 => Some(SQ8_A::B_0X_C),
            13 => Some(SQ8_A::B_0X_D),
            14 => Some(SQ8_A::B_0X_E),
            15 => Some(SQ8_A::B_0X_F),
            _ => None,
        }
    }
    #[doc = "CH0"]
    #[inline(always)]
    pub fn is_b_0x0(&self) -> bool {
        *self == SQ8_A::B_0X0
    }
    #[doc = "CH1"]
    #[inline(always)]
    pub fn is_b_0x1(&self) -> bool {
        *self == SQ8_A::B_0X1
    }
    #[doc = "CH12"]
    #[inline(always)]
    pub fn is_b_0x_c(&self) -> bool {
        *self == SQ8_A::B_0X_C
    }
    #[doc = "CH13"]
    #[inline(always)]
    pub fn is_b_0x_d(&self) -> bool {
        *self == SQ8_A::B_0X_D
    }
    #[doc = "CH14"]
    #[inline(always)]
    pub fn is_b_0x_e(&self) -> bool {
        *self == SQ8_A::B_0X_E
    }
    #[doc = "No channel selected (End of sequence)"]
    #[inline(always)]
    pub fn is_b_0x_f(&self) -> bool {
        *self == SQ8_A::B_0X_F
    }
}
#[doc = "Field `SQ8` writer - 8th conversion of the sequence These bits are programmed by software with the channel number (0...14) assigned to the 8th conversion of the sequence. 0b1111 indicates the end of the sequence. When 0b1111 (end of sequence) is programmed to the lower sequence channels, these bits are ignored. ... Note: The software is allowed to write this bit only when ADSTART=0 (which ensures that no conversion is ongoing)."]
pub type SQ8_W<'a, REG> = crate::FieldWriter<'a, REG, 4, SQ8_A>;
impl<'a, REG> SQ8_W<'a, REG>
where
    REG: crate::Writable + crate::RegisterSpec,
    REG::Ux: From<u8>,
{
    #[doc = "CH0"]
    #[inline(always)]
    pub fn b_0x0(self) -> &'a mut crate::W<REG> {
        self.variant(SQ8_A::B_0X0)
    }
    #[doc = "CH1"]
    #[inline(always)]
    pub fn b_0x1(self) -> &'a mut crate::W<REG> {
        self.variant(SQ8_A::B_0X1)
    }
    #[doc = "CH12"]
    #[inline(always)]
    pub fn b_0x_c(self) -> &'a mut crate::W<REG> {
        self.variant(SQ8_A::B_0X_C)
    }
    #[doc = "CH13"]
    #[inline(always)]
    pub fn b_0x_d(self) -> &'a mut crate::W<REG> {
        self.variant(SQ8_A::B_0X_D)
    }
    #[doc = "CH14"]
    #[inline(always)]
    pub fn b_0x_e(self) -> &'a mut crate::W<REG> {
        self.variant(SQ8_A::B_0X_E)
    }
    #[doc = "No channel selected (End of sequence)"]
    #[inline(always)]
    pub fn b_0x_f(self) -> &'a mut crate::W<REG> {
        self.variant(SQ8_A::B_0X_F)
    }
}
impl R {
    #[doc = "Bits 0:3 - 1st conversion of the sequence These bits are programmed by software with the channel number (0...14) assigned to the 8th conversion of the sequence. 0b1111 indicates end of the sequence. When 0b1111 (end of sequence) is programmed to the lower sequence channels, these bits are ignored. Refer to SQ8\\[3:0\\]
for a definition of channel selection. Note: The software is allowed to write this bit only when ADSTART=0 (which ensures that no conversion is ongoing)."]
    #[inline(always)]
    pub fn sq1(&self) -> SQ1_R {
        SQ1_R::new((self.bits & 0x0f) as u8)
    }
    #[doc = "Bits 4:7 - 2nd conversion of the sequence These bits are programmed by software with the channel number (0...14) assigned to the 8th conversion of the sequence. 0b1111 indicates end of the sequence. When 0b1111 (end of sequence) is programmed to the lower sequence channels, these bits are ignored. Refer to SQ8\\[3:0\\]
for a definition of channel selection. Note: The software is allowed to write this bit only when ADSTART=0 (which ensures that no conversion is ongoing)."]
    #[inline(always)]
    pub fn sq2(&self) -> SQ2_R {
        SQ2_R::new(((self.bits >> 4) & 0x0f) as u8)
    }
    #[doc = "Bits 8:11 - 3rd conversion of the sequence These bits are programmed by software with the channel number (0...14) assigned to the 8th conversion of the sequence. 0b1111 indicates end of the sequence. When 0b1111 (end of sequence) is programmed to the lower sequence channels, these bits are ignored. Refer to SQ8\\[3:0\\]
for a definition of channel selection. Note: The software is allowed to write this bit only when ADSTART=0 (which ensures that no conversion is ongoing)."]
    #[inline(always)]
    pub fn sq3(&self) -> SQ3_R {
        SQ3_R::new(((self.bits >> 8) & 0x0f) as u8)
    }
    #[doc = "Bits 12:15 - 4th conversion of the sequence These bits are programmed by software with the channel number (0...14) assigned to the 8th conversion of the sequence. 0b1111 indicates end of the sequence. When 0b1111 (end of sequence) is programmed to the lower sequence channels, these bits are ignored. Refer to SQ8\\[3:0\\]
for a definition of channel selection. Note: The software is allowed to write this bit only when ADSTART=0 (which ensures that no conversion is ongoing)."]
    #[inline(always)]
    pub fn sq4(&self) -> SQ4_R {
        SQ4_R::new(((self.bits >> 12) & 0x0f) as u8)
    }
    #[doc = "Bits 16:19 - 5th conversion of the sequence These bits are programmed by software with the channel number (0...14) assigned to the 8th conversion of the sequence. 0b1111 indicates end of the sequence. When 0b1111 (end of sequence) is programmed to the lower sequence channels, these bits are ignored. Refer to SQ8\\[3:0\\]
for a definition of channel selection. Note: The software is allowed to write this bit only when ADSTART=0 (which ensures that no conversion is ongoing)."]
    #[inline(always)]
    pub fn sq5(&self) -> SQ5_R {
        SQ5_R::new(((self.bits >> 16) & 0x0f) as u8)
    }
    #[doc = "Bits 20:23 - 6th conversion of the sequence These bits are programmed by software with the channel number (0...14) assigned to the 8th conversion of the sequence. 0b1111 indicates end of the sequence. When 0b1111 (end of sequence) is programmed to the lower sequence channels, these bits are ignored. Refer to SQ8\\[3:0\\]
for a definition of channel selection. Note: The software is allowed to write this bit only when ADSTART=0 (which ensures that no conversion is ongoing)."]
    #[inline(always)]
    pub fn sq6(&self) -> SQ6_R {
        SQ6_R::new(((self.bits >> 20) & 0x0f) as u8)
    }
    #[doc = "Bits 24:27 - 7th conversion of the sequence These bits are programmed by software with the channel number (0...14) assigned to the 8th conversion of the sequence. 0b1111 indicates end of the sequence. When 0b1111 (end of sequence) is programmed to the lower sequence channels, these bits are ignored. Refer to SQ8\\[3:0\\]
for a definition of channel selection. Note: The software is allowed to write this bit only when ADSTART=0 (which ensures that no conversion is ongoing)."]
    #[inline(always)]
    pub fn sq7(&self) -> SQ7_R {
        SQ7_R::new(((self.bits >> 24) & 0x0f) as u8)
    }
    #[doc = "Bits 28:31 - 8th conversion of the sequence These bits are programmed by software with the channel number (0...14) assigned to the 8th conversion of the sequence. 0b1111 indicates the end of the sequence. When 0b1111 (end of sequence) is programmed to the lower sequence channels, these bits are ignored. ... Note: The software is allowed to write this bit only when ADSTART=0 (which ensures that no conversion is ongoing)."]
    #[inline(always)]
    pub fn sq8(&self) -> SQ8_R {
        SQ8_R::new(((self.bits >> 28) & 0x0f) as u8)
    }
}
impl W {
    #[doc = "Bits 0:3 - 1st conversion of the sequence These bits are programmed by software with the channel number (0...14) assigned to the 8th conversion of the sequence. 0b1111 indicates end of the sequence. When 0b1111 (end of sequence) is programmed to the lower sequence channels, these bits are ignored. Refer to SQ8\\[3:0\\]
for a definition of channel selection. Note: The software is allowed to write this bit only when ADSTART=0 (which ensures that no conversion is ongoing)."]
    #[inline(always)]
    #[must_use]
    pub fn sq1(&mut self) -> SQ1_W<ADC_CHSELR_1_SPEC> {
        SQ1_W::new(self, 0)
    }
    #[doc = "Bits 4:7 - 2nd conversion of the sequence These bits are programmed by software with the channel number (0...14) assigned to the 8th conversion of the sequence. 0b1111 indicates end of the sequence. When 0b1111 (end of sequence) is programmed to the lower sequence channels, these bits are ignored. Refer to SQ8\\[3:0\\]
for a definition of channel selection. Note: The software is allowed to write this bit only when ADSTART=0 (which ensures that no conversion is ongoing)."]
    #[inline(always)]
    #[must_use]
    pub fn sq2(&mut self) -> SQ2_W<ADC_CHSELR_1_SPEC> {
        SQ2_W::new(self, 4)
    }
    #[doc = "Bits 8:11 - 3rd conversion of the sequence These bits are programmed by software with the channel number (0...14) assigned to the 8th conversion of the sequence. 0b1111 indicates end of the sequence. When 0b1111 (end of sequence) is programmed to the lower sequence channels, these bits are ignored. Refer to SQ8\\[3:0\\]
for a definition of channel selection. Note: The software is allowed to write this bit only when ADSTART=0 (which ensures that no conversion is ongoing)."]
    #[inline(always)]
    #[must_use]
    pub fn sq3(&mut self) -> SQ3_W<ADC_CHSELR_1_SPEC> {
        SQ3_W::new(self, 8)
    }
    #[doc = "Bits 12:15 - 4th conversion of the sequence These bits are programmed by software with the channel number (0...14) assigned to the 8th conversion of the sequence. 0b1111 indicates end of the sequence. When 0b1111 (end of sequence) is programmed to the lower sequence channels, these bits are ignored. Refer to SQ8\\[3:0\\]
for a definition of channel selection. Note: The software is allowed to write this bit only when ADSTART=0 (which ensures that no conversion is ongoing)."]
    #[inline(always)]
    #[must_use]
    pub fn sq4(&mut self) -> SQ4_W<ADC_CHSELR_1_SPEC> {
        SQ4_W::new(self, 12)
    }
    #[doc = "Bits 16:19 - 5th conversion of the sequence These bits are programmed by software with the channel number (0...14) assigned to the 8th conversion of the sequence. 0b1111 indicates end of the sequence. When 0b1111 (end of sequence) is programmed to the lower sequence channels, these bits are ignored. Refer to SQ8\\[3:0\\]
for a definition of channel selection. Note: The software is allowed to write this bit only when ADSTART=0 (which ensures that no conversion is ongoing)."]
    #[inline(always)]
    #[must_use]
    pub fn sq5(&mut self) -> SQ5_W<ADC_CHSELR_1_SPEC> {
        SQ5_W::new(self, 16)
    }
    #[doc = "Bits 20:23 - 6th conversion of the sequence These bits are programmed by software with the channel number (0...14) assigned to the 8th conversion of the sequence. 0b1111 indicates end of the sequence. When 0b1111 (end of sequence) is programmed to the lower sequence channels, these bits are ignored. Refer to SQ8\\[3:0\\]
for a definition of channel selection. Note: The software is allowed to write this bit only when ADSTART=0 (which ensures that no conversion is ongoing)."]
    #[inline(always)]
    #[must_use]
    pub fn sq6(&mut self) -> SQ6_W<ADC_CHSELR_1_SPEC> {
        SQ6_W::new(self, 20)
    }
    #[doc = "Bits 24:27 - 7th conversion of the sequence These bits are programmed by software with the channel number (0...14) assigned to the 8th conversion of the sequence. 0b1111 indicates end of the sequence. When 0b1111 (end of sequence) is programmed to the lower sequence channels, these bits are ignored. Refer to SQ8\\[3:0\\]
for a definition of channel selection. Note: The software is allowed to write this bit only when ADSTART=0 (which ensures that no conversion is ongoing)."]
    #[inline(always)]
    #[must_use]
    pub fn sq7(&mut self) -> SQ7_W<ADC_CHSELR_1_SPEC> {
        SQ7_W::new(self, 24)
    }
    #[doc = "Bits 28:31 - 8th conversion of the sequence These bits are programmed by software with the channel number (0...14) assigned to the 8th conversion of the sequence. 0b1111 indicates the end of the sequence. When 0b1111 (end of sequence) is programmed to the lower sequence channels, these bits are ignored. ... Note: The software is allowed to write this bit only when ADSTART=0 (which ensures that no conversion is ongoing)."]
    #[inline(always)]
    #[must_use]
    pub fn sq8(&mut self) -> SQ8_W<ADC_CHSELR_1_SPEC> {
        SQ8_W::new(self, 28)
    }
    #[doc = r" Writes raw bits to the register."]
    #[doc = r""]
    #[doc = r" # Safety"]
    #[doc = r""]
    #[doc = r" Passing incorrect value can cause undefined behaviour. See reference manual"]
    #[inline(always)]
    pub unsafe fn bits(&mut self, bits: u32) -> &mut Self {
        self.bits = bits;
        self
    }
}
#[doc = "channel selection register CHSELRMOD = 1 in ADC_CFGR1\n\nYou can [`read`](crate::generic::Reg::read) this register and get [`adc_chselr_1::R`](R).  You can [`reset`](crate::generic::Reg::reset), [`write`](crate::generic::Reg::write), [`write_with_zero`](crate::generic::Reg::write_with_zero) this register using [`adc_chselr_1::W`](W). You can also [`modify`](crate::generic::Reg::modify) this register. See [API](https://docs.rs/svd2rust/#read--modify--write-api)."]
pub struct ADC_CHSELR_1_SPEC;
impl crate::RegisterSpec for ADC_CHSELR_1_SPEC {
    type Ux = u32;
}
#[doc = "`read()` method returns [`adc_chselr_1::R`](R) reader structure"]
impl crate::Readable for ADC_CHSELR_1_SPEC {}
#[doc = "`write(|w| ..)` method takes [`adc_chselr_1::W`](W) writer structure"]
impl crate::Writable for ADC_CHSELR_1_SPEC {
    const ZERO_TO_MODIFY_FIELDS_BITMAP: u32 = 0;
    const ONE_TO_MODIFY_FIELDS_BITMAP: u32 = 0;
}
#[doc = "`reset()` method sets ADC_CHSELR_1 to value 0"]
impl crate::Resettable for ADC_CHSELR_1_SPEC {
    const RESET_VALUE: u32 = 0;
}
