RavuAlHemio/eprom5vread/code/on_board/stm32g0b0/src/adc/adc_cr.rs

#[doc = "Register `ADC_CR` reader"]
pub type R = crate::R<ADC_CR_SPEC>;
#[doc = "Register `ADC_CR` writer"]
pub type W = crate::W<ADC_CR_SPEC>;
#[doc = "Field `ADEN` reader - ADC enable command This bit is set by software to enable the ADC. The ADC is effectively ready to operate once the ADRDY flag has been set. It is cleared by hardware when the ADC is disabled, after the execution of the ADDIS command. Note: The software is allowed to set ADEN only when all bits of ADC_CR registers are 0 (ADCAL=0, ADSTP=0, ADSTART=0, ADDIS=0 and ADEN=0)"]
pub type ADEN_R = crate::BitReader<ADEN_A>;
#[doc = "ADC enable command This bit is set by software to enable the ADC. The ADC is effectively ready to operate once the ADRDY flag has been set. It is cleared by hardware when the ADC is disabled, after the execution of the ADDIS command. Note: The software is allowed to set ADEN only when all bits of ADC_CR registers are 0 (ADCAL=0, ADSTP=0, ADSTART=0, ADDIS=0 and ADEN=0)\n\nValue on reset: 0"]
#[derive(Clone, Copy, Debug, PartialEq, Eq)]
pub enum ADEN_A {
    #[doc = "0: ADC is disabled (OFF state)"]
    B_0X0 = 0,
    #[doc = "1: Write 1 to enable the ADC."]
    B_0X1 = 1,
}
impl From<ADEN_A> for bool {
    #[inline(always)]
    fn from(variant: ADEN_A) -> Self {
        variant as u8 != 0
    }
}
impl ADEN_R {
    #[doc = "Get enumerated values variant"]
    #[inline(always)]
    pub const fn variant(&self) -> ADEN_A {
        match self.bits {
            false => ADEN_A::B_0X0,
            true => ADEN_A::B_0X1,
        }
    }
    #[doc = "ADC is disabled (OFF state)"]
    #[inline(always)]
    pub fn is_b_0x0(&self) -> bool {
        *self == ADEN_A::B_0X0
    }
    #[doc = "Write 1 to enable the ADC."]
    #[inline(always)]
    pub fn is_b_0x1(&self) -> bool {
        *self == ADEN_A::B_0X1
    }
}
#[doc = "Field `ADEN` writer - ADC enable command This bit is set by software to enable the ADC. The ADC is effectively ready to operate once the ADRDY flag has been set. It is cleared by hardware when the ADC is disabled, after the execution of the ADDIS command. Note: The software is allowed to set ADEN only when all bits of ADC_CR registers are 0 (ADCAL=0, ADSTP=0, ADSTART=0, ADDIS=0 and ADEN=0)"]
pub type ADEN_W<'a, REG> = crate::BitWriter<'a, REG, ADEN_A>;
impl<'a, REG> ADEN_W<'a, REG>
where
    REG: crate::Writable + crate::RegisterSpec,
{
    #[doc = "ADC is disabled (OFF state)"]
    #[inline(always)]
    pub fn b_0x0(self) -> &'a mut crate::W<REG> {
        self.variant(ADEN_A::B_0X0)
    }
    #[doc = "Write 1 to enable the ADC."]
    #[inline(always)]
    pub fn b_0x1(self) -> &'a mut crate::W<REG> {
        self.variant(ADEN_A::B_0X1)
    }
}
#[doc = "Field `ADDIS` reader - ADC disable command This bit is set by software to disable the ADC (ADDIS command) and put it into power-down state (OFF state). It is cleared by hardware once the ADC is effectively disabled (ADEN is also cleared by hardware at this time). Note: Setting ADDIS to '1' is only effective when ADEN=1 and ADSTART=0 (which ensures that no conversion is ongoing)"]
pub type ADDIS_R = crate::BitReader<ADDIS_A>;
#[doc = "ADC disable command This bit is set by software to disable the ADC (ADDIS command) and put it into power-down state (OFF state). It is cleared by hardware once the ADC is effectively disabled (ADEN is also cleared by hardware at this time). Note: Setting ADDIS to '1' is only effective when ADEN=1 and ADSTART=0 (which ensures that no conversion is ongoing)\n\nValue on reset: 0"]
#[derive(Clone, Copy, Debug, PartialEq, Eq)]
pub enum ADDIS_A {
    #[doc = "0: No ADDIS command ongoing"]
    B_0X0 = 0,
    #[doc = "1: Write 1 to disable the ADC. Read 1 means that an ADDIS command is in progress."]
    B_0X1 = 1,
}
impl From<ADDIS_A> for bool {
    #[inline(always)]
    fn from(variant: ADDIS_A) -> Self {
        variant as u8 != 0
    }
}
impl ADDIS_R {
    #[doc = "Get enumerated values variant"]
    #[inline(always)]
    pub const fn variant(&self) -> ADDIS_A {
        match self.bits {
            false => ADDIS_A::B_0X0,
            true => ADDIS_A::B_0X1,
        }
    }
    #[doc = "No ADDIS command ongoing"]
    #[inline(always)]
    pub fn is_b_0x0(&self) -> bool {
        *self == ADDIS_A::B_0X0
    }
    #[doc = "Write 1 to disable the ADC. Read 1 means that an ADDIS command is in progress."]
    #[inline(always)]
    pub fn is_b_0x1(&self) -> bool {
        *self == ADDIS_A::B_0X1
    }
}
#[doc = "Field `ADDIS` writer - ADC disable command This bit is set by software to disable the ADC (ADDIS command) and put it into power-down state (OFF state). It is cleared by hardware once the ADC is effectively disabled (ADEN is also cleared by hardware at this time). Note: Setting ADDIS to '1' is only effective when ADEN=1 and ADSTART=0 (which ensures that no conversion is ongoing)"]
pub type ADDIS_W<'a, REG> = crate::BitWriter<'a, REG, ADDIS_A>;
impl<'a, REG> ADDIS_W<'a, REG>
where
    REG: crate::Writable + crate::RegisterSpec,
{
    #[doc = "No ADDIS command ongoing"]
    #[inline(always)]
    pub fn b_0x0(self) -> &'a mut crate::W<REG> {
        self.variant(ADDIS_A::B_0X0)
    }
    #[doc = "Write 1 to disable the ADC. Read 1 means that an ADDIS command is in progress."]
    #[inline(always)]
    pub fn b_0x1(self) -> &'a mut crate::W<REG> {
        self.variant(ADDIS_A::B_0X1)
    }
}
#[doc = "Field `ADSTART` reader - ADC start conversion command This bit is set by software to start ADC conversion. Depending on the EXTEN \\[1:0\\]
configuration bits, a conversion either starts immediately (software trigger configuration) or once a hardware trigger event occurs (hardware trigger configuration). It is cleared by hardware: In single conversion mode (CONT=0, DISCEN=0), when software trigger is selected (EXTEN=00): at the assertion of the end of Conversion Sequence (EOS) flag. In discontinuous conversion mode(CONT=0, DISCEN=1), when the software trigger is selected (EXTEN=00): at the assertion of the end of Conversion (EOC) flag. In all other cases: after the execution of the ADSTP command, at the same time as the ADSTP bit is cleared by hardware. Note: The software is allowed to set ADSTART only when ADEN=1 and ADDIS=0 (ADC is enabled and there is no pending request to disable the ADC). After writing to ADC_CHSELR register or changing CHSELRMOD or SCANDIRW, it is mandatory to wait until CCRDY flag is asserted before setting ADSTART, otherwise, the value written to ADSTART is ignored."]
pub type ADSTART_R = crate::BitReader<ADSTART_A>;
#[doc = "ADC start conversion command This bit is set by software to start ADC conversion. Depending on the EXTEN \\[1:0\\]
configuration bits, a conversion either starts immediately (software trigger configuration) or once a hardware trigger event occurs (hardware trigger configuration). It is cleared by hardware: In single conversion mode (CONT=0, DISCEN=0), when software trigger is selected (EXTEN=00): at the assertion of the end of Conversion Sequence (EOS) flag. In discontinuous conversion mode(CONT=0, DISCEN=1), when the software trigger is selected (EXTEN=00): at the assertion of the end of Conversion (EOC) flag. In all other cases: after the execution of the ADSTP command, at the same time as the ADSTP bit is cleared by hardware. Note: The software is allowed to set ADSTART only when ADEN=1 and ADDIS=0 (ADC is enabled and there is no pending request to disable the ADC). After writing to ADC_CHSELR register or changing CHSELRMOD or SCANDIRW, it is mandatory to wait until CCRDY flag is asserted before setting ADSTART, otherwise, the value written to ADSTART is ignored.\n\nValue on reset: 0"]
#[derive(Clone, Copy, Debug, PartialEq, Eq)]
pub enum ADSTART_A {
    #[doc = "0: No ADC conversion is ongoing."]
    B_0X0 = 0,
    #[doc = "1: Write 1 to start the ADC. Read 1 means that the ADC is operating and may be converting."]
    B_0X1 = 1,
}
impl From<ADSTART_A> for bool {
    #[inline(always)]
    fn from(variant: ADSTART_A) -> Self {
        variant as u8 != 0
    }
}
impl ADSTART_R {
    #[doc = "Get enumerated values variant"]
    #[inline(always)]
    pub const fn variant(&self) -> ADSTART_A {
        match self.bits {
            false => ADSTART_A::B_0X0,
            true => ADSTART_A::B_0X1,
        }
    }
    #[doc = "No ADC conversion is ongoing."]
    #[inline(always)]
    pub fn is_b_0x0(&self) -> bool {
        *self == ADSTART_A::B_0X0
    }
    #[doc = "Write 1 to start the ADC. Read 1 means that the ADC is operating and may be converting."]
    #[inline(always)]
    pub fn is_b_0x1(&self) -> bool {
        *self == ADSTART_A::B_0X1
    }
}
#[doc = "Field `ADSTART` writer - ADC start conversion command This bit is set by software to start ADC conversion. Depending on the EXTEN \\[1:0\\]
configuration bits, a conversion either starts immediately (software trigger configuration) or once a hardware trigger event occurs (hardware trigger configuration). It is cleared by hardware: In single conversion mode (CONT=0, DISCEN=0), when software trigger is selected (EXTEN=00): at the assertion of the end of Conversion Sequence (EOS) flag. In discontinuous conversion mode(CONT=0, DISCEN=1), when the software trigger is selected (EXTEN=00): at the assertion of the end of Conversion (EOC) flag. In all other cases: after the execution of the ADSTP command, at the same time as the ADSTP bit is cleared by hardware. Note: The software is allowed to set ADSTART only when ADEN=1 and ADDIS=0 (ADC is enabled and there is no pending request to disable the ADC). After writing to ADC_CHSELR register or changing CHSELRMOD or SCANDIRW, it is mandatory to wait until CCRDY flag is asserted before setting ADSTART, otherwise, the value written to ADSTART is ignored."]
pub type ADSTART_W<'a, REG> = crate::BitWriter<'a, REG, ADSTART_A>;
impl<'a, REG> ADSTART_W<'a, REG>
where
    REG: crate::Writable + crate::RegisterSpec,
{
    #[doc = "No ADC conversion is ongoing."]
    #[inline(always)]
    pub fn b_0x0(self) -> &'a mut crate::W<REG> {
        self.variant(ADSTART_A::B_0X0)
    }
    #[doc = "Write 1 to start the ADC. Read 1 means that the ADC is operating and may be converting."]
    #[inline(always)]
    pub fn b_0x1(self) -> &'a mut crate::W<REG> {
        self.variant(ADSTART_A::B_0X1)
    }
}
#[doc = "Field `ADSTP` reader - ADC stop conversion command This bit is set by software to stop and discard an ongoing conversion (ADSTP Command). It is cleared by hardware when the conversion is effectively discarded and the ADC is ready to accept a new start conversion command. Note: Setting ADSTP to '1' is only effective when ADSTART=1 and ADDIS=0 (ADC is enabled and may be converting and there is no pending request to disable the ADC)"]
pub type ADSTP_R = crate::BitReader<ADSTP_A>;
#[doc = "ADC stop conversion command This bit is set by software to stop and discard an ongoing conversion (ADSTP Command). It is cleared by hardware when the conversion is effectively discarded and the ADC is ready to accept a new start conversion command. Note: Setting ADSTP to '1' is only effective when ADSTART=1 and ADDIS=0 (ADC is enabled and may be converting and there is no pending request to disable the ADC)\n\nValue on reset: 0"]
#[derive(Clone, Copy, Debug, PartialEq, Eq)]
pub enum ADSTP_A {
    #[doc = "0: No ADC stop conversion command ongoing"]
    B_0X0 = 0,
    #[doc = "1: Write 1 to stop the ADC. Read 1 means that an ADSTP command is in progress."]
    B_0X1 = 1,
}
impl From<ADSTP_A> for bool {
    #[inline(always)]
    fn from(variant: ADSTP_A) -> Self {
        variant as u8 != 0
    }
}
impl ADSTP_R {
    #[doc = "Get enumerated values variant"]
    #[inline(always)]
    pub const fn variant(&self) -> ADSTP_A {
        match self.bits {
            false => ADSTP_A::B_0X0,
            true => ADSTP_A::B_0X1,
        }
    }
    #[doc = "No ADC stop conversion command ongoing"]
    #[inline(always)]
    pub fn is_b_0x0(&self) -> bool {
        *self == ADSTP_A::B_0X0
    }
    #[doc = "Write 1 to stop the ADC. Read 1 means that an ADSTP command is in progress."]
    #[inline(always)]
    pub fn is_b_0x1(&self) -> bool {
        *self == ADSTP_A::B_0X1
    }
}
#[doc = "Field `ADSTP` writer - ADC stop conversion command This bit is set by software to stop and discard an ongoing conversion (ADSTP Command). It is cleared by hardware when the conversion is effectively discarded and the ADC is ready to accept a new start conversion command. Note: Setting ADSTP to '1' is only effective when ADSTART=1 and ADDIS=0 (ADC is enabled and may be converting and there is no pending request to disable the ADC)"]
pub type ADSTP_W<'a, REG> = crate::BitWriter<'a, REG, ADSTP_A>;
impl<'a, REG> ADSTP_W<'a, REG>
where
    REG: crate::Writable + crate::RegisterSpec,
{
    #[doc = "No ADC stop conversion command ongoing"]
    #[inline(always)]
    pub fn b_0x0(self) -> &'a mut crate::W<REG> {
        self.variant(ADSTP_A::B_0X0)
    }
    #[doc = "Write 1 to stop the ADC. Read 1 means that an ADSTP command is in progress."]
    #[inline(always)]
    pub fn b_0x1(self) -> &'a mut crate::W<REG> {
        self.variant(ADSTP_A::B_0X1)
    }
}
#[doc = "Field `ADVREGEN` reader - ADC Voltage Regulator Enable This bit is set by software, to enable the ADC internal voltage regulator. The voltage regulator output is available after tADCVREG_SETUP. It is cleared by software to disable the voltage regulator. It can be cleared only if ADEN is et to 0. Note: The software is allowed to program this bit field only when the ADC is disabled (ADCAL=0, ADSTART=0, ADSTP=0, ADDIS=0 and ADEN=0)."]
pub type ADVREGEN_R = crate::BitReader<ADVREGEN_A>;
#[doc = "ADC Voltage Regulator Enable This bit is set by software, to enable the ADC internal voltage regulator. The voltage regulator output is available after tADCVREG_SETUP. It is cleared by software to disable the voltage regulator. It can be cleared only if ADEN is et to 0. Note: The software is allowed to program this bit field only when the ADC is disabled (ADCAL=0, ADSTART=0, ADSTP=0, ADDIS=0 and ADEN=0).\n\nValue on reset: 0"]
#[derive(Clone, Copy, Debug, PartialEq, Eq)]
pub enum ADVREGEN_A {
    #[doc = "0: ADC voltage regulator disabled"]
    B_0X0 = 0,
    #[doc = "1: ADC voltage regulator enabled"]
    B_0X1 = 1,
}
impl From<ADVREGEN_A> for bool {
    #[inline(always)]
    fn from(variant: ADVREGEN_A) -> Self {
        variant as u8 != 0
    }
}
impl ADVREGEN_R {
    #[doc = "Get enumerated values variant"]
    #[inline(always)]
    pub const fn variant(&self) -> ADVREGEN_A {
        match self.bits {
            false => ADVREGEN_A::B_0X0,
            true => ADVREGEN_A::B_0X1,
        }
    }
    #[doc = "ADC voltage regulator disabled"]
    #[inline(always)]
    pub fn is_b_0x0(&self) -> bool {
        *self == ADVREGEN_A::B_0X0
    }
    #[doc = "ADC voltage regulator enabled"]
    #[inline(always)]
    pub fn is_b_0x1(&self) -> bool {
        *self == ADVREGEN_A::B_0X1
    }
}
#[doc = "Field `ADVREGEN` writer - ADC Voltage Regulator Enable This bit is set by software, to enable the ADC internal voltage regulator. The voltage regulator output is available after tADCVREG_SETUP. It is cleared by software to disable the voltage regulator. It can be cleared only if ADEN is et to 0. Note: The software is allowed to program this bit field only when the ADC is disabled (ADCAL=0, ADSTART=0, ADSTP=0, ADDIS=0 and ADEN=0)."]
pub type ADVREGEN_W<'a, REG> = crate::BitWriter<'a, REG, ADVREGEN_A>;
impl<'a, REG> ADVREGEN_W<'a, REG>
where
    REG: crate::Writable + crate::RegisterSpec,
{
    #[doc = "ADC voltage regulator disabled"]
    #[inline(always)]
    pub fn b_0x0(self) -> &'a mut crate::W<REG> {
        self.variant(ADVREGEN_A::B_0X0)
    }
    #[doc = "ADC voltage regulator enabled"]
    #[inline(always)]
    pub fn b_0x1(self) -> &'a mut crate::W<REG> {
        self.variant(ADVREGEN_A::B_0X1)
    }
}
#[doc = "Field `ADCAL` reader - ADC calibration This bit is set by software to start the calibration of the ADC. It is cleared by hardware after calibration is complete. Note: The software is allowed to set ADCAL only when the ADC is disabled (ADCAL=0, ADSTART=0, ADSTP=0, ADDIS=0 and ADEN=0). The software is allowed to update the calibration factor by writing ADC_CALFACT only when ADEN=1 and ADSTART=0 (ADC enabled and no conversion is ongoing)."]
pub type ADCAL_R = crate::BitReader<ADCAL_A>;
#[doc = "ADC calibration This bit is set by software to start the calibration of the ADC. It is cleared by hardware after calibration is complete. Note: The software is allowed to set ADCAL only when the ADC is disabled (ADCAL=0, ADSTART=0, ADSTP=0, ADDIS=0 and ADEN=0). The software is allowed to update the calibration factor by writing ADC_CALFACT only when ADEN=1 and ADSTART=0 (ADC enabled and no conversion is ongoing).\n\nValue on reset: 0"]
#[derive(Clone, Copy, Debug, PartialEq, Eq)]
pub enum ADCAL_A {
    #[doc = "0: Calibration complete"]
    B_0X0 = 0,
    #[doc = "1: Write 1 to calibrate the ADC. Read at 1 means that a calibration is in progress."]
    B_0X1 = 1,
}
impl From<ADCAL_A> for bool {
    #[inline(always)]
    fn from(variant: ADCAL_A) -> Self {
        variant as u8 != 0
    }
}
impl ADCAL_R {
    #[doc = "Get enumerated values variant"]
    #[inline(always)]
    pub const fn variant(&self) -> ADCAL_A {
        match self.bits {
            false => ADCAL_A::B_0X0,
            true => ADCAL_A::B_0X1,
        }
    }
    #[doc = "Calibration complete"]
    #[inline(always)]
    pub fn is_b_0x0(&self) -> bool {
        *self == ADCAL_A::B_0X0
    }
    #[doc = "Write 1 to calibrate the ADC. Read at 1 means that a calibration is in progress."]
    #[inline(always)]
    pub fn is_b_0x1(&self) -> bool {
        *self == ADCAL_A::B_0X1
    }
}
#[doc = "Field `ADCAL` writer - ADC calibration This bit is set by software to start the calibration of the ADC. It is cleared by hardware after calibration is complete. Note: The software is allowed to set ADCAL only when the ADC is disabled (ADCAL=0, ADSTART=0, ADSTP=0, ADDIS=0 and ADEN=0). The software is allowed to update the calibration factor by writing ADC_CALFACT only when ADEN=1 and ADSTART=0 (ADC enabled and no conversion is ongoing)."]
pub type ADCAL_W<'a, REG> = crate::BitWriter<'a, REG, ADCAL_A>;
impl<'a, REG> ADCAL_W<'a, REG>
where
    REG: crate::Writable + crate::RegisterSpec,
{
    #[doc = "Calibration complete"]
    #[inline(always)]
    pub fn b_0x0(self) -> &'a mut crate::W<REG> {
        self.variant(ADCAL_A::B_0X0)
    }
    #[doc = "Write 1 to calibrate the ADC. Read at 1 means that a calibration is in progress."]
    #[inline(always)]
    pub fn b_0x1(self) -> &'a mut crate::W<REG> {
        self.variant(ADCAL_A::B_0X1)
    }
}
impl R {
    #[doc = "Bit 0 - ADC enable command This bit is set by software to enable the ADC. The ADC is effectively ready to operate once the ADRDY flag has been set. It is cleared by hardware when the ADC is disabled, after the execution of the ADDIS command. Note: The software is allowed to set ADEN only when all bits of ADC_CR registers are 0 (ADCAL=0, ADSTP=0, ADSTART=0, ADDIS=0 and ADEN=0)"]
    #[inline(always)]
    pub fn aden(&self) -> ADEN_R {
        ADEN_R::new((self.bits & 1) != 0)
    }
    #[doc = "Bit 1 - ADC disable command This bit is set by software to disable the ADC (ADDIS command) and put it into power-down state (OFF state). It is cleared by hardware once the ADC is effectively disabled (ADEN is also cleared by hardware at this time). Note: Setting ADDIS to '1' is only effective when ADEN=1 and ADSTART=0 (which ensures that no conversion is ongoing)"]
    #[inline(always)]
    pub fn addis(&self) -> ADDIS_R {
        ADDIS_R::new(((self.bits >> 1) & 1) != 0)
    }
    #[doc = "Bit 2 - ADC start conversion command This bit is set by software to start ADC conversion. Depending on the EXTEN \\[1:0\\]
configuration bits, a conversion either starts immediately (software trigger configuration) or once a hardware trigger event occurs (hardware trigger configuration). It is cleared by hardware: In single conversion mode (CONT=0, DISCEN=0), when software trigger is selected (EXTEN=00): at the assertion of the end of Conversion Sequence (EOS) flag. In discontinuous conversion mode(CONT=0, DISCEN=1), when the software trigger is selected (EXTEN=00): at the assertion of the end of Conversion (EOC) flag. In all other cases: after the execution of the ADSTP command, at the same time as the ADSTP bit is cleared by hardware. Note: The software is allowed to set ADSTART only when ADEN=1 and ADDIS=0 (ADC is enabled and there is no pending request to disable the ADC). After writing to ADC_CHSELR register or changing CHSELRMOD or SCANDIRW, it is mandatory to wait until CCRDY flag is asserted before setting ADSTART, otherwise, the value written to ADSTART is ignored."]
    #[inline(always)]
    pub fn adstart(&self) -> ADSTART_R {
        ADSTART_R::new(((self.bits >> 2) & 1) != 0)
    }
    #[doc = "Bit 4 - ADC stop conversion command This bit is set by software to stop and discard an ongoing conversion (ADSTP Command). It is cleared by hardware when the conversion is effectively discarded and the ADC is ready to accept a new start conversion command. Note: Setting ADSTP to '1' is only effective when ADSTART=1 and ADDIS=0 (ADC is enabled and may be converting and there is no pending request to disable the ADC)"]
    #[inline(always)]
    pub fn adstp(&self) -> ADSTP_R {
        ADSTP_R::new(((self.bits >> 4) & 1) != 0)
    }
    #[doc = "Bit 28 - ADC Voltage Regulator Enable This bit is set by software, to enable the ADC internal voltage regulator. The voltage regulator output is available after tADCVREG_SETUP. It is cleared by software to disable the voltage regulator. It can be cleared only if ADEN is et to 0. Note: The software is allowed to program this bit field only when the ADC is disabled (ADCAL=0, ADSTART=0, ADSTP=0, ADDIS=0 and ADEN=0)."]
    #[inline(always)]
    pub fn advregen(&self) -> ADVREGEN_R {
        ADVREGEN_R::new(((self.bits >> 28) & 1) != 0)
    }
    #[doc = "Bit 31 - ADC calibration This bit is set by software to start the calibration of the ADC. It is cleared by hardware after calibration is complete. Note: The software is allowed to set ADCAL only when the ADC is disabled (ADCAL=0, ADSTART=0, ADSTP=0, ADDIS=0 and ADEN=0). The software is allowed to update the calibration factor by writing ADC_CALFACT only when ADEN=1 and ADSTART=0 (ADC enabled and no conversion is ongoing)."]
    #[inline(always)]
    pub fn adcal(&self) -> ADCAL_R {
        ADCAL_R::new(((self.bits >> 31) & 1) != 0)
    }
}
impl W {
    #[doc = "Bit 0 - ADC enable command This bit is set by software to enable the ADC. The ADC is effectively ready to operate once the ADRDY flag has been set. It is cleared by hardware when the ADC is disabled, after the execution of the ADDIS command. Note: The software is allowed to set ADEN only when all bits of ADC_CR registers are 0 (ADCAL=0, ADSTP=0, ADSTART=0, ADDIS=0 and ADEN=0)"]
    #[inline(always)]
    #[must_use]
    pub fn aden(&mut self) -> ADEN_W<ADC_CR_SPEC> {
        ADEN_W::new(self, 0)
    }
    #[doc = "Bit 1 - ADC disable command This bit is set by software to disable the ADC (ADDIS command) and put it into power-down state (OFF state). It is cleared by hardware once the ADC is effectively disabled (ADEN is also cleared by hardware at this time). Note: Setting ADDIS to '1' is only effective when ADEN=1 and ADSTART=0 (which ensures that no conversion is ongoing)"]
    #[inline(always)]
    #[must_use]
    pub fn addis(&mut self) -> ADDIS_W<ADC_CR_SPEC> {
        ADDIS_W::new(self, 1)
    }
    #[doc = "Bit 2 - ADC start conversion command This bit is set by software to start ADC conversion. Depending on the EXTEN \\[1:0\\]
configuration bits, a conversion either starts immediately (software trigger configuration) or once a hardware trigger event occurs (hardware trigger configuration). It is cleared by hardware: In single conversion mode (CONT=0, DISCEN=0), when software trigger is selected (EXTEN=00): at the assertion of the end of Conversion Sequence (EOS) flag. In discontinuous conversion mode(CONT=0, DISCEN=1), when the software trigger is selected (EXTEN=00): at the assertion of the end of Conversion (EOC) flag. In all other cases: after the execution of the ADSTP command, at the same time as the ADSTP bit is cleared by hardware. Note: The software is allowed to set ADSTART only when ADEN=1 and ADDIS=0 (ADC is enabled and there is no pending request to disable the ADC). After writing to ADC_CHSELR register or changing CHSELRMOD or SCANDIRW, it is mandatory to wait until CCRDY flag is asserted before setting ADSTART, otherwise, the value written to ADSTART is ignored."]
    #[inline(always)]
    #[must_use]
    pub fn adstart(&mut self) -> ADSTART_W<ADC_CR_SPEC> {
        ADSTART_W::new(self, 2)
    }
    #[doc = "Bit 4 - ADC stop conversion command This bit is set by software to stop and discard an ongoing conversion (ADSTP Command). It is cleared by hardware when the conversion is effectively discarded and the ADC is ready to accept a new start conversion command. Note: Setting ADSTP to '1' is only effective when ADSTART=1 and ADDIS=0 (ADC is enabled and may be converting and there is no pending request to disable the ADC)"]
    #[inline(always)]
    #[must_use]
    pub fn adstp(&mut self) -> ADSTP_W<ADC_CR_SPEC> {
        ADSTP_W::new(self, 4)
    }
    #[doc = "Bit 28 - ADC Voltage Regulator Enable This bit is set by software, to enable the ADC internal voltage regulator. The voltage regulator output is available after tADCVREG_SETUP. It is cleared by software to disable the voltage regulator. It can be cleared only if ADEN is et to 0. Note: The software is allowed to program this bit field only when the ADC is disabled (ADCAL=0, ADSTART=0, ADSTP=0, ADDIS=0 and ADEN=0)."]
    #[inline(always)]
    #[must_use]
    pub fn advregen(&mut self) -> ADVREGEN_W<ADC_CR_SPEC> {
        ADVREGEN_W::new(self, 28)
    }
    #[doc = "Bit 31 - ADC calibration This bit is set by software to start the calibration of the ADC. It is cleared by hardware after calibration is complete. Note: The software is allowed to set ADCAL only when the ADC is disabled (ADCAL=0, ADSTART=0, ADSTP=0, ADDIS=0 and ADEN=0). The software is allowed to update the calibration factor by writing ADC_CALFACT only when ADEN=1 and ADSTART=0 (ADC enabled and no conversion is ongoing)."]
    #[inline(always)]
    #[must_use]
    pub fn adcal(&mut self) -> ADCAL_W<ADC_CR_SPEC> {
        ADCAL_W::new(self, 31)
    }
    #[doc = r" Writes raw bits to the register."]
    #[doc = r""]
    #[doc = r" # Safety"]
    #[doc = r""]
    #[doc = r" Passing incorrect value can cause undefined behaviour. See reference manual"]
    #[inline(always)]
    pub unsafe fn bits(&mut self, bits: u32) -> &mut Self {
        self.bits = bits;
        self
    }
}
#[doc = "ADC control register\n\nYou can [`read`](crate::generic::Reg::read) this register and get [`adc_cr::R`](R).  You can [`reset`](crate::generic::Reg::reset), [`write`](crate::generic::Reg::write), [`write_with_zero`](crate::generic::Reg::write_with_zero) this register using [`adc_cr::W`](W). You can also [`modify`](crate::generic::Reg::modify) this register. See [API](https://docs.rs/svd2rust/#read--modify--write-api)."]
pub struct ADC_CR_SPEC;
impl crate::RegisterSpec for ADC_CR_SPEC {
    type Ux = u32;
}
#[doc = "`read()` method returns [`adc_cr::R`](R) reader structure"]
impl crate::Readable for ADC_CR_SPEC {}
#[doc = "`write(|w| ..)` method takes [`adc_cr::W`](W) writer structure"]
impl crate::Writable for ADC_CR_SPEC {
    const ZERO_TO_MODIFY_FIELDS_BITMAP: u32 = 0;
    const ONE_TO_MODIFY_FIELDS_BITMAP: u32 = 0;
}
#[doc = "`reset()` method sets ADC_CR to value 0"]
impl crate::Resettable for ADC_CR_SPEC {
    const RESET_VALUE: u32 = 0;
}
