RavuAlHemio/eprom5vread/code/on_board/stm32g0b0/src/adc/adc_ier.rs

#[doc = "Register `ADC_IER` reader"]
pub type R = crate::R<ADC_IER_SPEC>;
#[doc = "Register `ADC_IER` writer"]
pub type W = crate::W<ADC_IER_SPEC>;
#[doc = "Field `ADRDYIE` reader - ADC ready interrupt enable This bit is set and cleared by software to enable/disable the ADC Ready interrupt. Note: The software is allowed to write this bit only when ADSTART bit is cleared to 0 (this ensures that no conversion is ongoing)."]
pub type ADRDYIE_R = crate::BitReader<ADRDYIE_A>;
#[doc = "ADC ready interrupt enable This bit is set and cleared by software to enable/disable the ADC Ready interrupt. Note: The software is allowed to write this bit only when ADSTART bit is cleared to 0 (this ensures that no conversion is ongoing).\n\nValue on reset: 0"]
#[derive(Clone, Copy, Debug, PartialEq, Eq)]
pub enum ADRDYIE_A {
    #[doc = "0: ADRDY interrupt disabled."]
    B_0X0 = 0,
    #[doc = "1: ADRDY interrupt enabled. An interrupt is generated when the ADRDY bit is set."]
    B_0X1 = 1,
}
impl From<ADRDYIE_A> for bool {
    #[inline(always)]
    fn from(variant: ADRDYIE_A) -> Self {
        variant as u8 != 0
    }
}
impl ADRDYIE_R {
    #[doc = "Get enumerated values variant"]
    #[inline(always)]
    pub const fn variant(&self) -> ADRDYIE_A {
        match self.bits {
            false => ADRDYIE_A::B_0X0,
            true => ADRDYIE_A::B_0X1,
        }
    }
    #[doc = "ADRDY interrupt disabled."]
    #[inline(always)]
    pub fn is_b_0x0(&self) -> bool {
        *self == ADRDYIE_A::B_0X0
    }
    #[doc = "ADRDY interrupt enabled. An interrupt is generated when the ADRDY bit is set."]
    #[inline(always)]
    pub fn is_b_0x1(&self) -> bool {
        *self == ADRDYIE_A::B_0X1
    }
}
#[doc = "Field `ADRDYIE` writer - ADC ready interrupt enable This bit is set and cleared by software to enable/disable the ADC Ready interrupt. Note: The software is allowed to write this bit only when ADSTART bit is cleared to 0 (this ensures that no conversion is ongoing)."]
pub type ADRDYIE_W<'a, REG> = crate::BitWriter<'a, REG, ADRDYIE_A>;
impl<'a, REG> ADRDYIE_W<'a, REG>
where
    REG: crate::Writable + crate::RegisterSpec,
{
    #[doc = "ADRDY interrupt disabled."]
    #[inline(always)]
    pub fn b_0x0(self) -> &'a mut crate::W<REG> {
        self.variant(ADRDYIE_A::B_0X0)
    }
    #[doc = "ADRDY interrupt enabled. An interrupt is generated when the ADRDY bit is set."]
    #[inline(always)]
    pub fn b_0x1(self) -> &'a mut crate::W<REG> {
        self.variant(ADRDYIE_A::B_0X1)
    }
}
#[doc = "Field `EOSMPIE` reader - End of sampling flag interrupt enable This bit is set and cleared by software to enable/disable the end of the sampling phase interrupt. Note: The software is allowed to write this bit only when ADSTART bit is cleared to 0 (this ensures that no conversion is ongoing)."]
pub type EOSMPIE_R = crate::BitReader<EOSMPIE_A>;
#[doc = "End of sampling flag interrupt enable This bit is set and cleared by software to enable/disable the end of the sampling phase interrupt. Note: The software is allowed to write this bit only when ADSTART bit is cleared to 0 (this ensures that no conversion is ongoing).\n\nValue on reset: 0"]
#[derive(Clone, Copy, Debug, PartialEq, Eq)]
pub enum EOSMPIE_A {
    #[doc = "0: EOSMP interrupt disabled."]
    B_0X0 = 0,
    #[doc = "1: EOSMP interrupt enabled. An interrupt is generated when the EOSMP bit is set."]
    B_0X1 = 1,
}
impl From<EOSMPIE_A> for bool {
    #[inline(always)]
    fn from(variant: EOSMPIE_A) -> Self {
        variant as u8 != 0
    }
}
impl EOSMPIE_R {
    #[doc = "Get enumerated values variant"]
    #[inline(always)]
    pub const fn variant(&self) -> EOSMPIE_A {
        match self.bits {
            false => EOSMPIE_A::B_0X0,
            true => EOSMPIE_A::B_0X1,
        }
    }
    #[doc = "EOSMP interrupt disabled."]
    #[inline(always)]
    pub fn is_b_0x0(&self) -> bool {
        *self == EOSMPIE_A::B_0X0
    }
    #[doc = "EOSMP interrupt enabled. An interrupt is generated when the EOSMP bit is set."]
    #[inline(always)]
    pub fn is_b_0x1(&self) -> bool {
        *self == EOSMPIE_A::B_0X1
    }
}
#[doc = "Field `EOSMPIE` writer - End of sampling flag interrupt enable This bit is set and cleared by software to enable/disable the end of the sampling phase interrupt. Note: The software is allowed to write this bit only when ADSTART bit is cleared to 0 (this ensures that no conversion is ongoing)."]
pub type EOSMPIE_W<'a, REG> = crate::BitWriter<'a, REG, EOSMPIE_A>;
impl<'a, REG> EOSMPIE_W<'a, REG>
where
    REG: crate::Writable + crate::RegisterSpec,
{
    #[doc = "EOSMP interrupt disabled."]
    #[inline(always)]
    pub fn b_0x0(self) -> &'a mut crate::W<REG> {
        self.variant(EOSMPIE_A::B_0X0)
    }
    #[doc = "EOSMP interrupt enabled. An interrupt is generated when the EOSMP bit is set."]
    #[inline(always)]
    pub fn b_0x1(self) -> &'a mut crate::W<REG> {
        self.variant(EOSMPIE_A::B_0X1)
    }
}
#[doc = "Field `EOCIE` reader - End of conversion interrupt enable This bit is set and cleared by software to enable/disable the end of conversion interrupt. Note: The software is allowed to write this bit only when ADSTART bit is cleared to 0 (this ensures that no conversion is ongoing)."]
pub type EOCIE_R = crate::BitReader<EOCIE_A>;
#[doc = "End of conversion interrupt enable This bit is set and cleared by software to enable/disable the end of conversion interrupt. Note: The software is allowed to write this bit only when ADSTART bit is cleared to 0 (this ensures that no conversion is ongoing).\n\nValue on reset: 0"]
#[derive(Clone, Copy, Debug, PartialEq, Eq)]
pub enum EOCIE_A {
    #[doc = "0: EOC interrupt disabled"]
    B_0X0 = 0,
    #[doc = "1: EOC interrupt enabled. An interrupt is generated when the EOC bit is set."]
    B_0X1 = 1,
}
impl From<EOCIE_A> for bool {
    #[inline(always)]
    fn from(variant: EOCIE_A) -> Self {
        variant as u8 != 0
    }
}
impl EOCIE_R {
    #[doc = "Get enumerated values variant"]
    #[inline(always)]
    pub const fn variant(&self) -> EOCIE_A {
        match self.bits {
            false => EOCIE_A::B_0X0,
            true => EOCIE_A::B_0X1,
        }
    }
    #[doc = "EOC interrupt disabled"]
    #[inline(always)]
    pub fn is_b_0x0(&self) -> bool {
        *self == EOCIE_A::B_0X0
    }
    #[doc = "EOC interrupt enabled. An interrupt is generated when the EOC bit is set."]
    #[inline(always)]
    pub fn is_b_0x1(&self) -> bool {
        *self == EOCIE_A::B_0X1
    }
}
#[doc = "Field `EOCIE` writer - End of conversion interrupt enable This bit is set and cleared by software to enable/disable the end of conversion interrupt. Note: The software is allowed to write this bit only when ADSTART bit is cleared to 0 (this ensures that no conversion is ongoing)."]
pub type EOCIE_W<'a, REG> = crate::BitWriter<'a, REG, EOCIE_A>;
impl<'a, REG> EOCIE_W<'a, REG>
where
    REG: crate::Writable + crate::RegisterSpec,
{
    #[doc = "EOC interrupt disabled"]
    #[inline(always)]
    pub fn b_0x0(self) -> &'a mut crate::W<REG> {
        self.variant(EOCIE_A::B_0X0)
    }
    #[doc = "EOC interrupt enabled. An interrupt is generated when the EOC bit is set."]
    #[inline(always)]
    pub fn b_0x1(self) -> &'a mut crate::W<REG> {
        self.variant(EOCIE_A::B_0X1)
    }
}
#[doc = "Field `EOSIE` reader - End of conversion sequence interrupt enable This bit is set and cleared by software to enable/disable the end of sequence of conversions interrupt. Note: The software is allowed to write this bit only when ADSTART bit is cleared to 0 (this ensures that no conversion is ongoing)."]
pub type EOSIE_R = crate::BitReader<EOSIE_A>;
#[doc = "End of conversion sequence interrupt enable This bit is set and cleared by software to enable/disable the end of sequence of conversions interrupt. Note: The software is allowed to write this bit only when ADSTART bit is cleared to 0 (this ensures that no conversion is ongoing).\n\nValue on reset: 0"]
#[derive(Clone, Copy, Debug, PartialEq, Eq)]
pub enum EOSIE_A {
    #[doc = "0: EOS interrupt disabled"]
    B_0X0 = 0,
    #[doc = "1: EOS interrupt enabled. An interrupt is generated when the EOS bit is set."]
    B_0X1 = 1,
}
impl From<EOSIE_A> for bool {
    #[inline(always)]
    fn from(variant: EOSIE_A) -> Self {
        variant as u8 != 0
    }
}
impl EOSIE_R {
    #[doc = "Get enumerated values variant"]
    #[inline(always)]
    pub const fn variant(&self) -> EOSIE_A {
        match self.bits {
            false => EOSIE_A::B_0X0,
            true => EOSIE_A::B_0X1,
        }
    }
    #[doc = "EOS interrupt disabled"]
    #[inline(always)]
    pub fn is_b_0x0(&self) -> bool {
        *self == EOSIE_A::B_0X0
    }
    #[doc = "EOS interrupt enabled. An interrupt is generated when the EOS bit is set."]
    #[inline(always)]
    pub fn is_b_0x1(&self) -> bool {
        *self == EOSIE_A::B_0X1
    }
}
#[doc = "Field `EOSIE` writer - End of conversion sequence interrupt enable This bit is set and cleared by software to enable/disable the end of sequence of conversions interrupt. Note: The software is allowed to write this bit only when ADSTART bit is cleared to 0 (this ensures that no conversion is ongoing)."]
pub type EOSIE_W<'a, REG> = crate::BitWriter<'a, REG, EOSIE_A>;
impl<'a, REG> EOSIE_W<'a, REG>
where
    REG: crate::Writable + crate::RegisterSpec,
{
    #[doc = "EOS interrupt disabled"]
    #[inline(always)]
    pub fn b_0x0(self) -> &'a mut crate::W<REG> {
        self.variant(EOSIE_A::B_0X0)
    }
    #[doc = "EOS interrupt enabled. An interrupt is generated when the EOS bit is set."]
    #[inline(always)]
    pub fn b_0x1(self) -> &'a mut crate::W<REG> {
        self.variant(EOSIE_A::B_0X1)
    }
}
#[doc = "Field `OVRIE` reader - Overrun interrupt enable This bit is set and cleared by software to enable/disable the overrun interrupt. Note: The software is allowed to write this bit only when ADSTART bit is cleared to 0 (this ensures that no conversion is ongoing)."]
pub type OVRIE_R = crate::BitReader<OVRIE_A>;
#[doc = "Overrun interrupt enable This bit is set and cleared by software to enable/disable the overrun interrupt. Note: The software is allowed to write this bit only when ADSTART bit is cleared to 0 (this ensures that no conversion is ongoing).\n\nValue on reset: 0"]
#[derive(Clone, Copy, Debug, PartialEq, Eq)]
pub enum OVRIE_A {
    #[doc = "0: Overrun interrupt disabled"]
    B_0X0 = 0,
    #[doc = "1: Overrun interrupt enabled. An interrupt is generated when the OVR bit is set."]
    B_0X1 = 1,
}
impl From<OVRIE_A> for bool {
    #[inline(always)]
    fn from(variant: OVRIE_A) -> Self {
        variant as u8 != 0
    }
}
impl OVRIE_R {
    #[doc = "Get enumerated values variant"]
    #[inline(always)]
    pub const fn variant(&self) -> OVRIE_A {
        match self.bits {
            false => OVRIE_A::B_0X0,
            true => OVRIE_A::B_0X1,
        }
    }
    #[doc = "Overrun interrupt disabled"]
    #[inline(always)]
    pub fn is_b_0x0(&self) -> bool {
        *self == OVRIE_A::B_0X0
    }
    #[doc = "Overrun interrupt enabled. An interrupt is generated when the OVR bit is set."]
    #[inline(always)]
    pub fn is_b_0x1(&self) -> bool {
        *self == OVRIE_A::B_0X1
    }
}
#[doc = "Field `OVRIE` writer - Overrun interrupt enable This bit is set and cleared by software to enable/disable the overrun interrupt. Note: The software is allowed to write this bit only when ADSTART bit is cleared to 0 (this ensures that no conversion is ongoing)."]
pub type OVRIE_W<'a, REG> = crate::BitWriter<'a, REG, OVRIE_A>;
impl<'a, REG> OVRIE_W<'a, REG>
where
    REG: crate::Writable + crate::RegisterSpec,
{
    #[doc = "Overrun interrupt disabled"]
    #[inline(always)]
    pub fn b_0x0(self) -> &'a mut crate::W<REG> {
        self.variant(OVRIE_A::B_0X0)
    }
    #[doc = "Overrun interrupt enabled. An interrupt is generated when the OVR bit is set."]
    #[inline(always)]
    pub fn b_0x1(self) -> &'a mut crate::W<REG> {
        self.variant(OVRIE_A::B_0X1)
    }
}
#[doc = "Field `AWD1IE` reader - Analog watchdog 1 interrupt enable This bit is set and cleared by software to enable/disable the analog watchdog interrupt. Note: The Software is allowed to write this bit only when ADSTART bit is cleared to 0 (this ensures that no conversion is ongoing)."]
pub type AWD1IE_R = crate::BitReader<AWD1IE_A>;
#[doc = "Analog watchdog 1 interrupt enable This bit is set and cleared by software to enable/disable the analog watchdog interrupt. Note: The Software is allowed to write this bit only when ADSTART bit is cleared to 0 (this ensures that no conversion is ongoing).\n\nValue on reset: 0"]
#[derive(Clone, Copy, Debug, PartialEq, Eq)]
pub enum AWD1IE_A {
    #[doc = "0: Analog watchdog interrupt disabled"]
    B_0X0 = 0,
    #[doc = "1: Analog watchdog interrupt enabled"]
    B_0X1 = 1,
}
impl From<AWD1IE_A> for bool {
    #[inline(always)]
    fn from(variant: AWD1IE_A) -> Self {
        variant as u8 != 0
    }
}
impl AWD1IE_R {
    #[doc = "Get enumerated values variant"]
    #[inline(always)]
    pub const fn variant(&self) -> AWD1IE_A {
        match self.bits {
            false => AWD1IE_A::B_0X0,
            true => AWD1IE_A::B_0X1,
        }
    }
    #[doc = "Analog watchdog interrupt disabled"]
    #[inline(always)]
    pub fn is_b_0x0(&self) -> bool {
        *self == AWD1IE_A::B_0X0
    }
    #[doc = "Analog watchdog interrupt enabled"]
    #[inline(always)]
    pub fn is_b_0x1(&self) -> bool {
        *self == AWD1IE_A::B_0X1
    }
}
#[doc = "Field `AWD1IE` writer - Analog watchdog 1 interrupt enable This bit is set and cleared by software to enable/disable the analog watchdog interrupt. Note: The Software is allowed to write this bit only when ADSTART bit is cleared to 0 (this ensures that no conversion is ongoing)."]
pub type AWD1IE_W<'a, REG> = crate::BitWriter<'a, REG, AWD1IE_A>;
impl<'a, REG> AWD1IE_W<'a, REG>
where
    REG: crate::Writable + crate::RegisterSpec,
{
    #[doc = "Analog watchdog interrupt disabled"]
    #[inline(always)]
    pub fn b_0x0(self) -> &'a mut crate::W<REG> {
        self.variant(AWD1IE_A::B_0X0)
    }
    #[doc = "Analog watchdog interrupt enabled"]
    #[inline(always)]
    pub fn b_0x1(self) -> &'a mut crate::W<REG> {
        self.variant(AWD1IE_A::B_0X1)
    }
}
#[doc = "Field `AWD2IE` reader - Analog watchdog 2 interrupt enable This bit is set and cleared by software to enable/disable the analog watchdog interrupt. Note: The Software is allowed to write this bit only when ADSTART bit is cleared to 0 (this ensures that no conversion is ongoing)."]
pub type AWD2IE_R = crate::BitReader<AWD2IE_A>;
#[doc = "Analog watchdog 2 interrupt enable This bit is set and cleared by software to enable/disable the analog watchdog interrupt. Note: The Software is allowed to write this bit only when ADSTART bit is cleared to 0 (this ensures that no conversion is ongoing).\n\nValue on reset: 0"]
#[derive(Clone, Copy, Debug, PartialEq, Eq)]
pub enum AWD2IE_A {
    #[doc = "0: Analog watchdog interrupt disabled"]
    B_0X0 = 0,
    #[doc = "1: Analog watchdog interrupt enabled"]
    B_0X1 = 1,
}
impl From<AWD2IE_A> for bool {
    #[inline(always)]
    fn from(variant: AWD2IE_A) -> Self {
        variant as u8 != 0
    }
}
impl AWD2IE_R {
    #[doc = "Get enumerated values variant"]
    #[inline(always)]
    pub const fn variant(&self) -> AWD2IE_A {
        match self.bits {
            false => AWD2IE_A::B_0X0,
            true => AWD2IE_A::B_0X1,
        }
    }
    #[doc = "Analog watchdog interrupt disabled"]
    #[inline(always)]
    pub fn is_b_0x0(&self) -> bool {
        *self == AWD2IE_A::B_0X0
    }
    #[doc = "Analog watchdog interrupt enabled"]
    #[inline(always)]
    pub fn is_b_0x1(&self) -> bool {
        *self == AWD2IE_A::B_0X1
    }
}
#[doc = "Field `AWD2IE` writer - Analog watchdog 2 interrupt enable This bit is set and cleared by software to enable/disable the analog watchdog interrupt. Note: The Software is allowed to write this bit only when ADSTART bit is cleared to 0 (this ensures that no conversion is ongoing)."]
pub type AWD2IE_W<'a, REG> = crate::BitWriter<'a, REG, AWD2IE_A>;
impl<'a, REG> AWD2IE_W<'a, REG>
where
    REG: crate::Writable + crate::RegisterSpec,
{
    #[doc = "Analog watchdog interrupt disabled"]
    #[inline(always)]
    pub fn b_0x0(self) -> &'a mut crate::W<REG> {
        self.variant(AWD2IE_A::B_0X0)
    }
    #[doc = "Analog watchdog interrupt enabled"]
    #[inline(always)]
    pub fn b_0x1(self) -> &'a mut crate::W<REG> {
        self.variant(AWD2IE_A::B_0X1)
    }
}
#[doc = "Field `AWD3IE` reader - Analog watchdog 3 interrupt enable This bit is set and cleared by software to enable/disable the analog watchdog interrupt. Note: The Software is allowed to write this bit only when ADSTART bit is cleared to 0 (this ensures that no conversion is ongoing)."]
pub type AWD3IE_R = crate::BitReader<AWD3IE_A>;
#[doc = "Analog watchdog 3 interrupt enable This bit is set and cleared by software to enable/disable the analog watchdog interrupt. Note: The Software is allowed to write this bit only when ADSTART bit is cleared to 0 (this ensures that no conversion is ongoing).\n\nValue on reset: 0"]
#[derive(Clone, Copy, Debug, PartialEq, Eq)]
pub enum AWD3IE_A {
    #[doc = "0: Analog watchdog interrupt disabled"]
    B_0X0 = 0,
    #[doc = "1: Analog watchdog interrupt enabled"]
    B_0X1 = 1,
}
impl From<AWD3IE_A> for bool {
    #[inline(always)]
    fn from(variant: AWD3IE_A) -> Self {
        variant as u8 != 0
    }
}
impl AWD3IE_R {
    #[doc = "Get enumerated values variant"]
    #[inline(always)]
    pub const fn variant(&self) -> AWD3IE_A {
        match self.bits {
            false => AWD3IE_A::B_0X0,
            true => AWD3IE_A::B_0X1,
        }
    }
    #[doc = "Analog watchdog interrupt disabled"]
    #[inline(always)]
    pub fn is_b_0x0(&self) -> bool {
        *self == AWD3IE_A::B_0X0
    }
    #[doc = "Analog watchdog interrupt enabled"]
    #[inline(always)]
    pub fn is_b_0x1(&self) -> bool {
        *self == AWD3IE_A::B_0X1
    }
}
#[doc = "Field `AWD3IE` writer - Analog watchdog 3 interrupt enable This bit is set and cleared by software to enable/disable the analog watchdog interrupt. Note: The Software is allowed to write this bit only when ADSTART bit is cleared to 0 (this ensures that no conversion is ongoing)."]
pub type AWD3IE_W<'a, REG> = crate::BitWriter<'a, REG, AWD3IE_A>;
impl<'a, REG> AWD3IE_W<'a, REG>
where
    REG: crate::Writable + crate::RegisterSpec,
{
    #[doc = "Analog watchdog interrupt disabled"]
    #[inline(always)]
    pub fn b_0x0(self) -> &'a mut crate::W<REG> {
        self.variant(AWD3IE_A::B_0X0)
    }
    #[doc = "Analog watchdog interrupt enabled"]
    #[inline(always)]
    pub fn b_0x1(self) -> &'a mut crate::W<REG> {
        self.variant(AWD3IE_A::B_0X1)
    }
}
#[doc = "Field `EOCALIE` reader - End of calibration interrupt enable This bit is set and cleared by software to enable/disable the end of calibration interrupt. Note: The software is allowed to write this bit only when ADSTART bit is cleared to 0 (this ensures that no conversion is ongoing)."]
pub type EOCALIE_R = crate::BitReader<EOCALIE_A>;
#[doc = "End of calibration interrupt enable This bit is set and cleared by software to enable/disable the end of calibration interrupt. Note: The software is allowed to write this bit only when ADSTART bit is cleared to 0 (this ensures that no conversion is ongoing).\n\nValue on reset: 0"]
#[derive(Clone, Copy, Debug, PartialEq, Eq)]
pub enum EOCALIE_A {
    #[doc = "0: End of calibration interrupt disabled"]
    B_0X0 = 0,
    #[doc = "1: End of calibration interrupt enabled"]
    B_0X1 = 1,
}
impl From<EOCALIE_A> for bool {
    #[inline(always)]
    fn from(variant: EOCALIE_A) -> Self {
        variant as u8 != 0
    }
}
impl EOCALIE_R {
    #[doc = "Get enumerated values variant"]
    #[inline(always)]
    pub const fn variant(&self) -> EOCALIE_A {
        match self.bits {
            false => EOCALIE_A::B_0X0,
            true => EOCALIE_A::B_0X1,
        }
    }
    #[doc = "End of calibration interrupt disabled"]
    #[inline(always)]
    pub fn is_b_0x0(&self) -> bool {
        *self == EOCALIE_A::B_0X0
    }
    #[doc = "End of calibration interrupt enabled"]
    #[inline(always)]
    pub fn is_b_0x1(&self) -> bool {
        *self == EOCALIE_A::B_0X1
    }
}
#[doc = "Field `EOCALIE` writer - End of calibration interrupt enable This bit is set and cleared by software to enable/disable the end of calibration interrupt. Note: The software is allowed to write this bit only when ADSTART bit is cleared to 0 (this ensures that no conversion is ongoing)."]
pub type EOCALIE_W<'a, REG> = crate::BitWriter<'a, REG, EOCALIE_A>;
impl<'a, REG> EOCALIE_W<'a, REG>
where
    REG: crate::Writable + crate::RegisterSpec,
{
    #[doc = "End of calibration interrupt disabled"]
    #[inline(always)]
    pub fn b_0x0(self) -> &'a mut crate::W<REG> {
        self.variant(EOCALIE_A::B_0X0)
    }
    #[doc = "End of calibration interrupt enabled"]
    #[inline(always)]
    pub fn b_0x1(self) -> &'a mut crate::W<REG> {
        self.variant(EOCALIE_A::B_0X1)
    }
}
#[doc = "Field `CCRDYIE` reader - Channel Configuration Ready Interrupt enable This bit is set and cleared by software to enable/disable the channel configuration ready interrupt. Note: The software is allowed to write this bit only when ADSTART bit is cleared to 0 (this ensures that no conversion is ongoing)."]
pub type CCRDYIE_R = crate::BitReader<CCRDYIE_A>;
#[doc = "Channel Configuration Ready Interrupt enable This bit is set and cleared by software to enable/disable the channel configuration ready interrupt. Note: The software is allowed to write this bit only when ADSTART bit is cleared to 0 (this ensures that no conversion is ongoing).\n\nValue on reset: 0"]
#[derive(Clone, Copy, Debug, PartialEq, Eq)]
pub enum CCRDYIE_A {
    #[doc = "0: Channel configuration ready interrupt disabled"]
    B_0X0 = 0,
    #[doc = "1: Channel configuration ready interrupt enabled"]
    B_0X1 = 1,
}
impl From<CCRDYIE_A> for bool {
    #[inline(always)]
    fn from(variant: CCRDYIE_A) -> Self {
        variant as u8 != 0
    }
}
impl CCRDYIE_R {
    #[doc = "Get enumerated values variant"]
    #[inline(always)]
    pub const fn variant(&self) -> CCRDYIE_A {
        match self.bits {
            false => CCRDYIE_A::B_0X0,
            true => CCRDYIE_A::B_0X1,
        }
    }
    #[doc = "Channel configuration ready interrupt disabled"]
    #[inline(always)]
    pub fn is_b_0x0(&self) -> bool {
        *self == CCRDYIE_A::B_0X0
    }
    #[doc = "Channel configuration ready interrupt enabled"]
    #[inline(always)]
    pub fn is_b_0x1(&self) -> bool {
        *self == CCRDYIE_A::B_0X1
    }
}
#[doc = "Field `CCRDYIE` writer - Channel Configuration Ready Interrupt enable This bit is set and cleared by software to enable/disable the channel configuration ready interrupt. Note: The software is allowed to write this bit only when ADSTART bit is cleared to 0 (this ensures that no conversion is ongoing)."]
pub type CCRDYIE_W<'a, REG> = crate::BitWriter<'a, REG, CCRDYIE_A>;
impl<'a, REG> CCRDYIE_W<'a, REG>
where
    REG: crate::Writable + crate::RegisterSpec,
{
    #[doc = "Channel configuration ready interrupt disabled"]
    #[inline(always)]
    pub fn b_0x0(self) -> &'a mut crate::W<REG> {
        self.variant(CCRDYIE_A::B_0X0)
    }
    #[doc = "Channel configuration ready interrupt enabled"]
    #[inline(always)]
    pub fn b_0x1(self) -> &'a mut crate::W<REG> {
        self.variant(CCRDYIE_A::B_0X1)
    }
}
impl R {
    #[doc = "Bit 0 - ADC ready interrupt enable This bit is set and cleared by software to enable/disable the ADC Ready interrupt. Note: The software is allowed to write this bit only when ADSTART bit is cleared to 0 (this ensures that no conversion is ongoing)."]
    #[inline(always)]
    pub fn adrdyie(&self) -> ADRDYIE_R {
        ADRDYIE_R::new((self.bits & 1) != 0)
    }
    #[doc = "Bit 1 - End of sampling flag interrupt enable This bit is set and cleared by software to enable/disable the end of the sampling phase interrupt. Note: The software is allowed to write this bit only when ADSTART bit is cleared to 0 (this ensures that no conversion is ongoing)."]
    #[inline(always)]
    pub fn eosmpie(&self) -> EOSMPIE_R {
        EOSMPIE_R::new(((self.bits >> 1) & 1) != 0)
    }
    #[doc = "Bit 2 - End of conversion interrupt enable This bit is set and cleared by software to enable/disable the end of conversion interrupt. Note: The software is allowed to write this bit only when ADSTART bit is cleared to 0 (this ensures that no conversion is ongoing)."]
    #[inline(always)]
    pub fn eocie(&self) -> EOCIE_R {
        EOCIE_R::new(((self.bits >> 2) & 1) != 0)
    }
    #[doc = "Bit 3 - End of conversion sequence interrupt enable This bit is set and cleared by software to enable/disable the end of sequence of conversions interrupt. Note: The software is allowed to write this bit only when ADSTART bit is cleared to 0 (this ensures that no conversion is ongoing)."]
    #[inline(always)]
    pub fn eosie(&self) -> EOSIE_R {
        EOSIE_R::new(((self.bits >> 3) & 1) != 0)
    }
    #[doc = "Bit 4 - Overrun interrupt enable This bit is set and cleared by software to enable/disable the overrun interrupt. Note: The software is allowed to write this bit only when ADSTART bit is cleared to 0 (this ensures that no conversion is ongoing)."]
    #[inline(always)]
    pub fn ovrie(&self) -> OVRIE_R {
        OVRIE_R::new(((self.bits >> 4) & 1) != 0)
    }
    #[doc = "Bit 7 - Analog watchdog 1 interrupt enable This bit is set and cleared by software to enable/disable the analog watchdog interrupt. Note: The Software is allowed to write this bit only when ADSTART bit is cleared to 0 (this ensures that no conversion is ongoing)."]
    #[inline(always)]
    pub fn awd1ie(&self) -> AWD1IE_R {
        AWD1IE_R::new(((self.bits >> 7) & 1) != 0)
    }
    #[doc = "Bit 8 - Analog watchdog 2 interrupt enable This bit is set and cleared by software to enable/disable the analog watchdog interrupt. Note: The Software is allowed to write this bit only when ADSTART bit is cleared to 0 (this ensures that no conversion is ongoing)."]
    #[inline(always)]
    pub fn awd2ie(&self) -> AWD2IE_R {
        AWD2IE_R::new(((self.bits >> 8) & 1) != 0)
    }
    #[doc = "Bit 9 - Analog watchdog 3 interrupt enable This bit is set and cleared by software to enable/disable the analog watchdog interrupt. Note: The Software is allowed to write this bit only when ADSTART bit is cleared to 0 (this ensures that no conversion is ongoing)."]
    #[inline(always)]
    pub fn awd3ie(&self) -> AWD3IE_R {
        AWD3IE_R::new(((self.bits >> 9) & 1) != 0)
    }
    #[doc = "Bit 11 - End of calibration interrupt enable This bit is set and cleared by software to enable/disable the end of calibration interrupt. Note: The software is allowed to write this bit only when ADSTART bit is cleared to 0 (this ensures that no conversion is ongoing)."]
    #[inline(always)]
    pub fn eocalie(&self) -> EOCALIE_R {
        EOCALIE_R::new(((self.bits >> 11) & 1) != 0)
    }
    #[doc = "Bit 13 - Channel Configuration Ready Interrupt enable This bit is set and cleared by software to enable/disable the channel configuration ready interrupt. Note: The software is allowed to write this bit only when ADSTART bit is cleared to 0 (this ensures that no conversion is ongoing)."]
    #[inline(always)]
    pub fn ccrdyie(&self) -> CCRDYIE_R {
        CCRDYIE_R::new(((self.bits >> 13) & 1) != 0)
    }
}
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
