RavuAlHemio/eprom5vread/code/on_board/stm32g0b0/src/adc/adc_isr.rs

#[doc = "Register `ADC_ISR` reader"]
pub type R = crate::R<ADC_ISR_SPEC>;
#[doc = "Register `ADC_ISR` writer"]
pub type W = crate::W<ADC_ISR_SPEC>;
#[doc = "Field `ADRDY` reader - ADC ready This bit is set by hardware after the ADC has been enabled (ADEN=1) and when the ADC reaches a state where it is ready to accept conversion requests. It is cleared by software writing 1 to it."]
pub type ADRDY_R = crate::BitReader<ADRDY_A>;
#[doc = "ADC ready This bit is set by hardware after the ADC has been enabled (ADEN=1) and when the ADC reaches a state where it is ready to accept conversion requests. It is cleared by software writing 1 to it.\n\nValue on reset: 0"]
#[derive(Clone, Copy, Debug, PartialEq, Eq)]
pub enum ADRDY_A {
    #[doc = "0: ADC not yet ready to start conversion (or the flag event was already acknowledged and cleared by software)"]
    B_0X0 = 0,
    #[doc = "1: ADC is ready to start conversion"]
    B_0X1 = 1,
}
impl From<ADRDY_A> for bool {
    #[inline(always)]
    fn from(variant: ADRDY_A) -> Self {
        variant as u8 != 0
    }
}
impl ADRDY_R {
    #[doc = "Get enumerated values variant"]
    #[inline(always)]
    pub const fn variant(&self) -> ADRDY_A {
        match self.bits {
            false => ADRDY_A::B_0X0,
            true => ADRDY_A::B_0X1,
        }
    }
    #[doc = "ADC not yet ready to start conversion (or the flag event was already acknowledged and cleared by software)"]
    #[inline(always)]
    pub fn is_b_0x0(&self) -> bool {
        *self == ADRDY_A::B_0X0
    }
    #[doc = "ADC is ready to start conversion"]
    #[inline(always)]
    pub fn is_b_0x1(&self) -> bool {
        *self == ADRDY_A::B_0X1
    }
}
#[doc = "Field `ADRDY` writer - ADC ready This bit is set by hardware after the ADC has been enabled (ADEN=1) and when the ADC reaches a state where it is ready to accept conversion requests. It is cleared by software writing 1 to it."]
pub type ADRDY_W<'a, REG> = crate::BitWriter<'a, REG, ADRDY_A>;
impl<'a, REG> ADRDY_W<'a, REG>
where
    REG: crate::Writable + crate::RegisterSpec,
{
    #[doc = "ADC not yet ready to start conversion (or the flag event was already acknowledged and cleared by software)"]
    #[inline(always)]
    pub fn b_0x0(self) -> &'a mut crate::W<REG> {
        self.variant(ADRDY_A::B_0X0)
    }
    #[doc = "ADC is ready to start conversion"]
    #[inline(always)]
    pub fn b_0x1(self) -> &'a mut crate::W<REG> {
        self.variant(ADRDY_A::B_0X1)
    }
}
#[doc = "Field `EOSMP` reader - End of sampling flag This bit is set by hardware during the conversion, at the end of the sampling phase.It is cleared by software by programming it to '1'."]
pub type EOSMP_R = crate::BitReader<EOSMP_A>;
#[doc = "End of sampling flag This bit is set by hardware during the conversion, at the end of the sampling phase.It is cleared by software by programming it to '1'.\n\nValue on reset: 0"]
#[derive(Clone, Copy, Debug, PartialEq, Eq)]
pub enum EOSMP_A {
    #[doc = "0: Not at the end of the sampling phase (or the flag event was already acknowledged and cleared by software)"]
    B_0X0 = 0,
    #[doc = "1: End of sampling phase reached"]
    B_0X1 = 1,
}
impl From<EOSMP_A> for bool {
    #[inline(always)]
    fn from(variant: EOSMP_A) -> Self {
        variant as u8 != 0
    }
}
impl EOSMP_R {
    #[doc = "Get enumerated values variant"]
    #[inline(always)]
    pub const fn variant(&self) -> EOSMP_A {
        match self.bits {
            false => EOSMP_A::B_0X0,
            true => EOSMP_A::B_0X1,
        }
    }
    #[doc = "Not at the end of the sampling phase (or the flag event was already acknowledged and cleared by software)"]
    #[inline(always)]
    pub fn is_b_0x0(&self) -> bool {
        *self == EOSMP_A::B_0X0
    }
    #[doc = "End of sampling phase reached"]
    #[inline(always)]
    pub fn is_b_0x1(&self) -> bool {
        *self == EOSMP_A::B_0X1
    }
}
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
