RavuAlHemio/eprom5vread/(commit log)

2024-01-29 initial commit (WIP board)
    [eprom.kicad_sch, eprom5vread.kicad_pcb, eprom5vread.kicad_sch, mcu.kicad_sch, mcu_power.kicad_sch, power_supply.kicad_sch]
2024-01-29 initial board layout (WIP), schematic tuning
    [eprom.kicad_sch, eprom5vread.kicad_pcb, eprom5vread.kicad_sch, mcu.kicad_sch, mcu_debug.kicad_sch, mcu_power.kicad_sch, mcu_reset.kicad_sch]
2024-01-30 finish board design
    [eprom.kicad_sch, eprom5vread.kicad_pcb, eprom5vread.kicad_sch, mcu.kicad_sch, mcu_debug.kicad_sch, mcu_power.kicad_sch, mcu_reset.kicad_sch, power_supply.kicad_sch]
2024-02-01 pcb: add ROM pin hints
    [eprom5vread.kicad_pcb]
2024-02-02 code: UART initialization
2024-02-02 add Unix stm32g0b0 regeneration script
